VictoriacTorres/euVNA/Tesis/Thesis.tex

\documentclass[11pt,a4paper, table, dvipsnames]{report}
\usepackage{graphicx,float}
\usepackage{wrapfig}
\floatplacement{figure}{H}
\floatplacement{table}{H}
\usepackage[hidelinks]{hyperref}
\usepackage[margin=2.5cm]{geometry}
\usepackage{fancyhdr}
\usepackage{mathtools}

%Configuración general
\pagestyle{fancy}
\fancyhf{}
\fancyfoot[R]{\thepage}
\renewcommand{\headrulewidth}{0pt}
\renewcommand{\footrulewidth}{0pt}

\fancypagestyle{plain}{
    \fancyhf{}
    \fancyfoot[R]{\thepage}
    \renewcommand{\headrulewidth}{0pt}
}

\usepackage{ragged2e}
\usepackage[T1]{fontenc}
\usepackage[utf8]{inputenc}
\usepackage{xcolor}
\usepackage{tabularx} 
\usepackage{url}
\usepackage{caption}
\usepackage{subcaption}
\usepackage{amsmath,amssymb}
\usepackage{indentfirst}
\usepackage{pdfpages}
\usepackage{amsmath}
\usepackage{comment}
\setcounter{secnumdepth}{5}
\setcounter{tocdepth}{5}

%Bibliografia
\usepackage[style=numeric, backend=biber, sorting=none]{biblatex}
\addbibresource{Bibliografia.bib}
\usepackage{hyperref}
\usepackage{xurl}   % después de hyperref
\setcounter{biburlnumpenalty}{100}
\setcounter{biburlucpenalty}{100}
\setcounter{biburllcpenalty}{100}

%Formato codigo
\usepackage{minted}
\usemintedstyle{emacs}

\numberwithin{equation}{section}
\renewcommand{\contentsname}{Índice}
% Portada
\fancypagestyle{firstpage}{
    \fancyhf{}
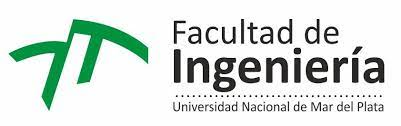
[picture p1: Tesis/Imagenes/fi.jpg]
    \lhead{}
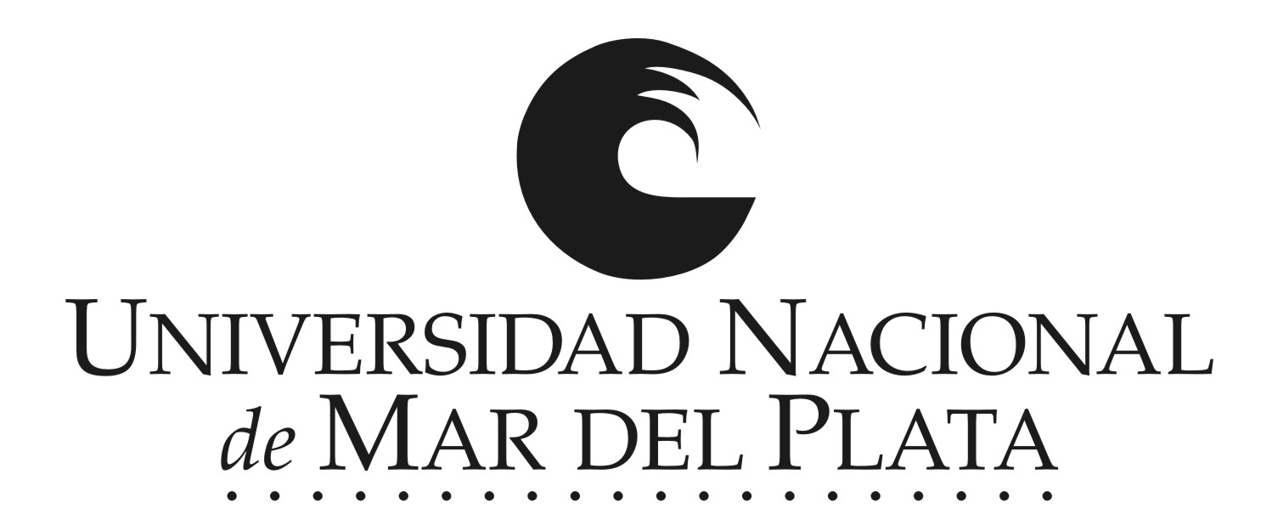
[picture p2: Tesis/Imagenes/UNMDP_BW.jpg]
    \rhead{}
    \renewcommand{\headrulewidth}{0pt}
}
\captionsetup[figure]{name={Figura}}

\newcommand{\Thesis}{Desarrollo de un Analizador Vectorial de Redes para medición no invasiva de glucemia}
\newcommand{\Degree}{Ingeniería Electrónica}
\newcommand{\Name}{Victoria Carla Torres}
\newcommand{\Department}{Departamento de Ingeniería Electrónica y Computación}
\newcommand{\Universidad}{Universidad Nacional de Mar del Plata}
\newcommand{\Place}{Facultad de Ingeniería}
\newcommand{\Fecha}{Noviembre 2026}

\begin{document}

%========= Title Page =========
\begin{titlepage}
\thispagestyle{firstpage}
\pagestyle{empty}
\vspace*{3cm}
\centering

\begin{huge}
\textsc{\Universidad}\\
\vspace{1cm}      
\text{Facultad de Ingeniería}
\end{huge}

\vspace{1cm}

\begin{LARGE}
\begin{center} \text{Trabajo final} \end{center}
\hrule
\vspace{8pt}
\textbf{\Thesis}
\end{LARGE}
\vspace{10pt}
\hrule
\vspace*{\fill}

\begin{Large}
\textbf{\Name}\\[6pt]
\text{Director: Ramiro Avalos Ribas}\\
\text{Codirector: Brian Maximiliano Gluzman}
\end{Large}
\vfill

\begin{figure}[H]
\center
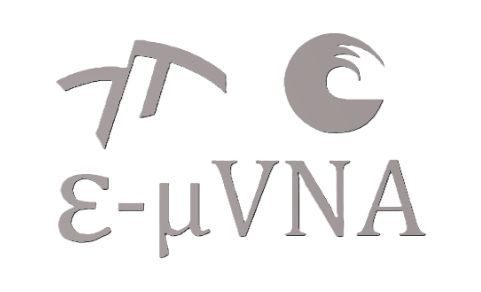
[picture p3: Tesis/Imagenes/Logo.png]

\end{figure}
\vspace{\fill}

\begin{Large}
\text{\Degree}\\
\Department\\
\Fecha\\
\end{Large}

\end{titlepage}
\pagestyle{empty}
\pagenumbering{arabic}
\pagestyle{fancy}
\renewcommand{\chaptername}{Capítulo}

%=============== Agradecimientos ===============
\addcontentsline{toc}{chapter}{Agradecimientos}
{\Huge\bfseries Agradecimientos\par}
\vspace{1.5cm}
\input{Capitulos/Agradecimientos}
\pagebreak

%======== Indice ==================
\tableofcontents
\pagebreak

%========Tabla de siglas================
\addcontentsline{toc}{chapter}{Siglas y abreviaturas}
{\Huge\bfseries Siglas y abreviaturas\par}
\vspace{1.5cm}
\begin{center}
\begin{tabularx}{\textwidth}{|X|X|}
\arrayrulecolor{Thistle}
\hline
\rowcolor{Thistle!20}
\hline 
\textbf{Nombre}  & \textbf{Descripción}  \\
\hline
VNA & Analizador Vectorial de Redes\\
\hline
UHF & Ultra High Frequency (Frecuencia Ultra Alta)\\
\hline
CGM & Continous Glucose Monitoring (Monitoreo Continuo de Glucosa) \\
\hline
CONICET & Consejo Nacional de Investigaciones Científicas y Técnicas \\
\hline
LAC & Laboratorio de Comunicaciones\\
\hline
ICYTE & Instituto de Investigaciones Científicas y Tecnológicas en Electrónica \\
\hline
UNMDP & Universidad Nacional de Mar del Plata \\
\hline
FI & Frecuencia Intermedia\\
\hline
DUT & Device Under Test (Sistema bajo prueba)\\
\hline
RF & Radiofrecuencia \\
\hline
SOL & Short, Open, Load (Corto, Abierto, Carga) \\
\hline
PCB & Printed Circuit Board (Placa de Circuito Impreso) \\
\hline
SMD & Surface-Mount Device (Dispositivo de Montaje Superficial)\\
\hline
USB & Universal Serial Bus (Bus Universal en Serie)\\
\hline
CPU & Central Processing Unit (Unidad de Procesamiento Central) \\
\hline
CLK & Clock (señal de reloj) \\
\hline
OL & Oscilador Local \\
\hline
FIR & Finite Impulse Response (Respuesta al Impulso Finita)\\
\hline
FFT & Fast Fourier Transform (Transformada Rápida de Fourier)\\
\hline
IC & Integrated Circuits (Circuitos Integrados)\\
\hline
VCO & Voltage Controlled Oscillator (Oscilador controlado por voltaje)\\
\hline
PFD & Phase Frequency Detector (Detector de fase y frecuencia) \\
\hline
SMA & SubMiniature version A\\
\hline
SPI & Serial Peripheral Interface (Interfaz Periférica en Serie)\\
\hline
CSV & Comma-Separated Values (Valores separados por coma)\\
\hline
IA & Inteligencia Artificial\\
\hline
GUI & Graphical User Interface (Interfaz Gráfica de Usuario)\\
\hline
QFN & Quad Flat No-Lead (Encapsulado plano cuádruple sin terminales) \\
\hline
ADC & Analog-to-Digital Converter (Conversor Analógico-Digital)\\
\hline

\end{tabularx}
\end{center}

%======= Resumen =======
\addcontentsline{toc}{chapter}{Resumen}
\chapter*{Resumen}

El proyecto propone el diseño, implementación, calibración y ensayo de un Analizador Vectorial de Redes (VNA) de un puerto, que opere en una banda de frecuencias UHF (Ultra High Frequency) que va desde los 1,8 hasta los 2,2 GHz, adaptado para operar en conjunto con un sensor de glucemia no invasivo.

El principio de medición se basa en la existencia de una correlación entre la concentración de glucosa en sangre y sus propiedades eléctricas (permitividad relativa y conductividad) \cite{Topsakal}, por lo que es razonable suponer que las variaciones en la composición dieléctrica de una muestra de tejido biológico pueden alterar la distribución de los campos electromagnéticos presentes en un sensor de microondas.

La implementación se realiza en una placa de circuito impreso, con circuitos integrados especializados y aplicando técnicas de reflectometría, diseño en radiofrecuencia y manejo de emisiones electromagnéticas.

Se obtienen señales analógicas en la banda de audio para su adquisición en la placa de sonido de una PC. Luego, el análisis de las señales es puramente digital. Se aplica un procesamiento basado en la Transformada Rápida de Fourier (FFT) para obtener el coeficiente de reflexión del sistema bajo prueba en función de la frecuencia.
 
\pagebreak

%=========== Introducción ===========
\chapter{Introducción}
\input{Capitulos/Introducción}
\pagebreak

%============= Marco teórico ==========
\chapter{Marco teórico}
\input{Capitulos/Marco teórico}
\pagebreak

%=============== Proyecto ===============
\chapter{Proyecto}
\input{Capitulos/Proyecto}
\pagebreak

%========= Evaluation =========
\chapter{Resultados}
\input{Capitulos/Resultados.tex}
\pagebreak

%========== Conclusiones y trabajos futuros ==========
\chapter{Conclusiones y trabajos futuros}
\input{Capitulos/Conclusiones.tex}
\pagebreak

%========== Esquemáticos y código ==========
\chapter{Esquemáticos}

\section{Esquemáticos Altium}
\label{sec:EsquematicosAltium}
A continuación se presentan los esquemáticos de los distintos bloques funcionales del sistema, exportados de Altium Designer. 

%\begin{comment}
\includepdf[
    pages=-,
    angle=90,
    fitpaper=true,
    addtotoc={
        1, subsection, 2, Generador de RF incidente (ADF4351), sch:ADFRF,
        2, subsection, 2, Generador de RF Oscilador Local (ADF4351), sch:ADFOL,
        3, subsection, 2, Mezclador, sch:mix,
        4, subsection, 2, Alimentación y CLK, sch:alimentacion,
        5, subsection, 2, Acoplador Direccional, sch:acop,
        6, subsection, 2, Amplificadores de FI, sch:amplifi,
        7, subsection, 2, Atenuadores, sch:atenuadores
    }
]{Esquematicos.pdf}
%\end{comment}
\begin{comment}
    
\section{Firmware}
\label{codigoFW}
\inputminted[breaklines, linenos]{cpp}{Codigos/barrido_serial_claude.ino}

\section{Software}
\label{SW}
\inputminted[breaklines, linenos]{python}{Codigos/VNA_calibrado.py}

\section{Interfaz de usuario}
\subsection{Core}
\label{VNA_core}
\inputminted[breaklines, linenos]{python}{Codigos/vna_core_FINAL.py}
\subsection{Graphical User Interface}
\label{VNA_gui}
\inputminted[breaklines, linenos]{python}{Codigos/vna_gui_FINAL.py}

%========== Apéndices ==========
\addcontentsline{toc}{chapter}{Apéndices}
\chapter*{Apéndices}
\setcounter{section}{0}
\renewcommand{\thesection}{\Alph{section}}

\includepdf[pages=-, scale=1, pagecommand={}, addtotoc={1, section, 1, Estudio Preliminar, apend:Estudio_Preliminar}]{Apendices/Estudio Preliminar.pdf}

\includepdf[pages=-, scale=1, pagecommand={}, addtotoc={1, section, 1, Plan de Trabajo, apend:PProy}]{Apendices/Pproy.pdf}

\includepdf[pages=-, scale=1, pagecommand={}, addtotoc={1, section, 1, Especificación de Requerimientos, apend:ER}]{Apendices/ER.pdf}

\includepdf[pages=-, scale=1, pagecommand={}, addtotoc={1, section, 1, Especificación Funcional, apend:EF}]{Apendices/EF.pdf}

\includepdf[pages=-, scale=1, pagecommand={}, addtotoc={1, section, 1, Especificación Técnica, apend:ET}]{Apendices/Especificación Técnica.pdf}

\includepdf[pages=-, scale=1, pagecommand={}, addtotoc={1, section, 1, Plan de Pruebas, apend:PP}]{Apendices/Plan de pruebas.pdf}

\end{comment}
%=========== Bibliografía ===========
\printbibliography[heading=bibintoc, title={Bibliografía}]

\end{document}
