VictoriacTorres/euVNA/Tesis/Capitulos/Marco teórico.tex

\section{Analizador Vectorial de Redes}
El Analizador Vectorial de Redes fue definido en sus inicios como un instrumento que permite medir los parámetros de redes eléctricas \cite{Tektronix}. En su esquema más básico posee una fuente de radiofrecuencias (RF), que genera una señal de estímulo para el dispositivo bajo prueba, y un banco de receptores que miden las señales que salen del DUT y las comparan con la onda incidente. Los resultados se procesan y muestran al usuario por medio de alguna interfaz.

Dependiendo de los dispositivos que se buscan caracterizar, se determina la cantidad de puertos que debe tener el VNA. Un puerto permite medir el parámetro de reflexión. Con dos puertos, se puede medir además el de transmisión. Si posee un solo canal, se puede medir la transmisión inversa y la reflexión en la salida invirtiendo físicamente el dispositivo bajo prueba. Este paso se puede evitar agregando un canal, lo que incrementa el costo del VNA.

\section{Parámetros de dispersión (S)}
Los parámetros de dispersión, también llamados S por su nombre en inglés (\textit{Scattering}) permiten caracterizar redes de dos o más puertos en función de sus ondas entrantes y salientes. Se especifican para una impedancia de referencia y a una frecuencia específica, y son útiles en altas frecuencias porque otros tipos de parámetros (como los Z o los Y) no pueden ser medidos directamente.  

 \begin{figure}[H]
    \centering
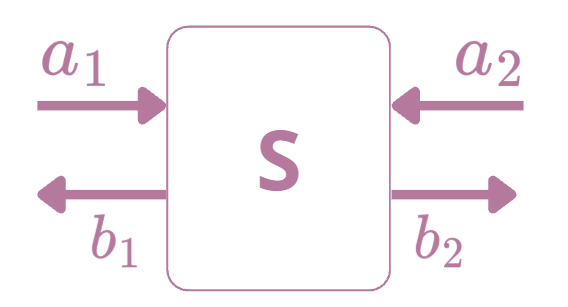
[picture p18: Tesis/Imagenes/par_S.png]
    
    \caption{Parámetros S en una red de dos puertos}
 \label{parS}
 \end{figure}

Según las ondas entrantes $a_{1}$ y $a_{2}$ y las salientes $b_{1}$ y $b_{2}$, los parámetros S se definen como:

\begin{equation}
    S_{11} = \left. \frac{b_1}{a_1} \right|_{a_2=0}; \quad
    S_{12} = \left. \frac{b_1}{a_2} \right|_{a_1=0}; \quad
    S_{21} = \left. \frac{b_2}{a_1} \right|_{a_2=0}; \quad
    S_{22} = \left. \frac{b_2}{a_2} \right|_{a_1=0}
    \label{eq:parametros_S}
\end{equation}

Para lograr que las $a$ sean iguales a 0, el puerto al que pertenecen debe estar adaptado, garantizando que no haya ninguna señal incidente. 

\subsection{Parámetro S11}
El parámetro $S_{11}$ representa la relación entre la onda reflejada y la incidente en el puerto 1, y es numéricamente igual al coeficiente de reflexión $\Gamma$. Se puede definir en función de la impedancia característica del sistema $Z_{0}$ y la impedancia de carga $Z_{L}$ (es decir, del sistema bajo prueba) como muestra la ecuación \ref{ecs11}:
\begin{equation}
    \label{ecs11}
    S_{11}(DUT) = \Gamma = \frac{Z_{L}-Z_{0}}{Z_{L}+Z_{0}}
\end{equation}

Expresado en dB, se puede escribir:

\begin{equation}
    S_{11}(DUT)[dB]= 20 . log(|\Gamma|)
\end{equation}

\subsection{Calibración S11}
\subsubsection{Errores}
\label{sec:errores}
Los errores que pueden aparecer en una medición se pueden dividir en dos grandes clases: los errores sistemáticos y los aleatorios. Los primeros se pueden corregir, mientras que los segundos se encuentran en toda medición y están fuera del control del usuario.

En el caso de dispositivos electrónicos algunos errores sistemáticos son los producidos por variaciones en la potencia de salida de los generadores, pérdidas de inserción en materiales conductores y conectores, desfasajes ocasionados por diferencias en longitudes eléctricas o retardos en los circuitos integrados, reflexiones generadas por desadaptación de impedancias y deriva térmica. Algunos errores aleatorios pueden ser ruido térmico, de cuantización e interferencia electromagnética.

La calibración en un VNA permite corregir los errores sistemáticos, excluyendo: comportamientos alineales; repetibilidad en conectores; errores en las cargas de calibración; y deriva térmica. Este último se puede corregir solo si la calibración se realiza inmediatamente antes de la medición.

\subsubsection{Método SOL}
En VNAs de un puerto se pueden simplificar los errores a un modelo de tres términos que describen la directividad, adaptación del puerto y errores de seguimiento (variaciones de amplitud y fase en función de la frecuencia)\cite{Rytting}. Usando tres cargas distintas de valores conocidos, se puede formar un sistema de tres ecuaciones con tres incógnitas y resolver para obtener los términos del error:

\begin{subequations}\label{eq:sistema_calibracion}
\begin{align}
    e_{00} + \Gamma_1 \Gamma_{\text{M}1} e_{11} - \Gamma_1 \Delta_e &= \Gamma_{\text{M}1} \label{eq:calib1} \\
    e_{00} + \Gamma_2 \Gamma_{\text{M}2} e_{11} - \Gamma_2 \Delta_e &= \Gamma_{\text{M}2} \label{eq:calib2} \\
    e_{00} + \Gamma_3 \Gamma_{\text{M}3} e_{11} - \Gamma_3 \Delta_e &= \Gamma_{\text{M}3} \label{eq:calib3}
\end{align}
\end{subequations}

Donde $\Gamma_{\text{M}}$ es el parámetro de reflexión medido para cada carga, $e_{00}$ es la directividad, $e_{11}$ la adaptación del puerto, $e_{10}e_{01}$ el error de seguimiento (\textit{tracking}) y $\Delta_e=e_{00}e_{11}-(e_{10}e_{01})$. Los términos del error se pueden observar en la figura \ref{errorescalibracion}.

Si las cargas independientes son un circuito abierto, cortocircuito y carga de 50$\Omega$ entonces el método de calibración se denomina SOL (Short, Open, Load) y las ecuaciones \ref{eq:sistema_calibracion} se simplifican a las \ref{eq:sistema_SOL}. 

 \begin{figure}[H]
    \centering
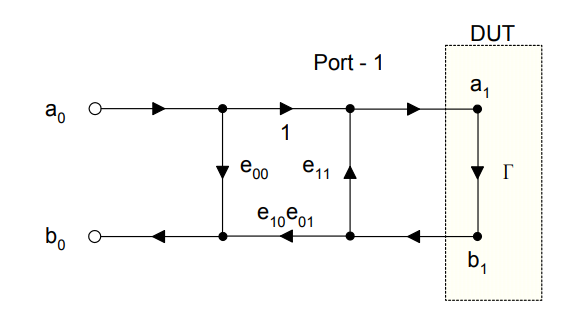
[picture p19: Tesis/Imagenes/errorescalibracion.png]
    
    \caption{Términos de error para un VNA de un puerto}
    \label{errorescalibracion}
 \end{figure}

\begin{subequations}\label{eq:sistema_SOL}
\begin{align}
    e_{00} - \Gamma_{\text{MS}} e_{11} + \Delta_e &= \Gamma_{\text{MS}} \label{eq:sol_s} \\
    e_{00} + \Gamma_{\text{MO}} e_{11} - \Delta_e &= \Gamma_{\text{MO}} \label{eq:sol_o} \\
    e_{00} &= \Gamma_{\text{ML}} \label{eq:sol_l}
\end{align}
\end{subequations}

Luego el $\Gamma$ real se calcula como:

\begin{equation}
    \Gamma= \frac{\Gamma_{M}-e_{00}}{\Gamma_{M}e_{11}-\Delta_{e}} \label{eq:correcciongamma}
\end{equation}

\section{Acoplador Direccional}
En la mayoría de diseños en electrónica, el acoplamiento electromagnético entre líneas de transmisión se considera indeseable porque interfiere con la señal que se busca transmitir. Una excepción es el caso de acopladores, donde el acoplamiento es un parámetro de diseño que permite medir la señal de una línea con un alto aislamiento, es decir, sin interrumpir su paso. Además se pueden diseñar un par de líneas acopladas que verifiquen que en uno de sus puertos la señal incidente se anula, generando un punto que permite medir la onda reflejada. 

Las principales propiedades que caracterizan un acoplador son la directividad, el aislamiento, el acoplamiento y la pérdida de inserción \cite{acopladores_minicircuits}. La directividad mide la capacidad de separar las ondas que se propagan en distintas direcciones. El aislamiento, la potencia que llega al puerto desacoplado. El acoplamiento indica la proporción de potencia que se entrega al puerto acoplado. La pérdida de inserción muestra cuánta potencia (que se debería transmitir) se pierde por ser entregada a los puertos acoplados y aislados, y las pérdidas en los materiales (dieléctrico y resistividad de las pistas). 

Un acoplador ideal es un dispositivo pasivo, que posee directividad y aislamiento infinitos. 

Existen acopladores direccionales como el HP 778d \cite{keysight_778d} que posee una directividad mayor a 36dB y pérdidas por inserción menores a 0,6dB, pero tiene un ancho de banda que permite hacer mediciones entre 100 MHz y 2 GHz, y sus dimensiones físicas y peso hacen que su utilidad se limite a mediciones en laboratorio. Para soluciones integradas hay alternativas comerciales como el ZABDC20-322 de Minicircuits \cite{minicircuits_zabdc20} pero su costo hace que el diseño no sea escalable. 

\subsection{Puente resistivo}
Una solución compacta, económica y con un ancho de banda teórico infinito es el puente resistivo tipo Wheatstone. Como se puede observar en la figura \ref{fig:puente_wheatstone} es una red simple de comparación de impedancias, formada por cuatro resistencias sobre las cuales se inyecta una señal de referencia en la parte superior. Una de las resistencias es variable (Zx), mientras que el resto son iguales entre sí. Se utiliza un voltímetro para medir la diferencia de potencial entre las ramas. Si la resistencia variable es de 50$\Omega$, el puente queda balanceado y el voltímetro indica un cero. Si es menor a 50$\Omega$, la rama izquierda presenta un voltaje menor a la derecha, mientras que para valores mayores ocurre lo opuesto.
La tensión en el nodo de referencia $v_A$ en función de la tensión incidente $v_{inc}$ resulta:
\begin{equation} 
    v_{A} = v_{inc} \cdot \frac{Z_{0}}{Z_{0} + Z_{0}} = \frac{v_{inc}}{2}
\end{equation}
Mientras que la tensión en el nodo de medición $V_B$ es: \begin{equation} 
    v_B = v_{inc} \cdot \frac{Z_{x}}{Z_{0} + Z_{x}} 
\end{equation}

Por lo tanto, la señal desbalanceada o tensión diferencial reflejada $v_{diff}(t)$ entre ambos nodos se define como: 
\begin{subequations} 
    \begin{align}
        v_{diff}(t) = v_{B}(t) - v_{A}(t) \\
        v_{diff}(t) = v_{inc}(t) \left[ \frac{Z_{x}}{Z_{0} + Z_{x}} - \frac{1}{2} \right] 
    \end{align} 
\end{subequations} 

Reescribiendo la resta interna con común denominador $\frac{Z_{x}}{Z_{x} + Z_{0}} - \frac{1}{2} = \frac{1}{2}\left[\frac{Z_{x} - Z_{0}}{Z_{x} + Z_{0}}\right]$ entonces: 
\begin{equation}
    v_{diff}(t) =
    \frac{v_{inc}(t)}{2} \cdot
    \underbrace{
        \left[\frac{Z_x-Z_0}{Z_x+Z_0}\right]
    }_{\mathclap{\text{Coeficiente de reflexión }(\Gamma)}}
    = \frac{v_{inc}(t)}{2}\cdot\Gamma
\end{equation}

Si la señal incidente es sinusoidal es posible además caracterizar cargas reactivas midiendo el desfasaje de la señal Zx respecto de la incidente. Este es el principio que permite al puente comportarse como un acoplador direccional: la diferencia de potencial entre las ramas es función de la onda reflejada equivalente.  

\begin{figure}
    \centering
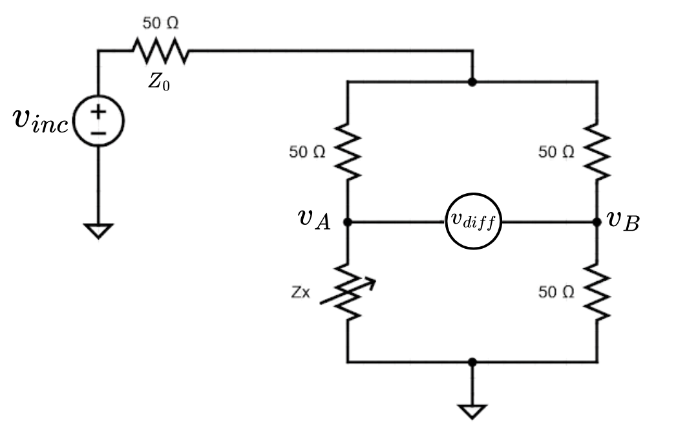
[picture p20: Tesis/Imagenes/puente_wheatstone.png]
    
    \caption{Esquema básico de un puente de Wheatstone}
    \label{fig:puente_wheatstone}
\end{figure}

Para una aplicación de reflectometría, la magnitud de la impedancia de entrada al DUT haría las veces del Zx a caracterizar en este esquema simplificado. Esto, además de la capacidad de lograr directividad y ancho de banda elevados, lo vuelve una alternativa muy conveniente a la hora de implementar un VNA que funcione con buena sensibilidad en un rango amplio de frecuencias.

\section{Buenas prácticas de diseño en RF}
Al momento de rutear un PCB (\textit{Printed Circuit Board} - Placa de Circuito Impreso) se deben tener en consideración algunas buenas prácticas que ayudan a mantener la integridad de las señales, la impedancia de las líneas y evitar la interferencia electromagnética, sobre todo cuando se trabaja en RF. 

Se debe garantizar que las pistas cumplan con la impedancia requerida de 50$\Omega$. Esto implica calcular el ancho de la línea usando las ecuaciones de diseño según el tipo de línea y las características de los materiales a utilizar (generalmente brindadas por el fabricante de PCB). Se pueden encontrar calculadoras online o integradas en los software de diseño con este fin. Se deben evitar ángulos rectos, que causan discontinuidades y aumentan la capacitancia parásita. 

El plano de masa que se encuentra debajo de las pistas de RF debe ser continuo, para que la corriente de retorno pueda seguir el camino de menor inductancia. Por esta razón no se recomienda rutear en el plano inferior al de las rutas de RF, pero si se necesita hacerlo no se deben atravesar las regiones donde en la capa superior haya trazos de RF.

Se deben usar las técnicas \textit{vía stitching} y \textit{vía shielding}. La segunda se usa para reducir la interferencia electromagnética y el crosstalk \cite{altium_via_stitching}, mientras que la primera "ata" los planos de masa de distintas capas, ayudando a mantener baja impedancia y caminos de retorno cortos. Además evita resonancias dentro de la placa.

Los capacitores de desacople se deben ubicar lo más cerca posible de los integrados, de forma de poder suministrar rápidamente los picos de corriente que demandan los integrados que la fuente de alimentación no puede entregar \cite{altium_caps_desacople}. También deben utilizarse cuando se suministra alimentación a un trazo a través de vías.

Los trazos deben ser lo más cortos posible, para minimizar la atenuación de las señales y reflexiones indeseadas.

\section{Heterodinación de señales}
Las señales que se intentan medir en un VNA son de naturaleza analógica, por lo que para realizar el cálculo del parámetro de reflexión o S11 primero se debe poder medir su amplitud y fase. Existen integrados que pueden obtener la magnitud de una onda de RF como el HMC601 \cite{AnalogDevices_HMC601} pero se pierde información de la fase. Por eso se busca una forma de bajar la frecuencia de la señal para poder adquirirla de forma digital.

Un esquema heterodino se basa en la combinación de una señal de RF de interés con otra señal generada localmente por un oscilador local (OL o LO por sus siglas en inglés) desplazada en frecuencia un valor constante, llamado frecuencia intermedia (FI). 

Cuando se multiplican idealmente en el dominio del tiempo dos señales sinusoidales $v_{RF}(t)= A_{RF}\cos(2\pi f_{RF}t)$ y $v_{OL}(t)= A_{LO}\cos(2\pi(f_{RF}+f_{IF})t)$ (suponiendo que tienen la misma fase inicial), a la salida existen componentes espectrales en la suma y diferencia de las frecuencias originales:

\begin{subequations}
\begin{align}
v_{mix}(t) &= k \cdot v_{RF}(t) \cdot v_{LO}(t) \\
v_{mix}(t) &= k A_{RF} A_{LO}\cos(2\pi f_{RF}t)\cos(2\pi (f_{RF}+f_{IF})t) \\
\end{align}
\end{subequations}

Reescribiendo con la identidad trigonométrica $\cos(\alpha)\cos(\beta) = \frac{1}{2}\left[\cos(\alpha-\beta)+\cos(\alpha+\beta)\right]$ entonces:
\begin{subequations}
\begin{align}
v_{mix}(t) &= \frac{k A_{RF} A_{LO}}{2}\left[\underbrace{\cos\left(
2\pi f_{FI}t\right)}_{\text{Componente Resta (FI)}}
\right.\left.+\underbrace{ \cos\left(2\pi(2 f_{RF}+f_{FI})t\right)
}_{\text{Componente Suma (Alta Frecuencia)}} \right]
\end{align}
\end{subequations}

Mediante un filtrado se puede aislar la componente diferencia, logrando así trasladar la información de la señal de RF hacia la FI:

\begin{equation}
v_{\text{IF}}(t) = \frac{k A_{\text{RF}}A_{LO}}{2} \cos\left(2\pi f_{\text{IF}} t\right)
\end{equation}

Utilizando un mezclador doble se pueden heterodinar dos señales con un solo oscilador local, como muestra la figura \ref{fig:mixer} . De esta forma obtienen las señales incidente y reflejada, conservando su amplitud y fase, en una frecuencia de audio que facilite su adquisición y procesamiento.

\begin{figure}
    \centering
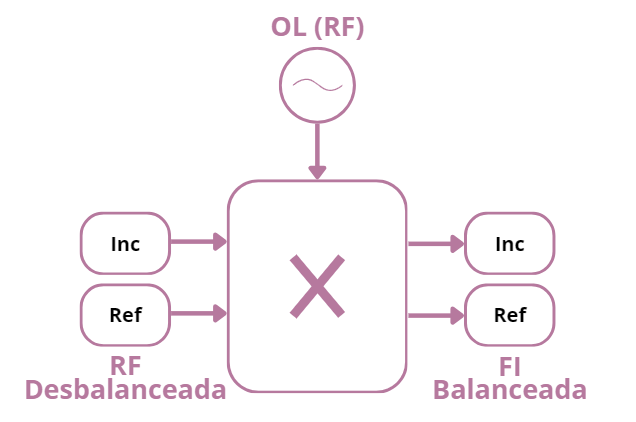
[picture p21: Tesis/Imagenes/mixer.png]
    
    \caption{Heterodinación de señales}
    \label{fig:mixer}
\end{figure}

\section{Procesamiento digital de señales}

Para poder aplicar un procesamiento digital cualquier señal analógica continua en el tiempo debe ser muestreada, es decir convertirla en una secuencia de números de precisión finita. El proceso implica una pérdida de información de los intervalos intermedios, pero según el teorema de Nyquist-Shannon una señal de banda limitada puede reconstruirse inequívocamente a partir de sus muestras si la frecuencia de muestreo $f_s$ cumple la condición $f_s \ge 2 f_{\max}$, donde $f_{\max}$ representa la componente frecuencial de mayor valor de la señal \cite{TDSmanolakis}.

Una vez que la señal está digitalizada, para poder extraer su amplitud y fase, sabiendo que se encuentra a una frecuencia de valor FI, se debe aplicar un filtrado digital y realizar la Transformada Rápida de Fourier (FFT - \textit{Fast Fourier Transform})

\subsection{Filtros digitales}
El objetivo principal de la etapa de filtrado es aislar la señal de FI eliminando el ruido de banda ancha, las interferencias de baja frecuencia y armónicos de orden superior. 

La señal muestreada $x[n]$ pasa por un filtro pasabanda digital caracterizado por una respuesta al impulso $h[n]$. La operación se define mediante la convolución discreta, donde la salida es $y[n]$:
\begin{equation}
    y[n] = x[n] * h[n] = \sum_{k=0}^{M} h[k] \, x[n-k]
\end{equation}
donde $M$ representa el orden del filtro. Los coeficientes $h[k]$ se diseñan para configurar una banda de paso en torno a la frecuencia de FI.

Los filtros digitales se pueden clasificar en dos grandes familias según la naturaleza de su respuesta al impulso: filtros de respuesta finita (\textit{Finite Impulse Response}, FIR) y filtros de respuesta infinita (\textit{Infinite Impulse Response}, IIR).

Un filtro IIR se caracteriza por una respuesta al impulso de duración infinita, que se logra mediante una estructura recursiva con realimentación de las salidas anteriores. Su ecuación en diferencias se expresa en función de los coeficientes $a_k$ y $b_k$ como:
\begin{equation}
    y[n] = \sum_{k=0}^{M} b_k \, x[n-k] + \sum_{k=1}^{N} a_k \, y[n-k]
\end{equation}

La presencia de los coeficientes $a_k$, que ponderan las muestras pasadas de la propia salida, introduce polos en el plano z fuera del origen. Si bien permiten lograr bandas de transición abruptas con órdenes bajos, presentan dos desventajas fundamentales: no garantizan fase lineal en toda la banda de paso y pueden ser inestables si sus polos migran fuera del círculo unitario debido a cuantización de precisión finita.

Por otro lado, un filtro FIR presenta una respuesta al impulso de duración finita $N_{\text{taps}}$ (comúnmente denominada número de coeficientes o \textit{taps}), siendo $h[n] = 0$ para $n < 0$ y $n \ge N_{\text{taps}}$. Su ecuación en diferencias es puramente no recursiva:
\begin{equation}
    y[n] = \sum_{k=0}^{M} b_k \, x[n-k] = \sum_{k=0}^{N_{\text{taps}}-1} h[k] \, x[n-k]
\end{equation}
donde $M = N_{\text{taps}} - 1$ representa el orden del filtro. Su transferencia $H(z)$ es causal, estable y realizable. Todos sus polos se ubican de manera trivial en el origen ($z = 0$), lo que garantiza estabilidad incondicional.

Si la secuencia de coeficientes $h[n]$ cumple la condición de simetría par alrededor de su centro ($h[n] = h[N_{\text{taps}}-1-n]$), la respuesta en frecuencia presenta la forma:
\begin{equation}
    H(e^{j\omega}) = |H(e^{j\omega})| \, e^{-j \omega \tau_g}
\end{equation}
donde el retardo de grupo $\tau_g$ es estrictamente constante para todas las frecuencias:
\begin{equation}
    \tau_g = \frac{N_{\text{taps}} - 1}{2} \quad \text{[muestras]}
\end{equation}
Un retardo de grupo constante asegura que el filtro no introduce distorsión de fase no lineal, preservando la diferencia de fase relativa entre el canal de referencia ($V_{\text{ref}}$) y el de medición ($V_{\text{med}}$).

\subsubsection{Diseño de filtros FIR mediante el método del enventanado}

La forma más simple de diseño de filtros FIR es el llamado método del enventanado (\textit{window design method}) \cite{TDSoppenheim}. Este método consiste en truncar y desplazar la respuesta al impulso ideal de duración infinita, $h_d[n]$ (correspondiente a un filtro pasabanda ideal centrado en $f_{\text{FI}}$), multiplicándola punto a punto por una función ventana finita $w[n]$ de longitud $N_{\text{taps}}$:
\begin{equation}
    h[n] = h_d[n] \cdot w[n], \quad 0 \le n \le N_{\text{taps}}-1
\end{equation}

Una de las posibles ventanas a utilizar es la Hamming, definida  como:
\begin{equation}
    w[n] = 0{,}54 - 0{,}46 \cos\left( \frac{2\pi n}{N_{\text{taps}} - 1} \right), \quad 0 \le n \le N_{\text{taps}}-1
\end{equation}

La multiplicación en el dominio del tiempo equivale a la convolución periódica de la respuesta en frecuencia ideal con el espectro de la ventana, $W(e^{j\omega})$. La ventana de Hamming tiene como características principales:
\begin{itemize}
    \item Atenuación en banda de rechazo: Proporciona un nivel de lóbulo secundario pico de aproximadamente $-41\text{ dB}$ y una atenuación mínima en la banda de rechazo de $-53\text{ dB}$.
    \item Suavizado del fenómeno de Gibbs: Elimina las oscilaciones de sobrepico en los bordes de la banda de paso típicas del truncamiento rectangular estricto, a cambio de un lóbulo central más ancho.
\end{itemize}

\subsection{Transformada Rápida de Fourier}
Para determinar la amplitud y fase de las señales de FI, las secuencias filtradas en el dominio del tiempo se transforman al dominio de la frecuencia mediante la Transformada Discreta de Fourier (DFT), calculada a través del algoritmo de la Transformada Rápida de Fourier (FFT). Para una secuencia de $N$ muestras con salida $X[k]$, la expresión de análisis viene dada por \cite{TDSmanolakis}:
\begin{equation}
    X[k] = \sum_{n=0}^{N-1} x[n] \, w[n] \, e^{-j \frac{2\pi}{N} k n}, \quad k = 0, 1, \dots, N-1
\end{equation}
donde $w[n]$ representa la función de la ventana aplicada a la secuencia temporal.

Dado que la captura se realiza sobre una ventana de observación finita, si la duración del intervalo de adquisición no contiene un número entero exacto de ciclos de la señal, se produce el fenómeno de fuga espectral (\textit{spectral leakage}). Este fenómeno dispersa la energía de la frecuencia fundamental hacia los bins frecuenciales adyacentes, degradando la precisión en la estimación de amplitud y fase. Para mitigar este efecto, se aplica una función de enventanado $w[n]$. La ventana \textit{Flattop} se caracteriza por presentar un lóbulo principal ancho y plano; esta propiedad minimiza el error de estimación de amplitud, mejorando la exactitud en la medición de niveles de tensión.
