VictoriacTorres/euVNA/Tesis/Capitulos/Proyecto.tex

\section{Descripción general del producto}

Como describe la sección 2 de la Especificación de Requerimientos (\cite{ER}) el sistema debe generar un barrido de frecuencias en el rango de 1,8 a 2,2 GHz. La señal se debe inyectar en el DUT y se debe medir la onda reflejada. Ambas ondas (incidente y reflejada) deben bajarse a una frecuencia intermedia para luego adquirirlas y digitalizarlas con el fin de realizar el procesamiento correspondiente. Un diagrama en bloques detallado del sistema se puede observar en la figura \ref{fig:diagbloques}. Los datos a asumir, requerimientos y pautas de diseño se pueden encontrar en la Especificación de Requerimientos (\cite{ET}). 

\begin{figure}
    \centering
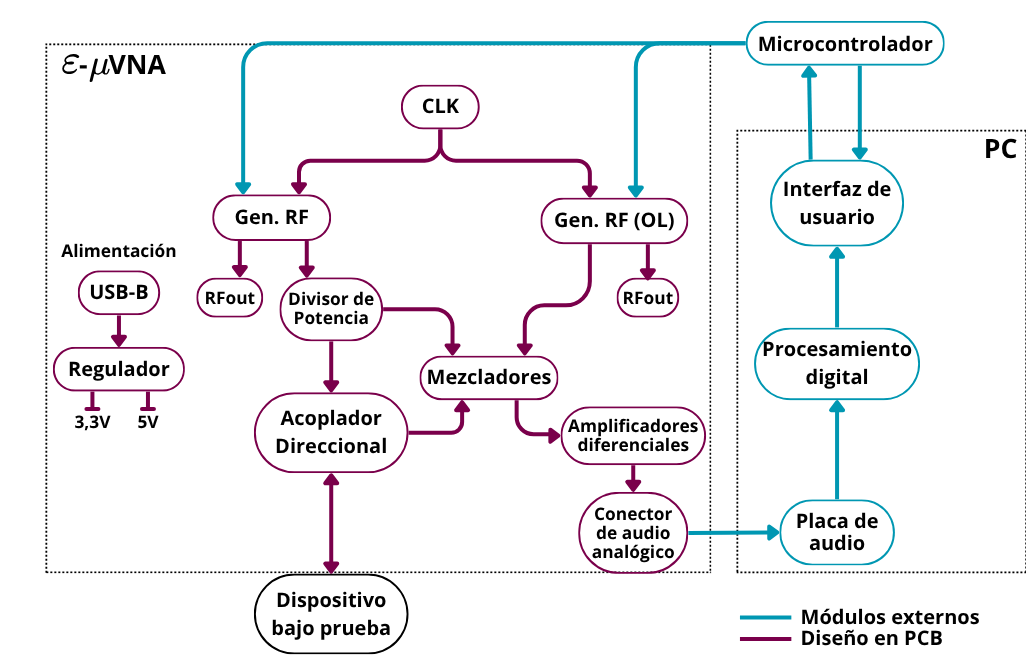
[picture p22: Tesis/Imagenes/diagbloques.png]
    
    \caption{Diagrama en bloques del sistema}
    \label{fig:diagbloques}
\end{figure}

A continuación, se detalla la solución del hardware, software, firmware e interfaz de usuario. Todos los códigos utilizados se encuentran disponibles en el
repositorio público de GitHub \cite{codigosTesis}.

\section{Hardware}
El hardware se diseñó en su totalidad en el software Altium Designer, con una licencia estudiantil gracias al programa Altium Student Lab \cite{altium_designer}. Se creó una librería con los esquemáticos, footprints y modelos 3D de los componentes a utilizar. Se dividió el proyecto en esquemáticos que representan los distintos bloques funcionales, que se pueden observar en el capítulo ``Esquemáticos'' (\ref{sec:EsquematicosAltium}). Se puede encontrar una descripción general de cada bloque en la Especificación Técnica (\cite{ET}).

\subsection{Generadores de RF}
Como explica la sección 2.1.2 de la Especificación Técnica (\cite{ET}) los generadores de RF se sintetizan con los circuitos integrados (IC - \textit{Integrated Circuits}) ADF4351. Este es un sintetizador de banda ancha con VCO integrado, con frecuencia de salida configurable de 40 a 4400 MHz y potencia de salida máxima de 5dBm \cite{datasheet_ADF4351}. El hardware posee dos; uno incide directamente en el acoplador direccional, desviando una parte de su potencia hacia el mezclador para medir la señal incidente. El esquemático de su implementación se puede ver en \ref{sch:ADFRF}. El otro se utiliza como oscilador local para el esquema heterodino (esquemático en \ref{sch:ADFOL}). Es relevante mencionar que las salidas de RF no es una sinusoidal pura perfecta, sino que incluye componentes armónicos generados por el VCO y la etapa de salida. La hoja de datos aclara que el segundo armónico se encuentra entre -19 y -20 dBc por debajo de la potencia de la fundamental, mientras que el tercer armónico se encuentra entre -10 dBc y -13 dBc por debajo. 

El diagrama en bloques del chip se puede observar en la figura \ref{fig:diagADF}:

\begin{figure}
    \centering
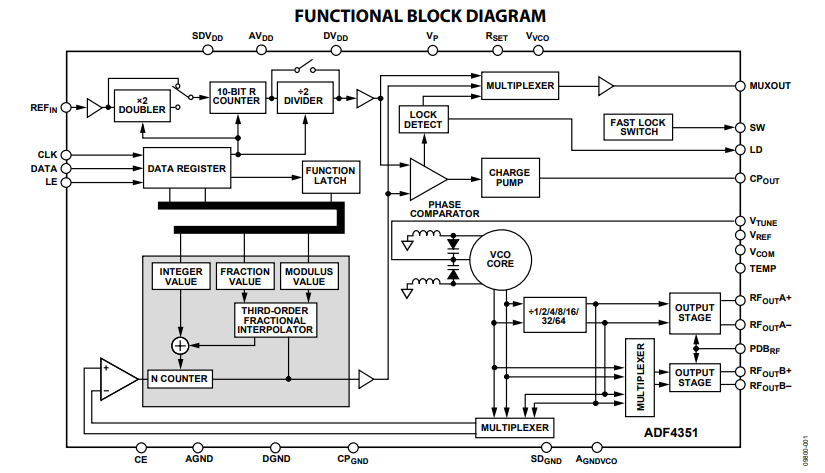
[picture p23: Tesis/Imagenes/diagADF.png]
    
    \caption{Diagrama en bloques del integrado ADF4351}
    \label{fig:diagADF}
\end{figure}

Algunas consideraciones que se tuvieron en cuenta al momento de diseñar y rutear fueron:

\begin{itemize}
    \item Tensión de alimentación (Vcc) de 3,3 V, ya que soporta de 3 a 3,6 V. Esta tensión debe ir a pines que se encuentran distribuidos en todos los lados del integrado, por lo que al estar ingresando con señales de RF se debe tener especial cuidado en el ruteo para mantener la integridad de las señales.
    \item El pad central expuesto del IC debe ser soldado a un pad GND (tierra) de al menos su mismo tamaño por razones térmicas, por indicación del datasheet \cite{datasheet_ADF4351}. Además, se sugiere colocar vías para mejorar el comportamiento térmico.
    \item La salida de RF es de colector abierto, por lo que para funcionar necesita una etapa de pull-up: la forma más sencilla (y de banda ancha) de hacerlo es con una resistencia de 50 $\Omega$ a $V_{VCO}$. De esta forma la salida del circuito es una potencia que equivale al valor registrado en el registro 4 (R4) (ver sección firmware \ref{sec:Firmware}). Por la misma razón, por usarse en modo desbalanceado, la salida de la rama que se deja sin usar debe terminarse en una resistencia de 50 $\Omega$. En este caso, se coloca una línea de transmisión hacia un conector SMA para mediciones auxiliares que en caso de no utilizarse, debe adaptarse. Se incluyó en el diseño un pad opcional para soldar una resistencia de 50 $\Omega$ una vez que no se necesiten los conectores.
    \item Es importante que la señal  $V_{TUNE}$, una continua que es la entrada de control del VCO, esté libre de ruido, ya que determina la frecuencia de salida y es vital para el correcto enganche.
    \item La hoja de datos recomienda poner capacitores de desacople lo más cerca posible de los pines $V_{P}$, $AV_{DD}$, $V_{VCO}$, $TEMP$, $V_{COM}$, $V_{REF}$, $DV_{DD}$, y $SDV_{DD}$.
    \item Los pines que se utilizan para programar el integrado son una entrada de alta impedancia CMOS, con un límite máximo de 3,6 V. Para protegerlas por incompatibilidad de niveles lógicos, se utilizan atenuadores en cada una de las entradas (CLK, CE, LE, DATA) (\ref{sch:atenuadores}).
    \item Se coloca un LED en la salida de detección de enganche, para visualizar rápidamente si el integrado está enganchado.  
\end{itemize}

\subsubsection{Filtro externo de lazo de control}
El filtro de lazo se diseña en la aplicación del fabricante, Analog Devices, ADISIMPLL 5.9 \cite{software_ADIsimPLL}. Se busca que cumpla con un margen de fase mínimo de 45° para preservar la estabilidad del sistema, y que el ancho de banda sea lo mayor posible para disminuir el tiempo de enganche, a costa de un incremento en el ruido que ingresa al lazo que proviene de la referencia, del detector de fase y la bomba de carga.

El esquema final se puede observar en el entorno del software en la figura \ref{fig:esqadisim}.
\begin{figure}
    \centering
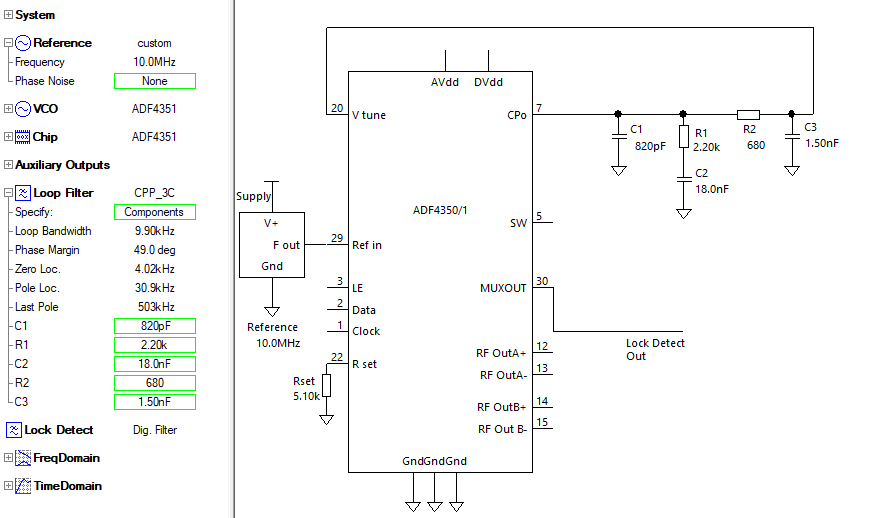
[picture p24: Tesis/Imagenes/adisim1.png]
    
    \caption{Diseño del filtro de lazo externo}
    \label{fig:esqadisim}
\end{figure}

La respuesta en frecuencia del sistema ADF4351 +  filtro diseñado, simulada para 2 GHz, se muestra en la figura \ref{fig:bodesadisim} 
\begin{figure}
    \centering
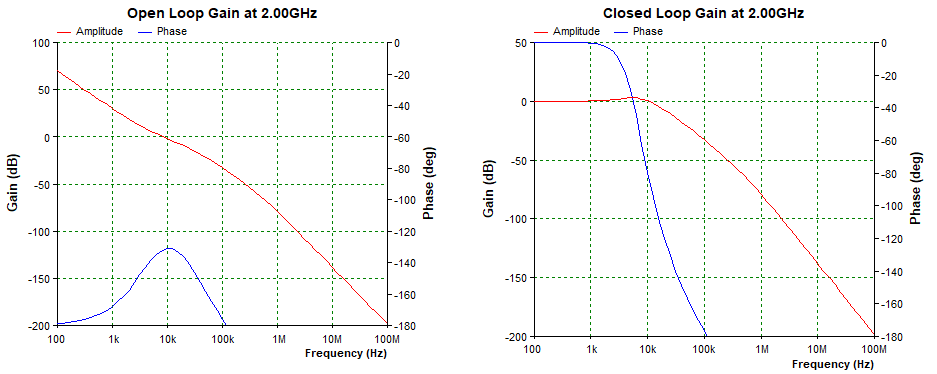
[picture p25: Tesis/Imagenes/adisimbodes.png]
    
    \caption{Respuesta en frecuencia de los generadores}
    \label{fig:bodesadisim}
\end{figure}

\subsection{Oscilador}
La referencia para los generadores de RF se compone de un oscilador a cristal ECS-2200BX-100 \cite{ecs2200x_datasheet} que proporciona una salida cuadrada y un buffer con salida open drain 74LVC2G07W6-7 \cite{datasheet_74lvc2g07}. Este permite no solo aumentar el fan-out (dividiendo la señal en dos caminos sin degradarla) sino realizar un reacondicionamiento. De esta manera se reduce el crosstalk (aislando las entradas de los generadores entre sí) y el ringing (oscilaciones de reflexión), garantizando flancos más limpios y rápidos. Se colocan dos resistencias de 47 $\Omega$ para absorber las ondas reflejadas que existan en la línea debido a que la entrada de referencia de los ADF es de alta impedancia y limitar la corriente de conmutación (ayudando a reducir el ruido de alta frecuencia). El esquemático se encuentra en la sección \ref{sch:alimentacion}.

\subsection{Mezclador}
 
El multiplicador se implementa con un IC ADL5802, un mezclador activo de alta linealidad, de dos canales, doble balanceado, con buffers de OL integrados para proveer conversión de frecuencia con alto rango dinámico. Su esquemático se puede observar en la sección \ref{sch:mix}.

Su función principal es realizar la heterodinación de las señales de radiofrecuencia. Se aplica la señal proveniente del DUT a la entrada de RF, y la del ADF4351 que actúa de OL a la entrada correspondiente. 

El integrado se alimenta con una tensión continua de 5 V. Sus salidas en FI son de colector abierto con una impedancia diferencial de 200 $\Omega$, por lo que se colocan resistencias de pull-up de 50 $\Omega$ conectadas a la línea de 5 V para su correcta polarización. 

Las salidas diferenciales del integrado permiten obtener las componentes correspondientes a las señales incidente y reflejada, identificadas como $IF\_INC+$, $IF\_INC-$, $IF\_MED+$ e $IF\_MED-$ en el esquemático \ref{sch:mix}. A la salida de cada canal se integran filtros pasabajo RC, calculados para atenuar la componente suma de alta frecuencia ($2f_{\text{RF}} + f_{\text{FI}}$) y dejar pasar únicamente las señales diferenciales de baja frecuencia correspondientes a la FI. Estas señales se destinan a las etapas posteriores de adquisición y procesamiento.

Se disponen capacitores de desacople en la alimentación y un divisor resistivo en la entrada VSET, que es el control de polarización para alto IP3 (lo que mejora la linealidad de entrada). Se aplica entre 4 y 5 V para mejorar la performance de IP3, y entre 2 y 3 V para mejorar la figura de ruido. Actualmente el valor está seteado en aproximadamente 4,1V. 

\subsection{Acoplador direccional}
Basado en el puente de Wheatstone explicado en el marco teórico, permite dirigir la señal generada hacia el sensor, mientras que una parte de la señal reflejada por la carga se obtiene mediante el puerto acoplado. De esta manera, es posible acceder a ambas señales sin necesidad de interrumpir directamente el camino principal de transmisión.

El puente diseñado, como se muestra en el esquemático (\ref{sch:acop}), agrega dos transformadores de RF TC1-1-13M+ \cite{datasheet_tc1_1_13m} en cascada, que permiten medir la señal reflejada de manera desbalanceada y filtrar el ruido de modo común que provocaría usar solo uno. Las resistencias de 68 $\Omega$ logran que la impedancia vista desde el puerto de salida (J1) sea 50 $\Omega$.

En la figura \ref{fig:esqacopdir} se presentan las curvas de respuesta en frecuencia simuladas para los cuatro parámetros característicos de un acoplador direccional, en el rango de 0,1 a 3 GHz. Como se puede observar, el acoplamiento tiene una respuesta plana en toda la banda, esperable para un puente resistivo, manteniéndose constante alrededor de los 15 dB. La pérdida de inserción tiene valores razonables teniendo en cuenta que las resistencias disipan potencia, oscilando cerca de los 10,5 dB. El aislamiento tiene su máximo nivel de atenuación en la banda de interés (entre 1,8 y 2,2 GHz) pero mantiene un buen nivel en toda la banda, por encima de los 48 dB. La directividad tiene la misma forma, con un pico elevado de 37,3 dB en torno a 1,9 GHz pero manteniéndose sobre los 36,5 dB para las frecuencias de interés. Esto garantiza una muy buena separación entre las ondas incidente y reflejada, reduciendo errores sistemáticos. Es importante aclarar que las simulaciones se realizaron en el software uSimmics v 5.9 \cite{usimmics} y las resistencias utilizadas para simular fueron ideales, por lo que se espera un rendimiento un poco menor en la implementación real, sobre todo por la tolerancia de las resistencias a altas frecuencias. Los transformadores de RF se caracterizaron con datos de sus parámetros S brindados por el fabricante. 

\begin{figure}
    \centering
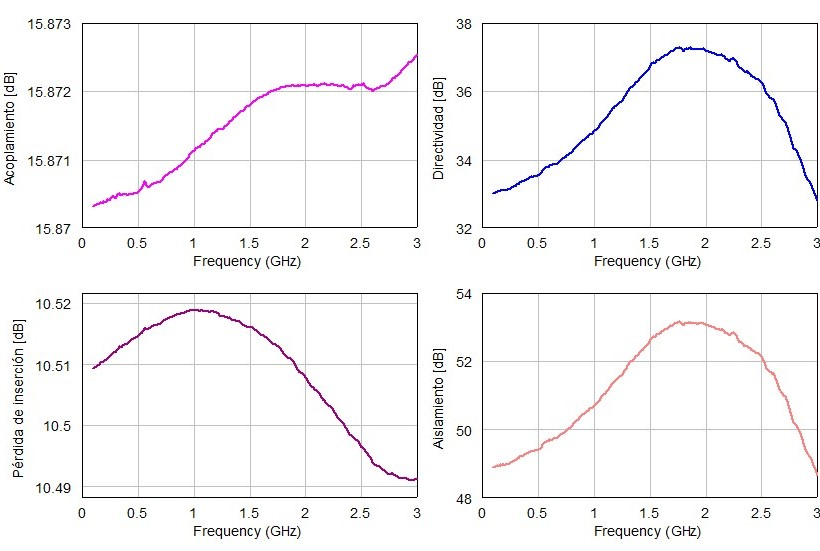
[picture p26: Tesis/Imagenes/param_acop_dir.jpeg]
    
    \caption{Parámetros simulados del puente resistivo}
    \label{fig:esqacopdir}
\end{figure}

\subsection{Amplificadores diferenciales}
Al tener salidas diferenciales y de muy poca amplitud, se debe agregar una etapa de acondicionamiento que permita obtener una señal desbalanceada y apta para ser procesada por la placa de sonido de la PC. Esta etapa utiliza amplificadores operacionales MCP6023 de Microchip Technology \cite{mcp602x_datasheet} de alimentación simple (rail-to-rail). Se configuran como restadores, permitiendo referir las señales a masa y proveer la ganancia necesaria para trabajar dentro del rango dinámico de la placa de sonido. Su esquemático se puede observar en \ref{sch:amplifi}. Aunque allí se usa una ganancia unitaria, en el ensamblado se midió la salida del mezclador y se calculó una ganancia de 8,33 veces para la señal incidente y 55,55 veces para la señal reflejada. De esta forma se aprovecha mejor el rango dinámico de la entrada de la placa de sonido, cuya entrada satura alrededor de 2 Vpp según mediciones realizadas en el laboratorio. Las resistencias utilizadas fueron de 180 $\Omega$ para R53 y R55, y 1200 $\Omega$ para R46 y R48. 

Se agregaron capacitores de bloqueo de continua, y una tensión de referencia de $V_{CC} / 2 $ obtenida mediante un divisor resistivo. De este modo, la señal alterna excursiona alrededor de ese punto de operación y puede ser amplificada sin recortes, sin necesidad de una fuente negativa.

\subsection{Alimentación y conectores}
Para alimentar la placa se dispone de una selección (a través de un jumper) de pines para utilizar una fuente de laboratorio o un USB-B para conectarlo a alguna salida de PC o cargador de 5 V. Se agrega un regulador de tensión UA78M33CDCYR \cite{datasheet_ua78m} de Texas Instruments que provee los 3,3 V necesarios para alimentar a los generadores de RF y oscilador.

Los conectores que posee son del tipo SMA para mediciones de RF, conexión con el DUT y entrada de referencia auxiliar; conector de audio analógico para llevar las señales a la placa de sonido de la PC por medio de la entrada line-in, y tiras de pines que por medio de cables puente se conectan con el Arduino para escribir los registros de los generadores de RF. Además se ubican pares de pines para medir la detección de enganche en cada ADF4351.

\subsection{Microcontrolador}
Como se explica en la sección 2.3 de la Especificación Técnica (\cite{ET}), el microcontrolador se implementa utilizando una placa Arduino Uno que se conecta por medio de cables puente con los pines de control de los ADF4351: CLK, CE, LE y DATA. Actúa como un esclavo de ejecución que recibe las órdenes de barrido desde la PC a través de una interfaz serie. Opera a una velocidad de 115200 baudios.

\subsection{Implementación en PCB}
En principio se planteó un modelo de 2 capas, que se puede observar en las figuras \ref{fig:euvnav1}.

Tiene un espesor total de 0,9 mm, con FR4 como dieléctrico de 0,73 mm de espesor y un tamaño de 10 x 9,5 cm\textsuperscript{2}. Sin embargo, el ruteo del pin $V_{TUNE}$ de los ADF4351 y la alimentación en la parte central de la placa, donde había un sector rodeado de pistas de RF, imponía el uso de varios puentes. Se implementaron con postes y cables puente, pero no es la manera óptima porque son sensibles a interferencias. Por este motivo, se decidió hacer un modelo de 4 capas, que permitiera tener un plano de masa continuo bajo las pistas de RF y poder rutear usando la capa inferior, además de tener una tercera capa para el manejo de la alimentación. A este modelo se lo llamó $\epsilon-\mu VNA \text{ v2}$, tiene un tamaño de 8,7 x 7,8 cm\textsuperscript{2} y se lo puede observar en la figura \ref{fig:euvnav2}. Incorpora además algunas modificaciones en cuanto al ruteo de pines y posición de los transformadores de RF, debido a que no coinciden los pines descriptos en la hoja de datos con el integrado real. 

\begin{figure}[H]
    \centering
    % Primera imagen (Página 1) ocupando el 48% del ancho del texto
    \begin{subfigure}[b]{0.48\textwidth}
        \centering
        
        \caption{Frente}
        \label{fig:euvnav1frente}
    \end{subfigure}
    \hfill % Esto agrega un espacio en blanco flexible entre las dos imágenes
    % Segunda imagen (Página 2) ocupando el otro 48%
    \begin{subfigure}[b]{0.48\textwidth}
        \centering
        
        \caption{Dorso}
        \label{fig:euvnav1dorso}
    \end{subfigure}
    
    \caption{$\epsilon-\mu VNA$ versión 1}
    \label{fig:euvnav1}
\end{figure}

\begin{figure}[htbp]
    \centering
    % Primera imagen (Página 1) ocupando el 48% del ancho del texto
    \begin{subfigure}[b]{0.48\textwidth}
        \centering
        
        \caption{Frente}
        \label{fig:euvnav2frente}
    \end{subfigure}
    \hfill % Esto agrega un espacio en blanco flexible entre las dos imágenes
    % Segunda imagen (Página 2) ocupando el otro 48%
    \begin{subfigure}[b]{0.48\textwidth}
        \centering
        
        \caption{Dorso}
        \label{fig:euvnav2dorso}
    \end{subfigure}
    
    \caption{$\epsilon-\mu VNA$ versión 2}
    \label{fig:euvnav2}
\end{figure}

Se pueden observar ambos modelos en 3D en la figura \ref{fig:euvna3d}. La versión 2 logró una placa más compacta, con capas adicionales que facilitan el ruteo, reducen las interferencias y mantienen la integridad de las señales, a cambio de una fabricación más compleja y por lo tanto más costosa, que reduce la cantidad de posibles proveedores porque deben ser especializados.

\begin{figure}[H]
    \centering
    % Primera imagen (Página 1) ocupando el 48% del ancho del texto
    \begin{subfigure}[b]{0.4\textwidth}
        \centering
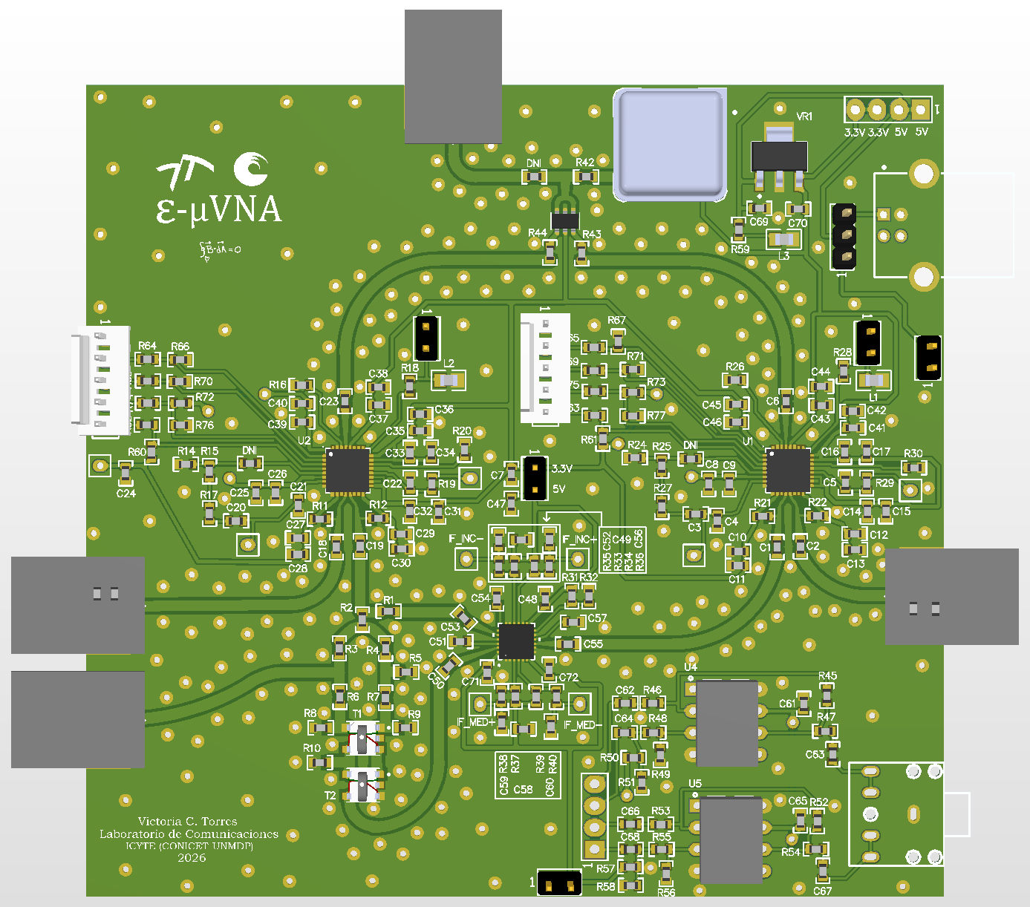
[picture p27: Tesis/Imagenes/euVNA v1 3d.png]
        
        \caption{Versión 1}
        \label{fig:euvnav13d}
    \end{subfigure}
    \hfill % Esto agrega un espacio en blanco flexible entre las dos imágenes
    % Segunda imagen (Página 2) ocupando el otro 48%
    \begin{subfigure}[b]{0.4\textwidth}
        \centering
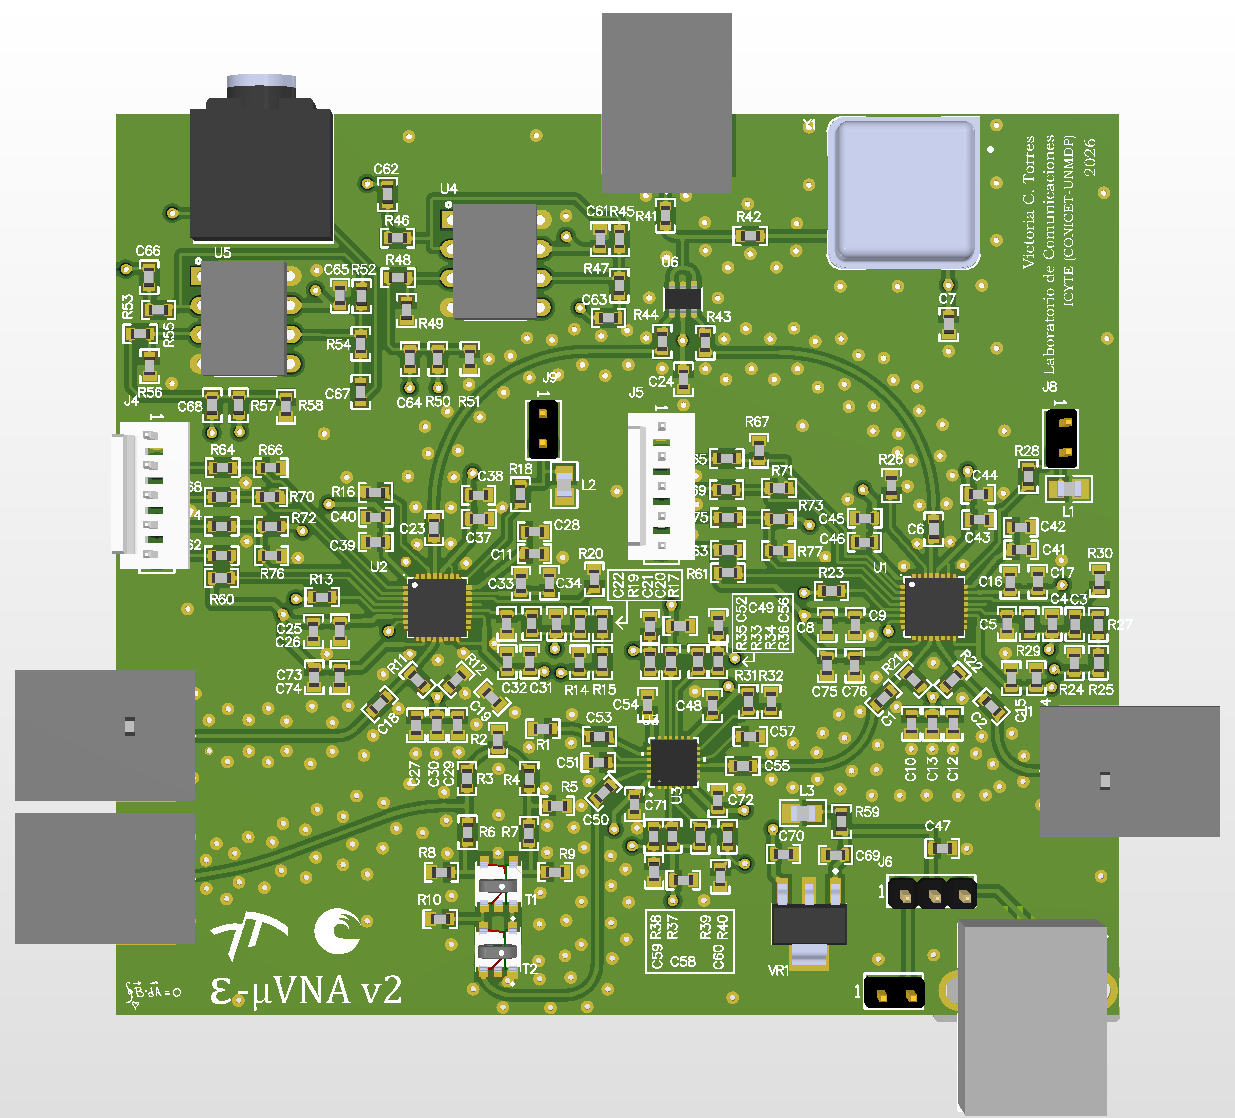
[picture p28: Tesis/Imagenes/euVNA3 3d.png]
        
        \caption{Versión 2}
        \label{fig:euvnav23d}
    \end{subfigure}
    
    \caption{$\epsilon-\mu VNA$ modelos 3D}
    \label{fig:euvna3d}
\end{figure}

\section{Firmware}
\label{sec:Firmware}
\begin{wrapfigure}[23]{R}{0.55\textwidth}
  \vspace{-2\baselineskip}
  \centering
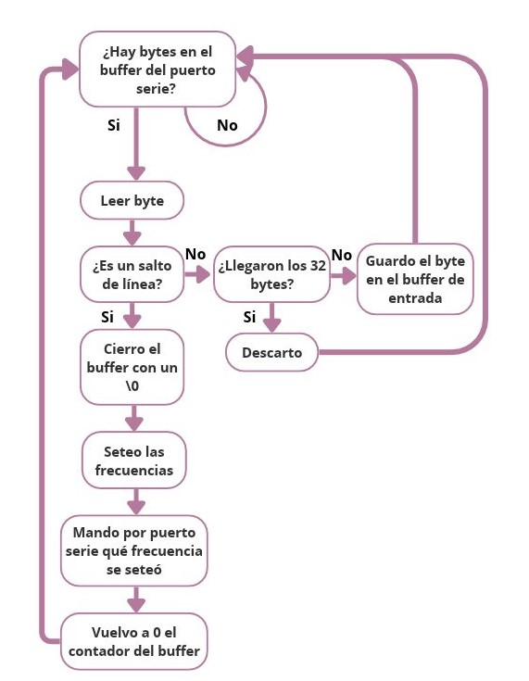
[picture p29: Tesis/Imagenes/diagflujoFW.jpg]
  
  \caption{Diagrama de flujo general del firmware.}
  \label{fig:diagflujoFW}
\end{wrapfigure}
El firmware se programó en lenguaje C++ en el entorno Arduino IDE. Está desarrollado para un microcontrolador Arduino UNO y se encarga del control, configuración dinámica y sincronización de los sintetizadores ADF4351. Un diagrama de flujo se puede ver en la figura \ref{fig:diagflujoFW}.

 Al ser inicializado en la función de arranque (\textit{setup}), configura los pines de control, inicializa el bus SPI y transmite la cadena ``Listo'' para confirmar que el sistema está disponible.

Al recibir una frecuencia $f$, el algoritmo configura el primer sintetizador (ADF1) exactamente en $f$ (canal de RF) y el segundo sintetizador (ADF2) en $f + 10\text{ kHz}$ (canal LO), introduciendo de forma automática el desplazamiento constante para la FI. Al finalizar la reconfiguración de ambos integrados, responde a la PC con la cadena ``OK''.

\subsection{Cálculo de registros}
Para cada valor de frecuencia solicitado, la función ``calcularRegistros'' determina matemáticamente el contenido de los 6 registros de 32 bits (R0 a R5) de cada chip ADF4351 según las especificaciones del fabricante:

\begin{itemize}
    \item Divisor de Salida de RF (RF Divider): Selecciona el divisor adecuado (1, 2, 4, 8 o 16) según el rango de frecuencia de trabajo (desde menos de 275 MHz hasta más de 2200 MHz) para garantizar que el VCO interno funcione en su rango de 2,2 GHz a 4,4 GHz.
    \item Frecuencia del Detector de Fase ($f_{\text{PFD}}$): A partir del oscilador de referencia externo de 10 MHz, aplica la división previa por 2 (REF\_DIV2 = true) y el contador R (R\_COUNTER = 10), fijando una frecuencia de comparación en el PFD de 500 kHz ($f_{\text{PFD}} = 0,5\text{ MHz}$).
    \item Síntesis N-Fraccionaria: Divide la frecuencia del VCO por $f_{\text{PFD}}$ para calcular la parte entera (INT) y la parte fraccionaria (FRAC) considerando un módulo fijo MOD = 1000.
    \item Configuración de Registros Internos:
    \begin{itemize}
        \item R0: Almacena los bits correspondientes a `INT` y `FRAC`.
        \item R1: Configura el \textit{prescaler} en 8/9 y fija el módulo (`MOD`) y la fase (`PHASE`).
        \item R2: Establece la polaridad positiva del detector de fase, habilita los divisores de referencia y fija la corriente de la bomba de carga (\textit{charge pump}) en 5.00 mA.
        \item R3: Habilita el modo de enganche rápido (\textit{fast lock}).
        \item R4: Selecciona el divisor de RF, habilita la salida principal, fija el reloj de selección de banda (\textit{Band Select Divider}) y configura la potencia de salida en +5 dBm.
        \item R5: Selecciona la operación del pin de enganche (\textit{Lock Detect}). El resto de los bits son un registro de control fijado según recomendación de la hoja de datos.
    \end{itemize}
\end{itemize}

\subsection{Transmisión SPI y secuencia de sincronización}
El envío de los registros hacia los integrados se realiza mediante el bus SPI de hardware y líneas de control independientes. Utiliza pines dedicados para la habilitación Latch Enable (LE) y Chip Enable (CE). Cada registro se envía dividiendo los 32 bits en 4 bytes (MSB primero) sobre la interfaz SPI, generando un pulso positivo de 2 microsegundos en la línea `LE` para almacenar los datos en el integrado. Los registros se escriben en orden inverso, desde R5 hasta R0, debido a que la transferencia del registro R0 actúa como el disparador (\textit{trigger}) que actualiza efectivamente la frecuencia del VCO. 

Para mejorar la coherencia y estabilidad de fase en el canal del Oscilador Local (ADF2), se aplica un procedimiento en dos etapas: se escriben primero los registros R5 a R1, se genera un retardo intencional de 10 milisegundos para permitir la estabilización parcial del lazo, y finalmente se escribe el registro R0 para cerrar la sintonía.

\section{Software}

Como se explica en la sección 4 de la Especificación Técnica \cite{ET} el software se programa en lenguaje Python en el entorno Visual Studio Code. Un diagrama de bloques general se puede ver en la figura \ref{fig:diagflujoSW}. Las funciones principales que cumple son:

\begin{itemize}
    \item Gestionar el barrido en frecuencia;
    \item Controlar la adquisición de audio;
    \item Ejecutar el procesamiento digital de señales en tiempo real;
    \item Implementar el modelo de calibración SOL de un puerto para obtener el coeficiente de reflexión ($\Gamma$) del DUT;
    \item Mostrar resultados.
\end{itemize}

Las configuraciones iniciales son: Puerto COM, baudrate, frecuencias de inicio, fin y paso, offset (es decir, frecuencia de audio a utilizar), frecuencia de muestreo para la adquisición, duración de la captura y su descarte inicial debido al transitorio, los nombres de los archivos de salida, la frecuencia central del filtro FIR (que debe coincidir con la frecuencia de audio), su ancho de banda, numtaps y ventana a utilizar.

La función principal (\textit{main}) genera el vector de frecuencias a partir de las frecuencias de inicio, fin y paso. Luego diseña el filtro pasabanda. Revisa el directorio en búsqueda de un archivo de calibración cuyo nombre (predefinido con las configuraciones de frecuencia) coincida con las ingresadas por el usuario. En caso afirmativo, pregunta si se desea utilizar o se prefiere realizar una nueva calibración. Dependiendo de la respuesta del usuario por terminal, entra al bucle de calibración o carga los parámetros desde el archivo. Procede a realizar la conexión con el microcontrolador. Si se debe calibrar, realiza tres barridos para obtener los valores de $\Gamma_{MED}$ y completar la matriz de calibración. En estos barridos el usuario debe ir cambiando la carga de prueba en el orden que va indicando el programa: cortocircuito, circuito abierto y carga de 50 $\Omega$. Una vez que se hacen los barridos calcula los errores y se guardan en el archivo CSV (archivo de texto plano donde los valores están separados por comas). Realiza el barrido del DUT y cierra el puerto serie. Aplica la corrección, calcula la fase en grados y el módulo en dB y se guardan en vectores separados. Crea un archivo CSV con estos datos y muestra los resultados en gráficos de módulo y fase en función de la frecuencia. 

\subsection{Flujo de barrido}

La función ``barrido'' se encarga de enviar los datos de la frecuencia a generar, recibir la señal analógica y guardar los resultados en un vector. Su diagrama de flujo se puede ver en la figura \ref{fig:diagflujobarrido}.

Los parámetros que recibe son: el objeto de conexión serial con el microcontrolador (que da acceso al buffer de transmisión y recepción); el vector de frecuencias a medir, los coeficientes del filtro FIR, un nombre para la medición (para identificar si es un barrido de calibración o de medición), y los errores de calibración si fuese necesario. Devuelve un vector de S11 complejos (formato binario).

Consiste en un bucle \textit{for} que recorre el vector de frecuencias, seteando cada una en el microcontrolador con la función ``write'' de la librería ``serial'' para luego leer su respuesta con ``readline''. Si esta comienza en ``error'' aborta el barrido. De otra forma, captura el audio usando la librería ``sounddevice''. Para eso calcula el número de muestras a adquirir como la multiplicación de la frecuencia de muestreo y la duración de la captura. Graba los dos canales, de tipo ``float64'' con la función ``rec''. Descarta la primera parte de la grabación para evitar incluir en el cálculo los transitorios, y guarda dos vectores: ``canal\_ref'' y ``canal\_med''. Por último, mide S11 y la frecuencia en la que se encontró el batido. Para ir mostrando los valores calibrados por terminal a medida que se hace el barrido, realiza la calibración por cada punto, calcula el S11 en módulo y fase y las imprime. 

\subsection{Estimación del S11}
\label{sec:estS11}

La función que realiza el cálculo del S11 tiene como parámetros de entrada los vectores de muestras, la frecuencia de muestreo y los coeficientes del filtro. Un diagrama de flujo simplificado se puede observar en la figura \ref{fig:diagflujoS11}. 

Lo primero que hace es aplicar el filtro a cada canal usando la función ``lfilter'' de scipy.signal. Luego calcula la FFT con la función ``fft.fft()'' de NumPy. Utiliza una ventana que setea el usuario, que por default es la FlatTop, y que crea la función ``get\_window'' de scipy.signal.windows. Descarta la mitad negativa del espectro de frecuencias.

Luego busca el índice del bin frecuencial de mayor amplitud (en el canal de referencia) con la función ``searchsorted'' de NumPy dentro de un rango frecuencial acotado alrededor de $f_{\text{FI}}$, en la banda de paso del filtro. La ecuación \ref{eqkpico} representa la búsqueda del índice, donde $X_{\text{ref}}[k]$ es el valor complejo del espectro en el bin discreto de frecuencia $k$, y $\arg\max$ el operador ``argumento del máximo'', que devuelve la posición o índice en el cual se alcanza la amplitud máxima.  

\begin{equation}
    k_{\text{pico}} = \arg\max_{k \in \text{Banda}} \left| X_{\text{ref}}[k] \right|
    \label{eqkpico}
\end{equation}

Después crea un número infinitesimal basado en el pico del espectro para sumárselo al denominador del cálculo del S11, por si el valor de magnitud en la referencia es cero. Por último, calcula S11 como el conjugado de la división de la medición y la reflejada, usando para cada uno el bin donde se encontró el máximo de magnitud.
\begin{equation}
    S_{11,\text{raw}} = \frac{V_{\text{med}}[k_{\text{pico}}]}{V_{\text{ref}}[k_{\text{pico}}]}
\end{equation}
Este número se almacena como un tipo complex128, un tipo de dato numérico que representa números complejos de doble precisión. Este valor no calibrado sirve como la entrada directa para el posterior algoritmo de corrección de errores vectoriales mediante el modelo de tres términos (SOL).

\begin{figure}[htbp]
  \centering
  \begin{subfigure}[t]{0.35\textwidth}
    \centering
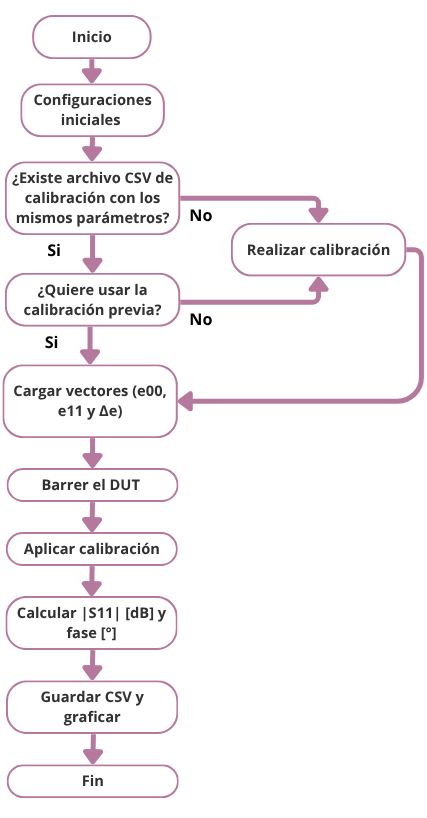
[picture p30: Tesis/Imagenes/diagflujo_SW.png]
    
    \caption{Diagrama de flujo general.}
    \label{fig:diagflujoSW}
  \end{subfigure}%
  \hfill
  \begin{subfigure}[t]{0.30\textwidth}
    \centering
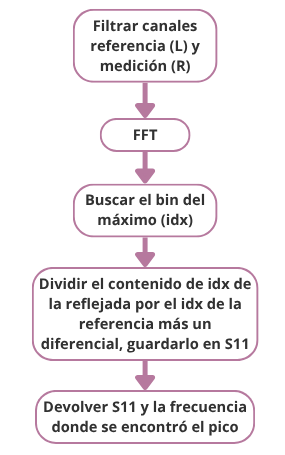
[picture p31: Tesis/Imagenes/diagflujo_SW_calculos11.png]
    
    \caption{Función que calcula $S_{11}$.}
    \label{fig:diagflujoS11}
  \end{subfigure}%
  \hfill
  \begin{subfigure}[t]{0.34\textwidth}
    \centering
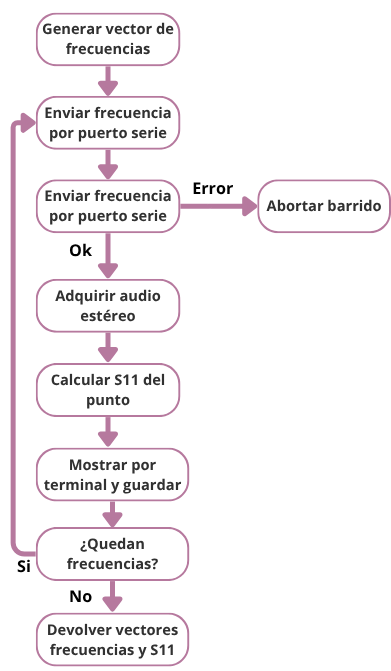
[picture p32: Tesis/Imagenes/diagflujo_SW_barrido.png]
    
    \caption{Función barrido.}
    \label{fig:diagflujobarrido}
  \end{subfigure}
  \caption{Diagramas de flujo del software.}
  \label{fig:diagflujo_software}
\end{figure}

\subsection{Calibración}
El software guía al usuario para realizar tres barridos completos utilizando las cargas del método SOL. Almacena en tres vectores (GM\_CC, GM\_CA y GM\_50) las mediciones complejas crudas del cortocircuito, circuito abierto y carga de 50 $\Omega$ respectivamente. Luego, la función ``calculo\_errores'' procesa los datos punto a punto para cada frecuencia del barrido:

\begin{itemize}
    \item Arma un sistema de ecuaciones lineales  $A \cdot x = B$ con coeficientes complejos, donde A es la matriz cuya fila 1 corresponde a short: $[1, -\text{GM\_CC}[i], 1]$; fila 2 a load: $1$;  y fila 3 a open: $[1, \text{GM\_CA}[i], -1]$. El vector B corresponde a $[\text{GM\_CC}[i], \text{GM\_50}[i], \text{GM\_CA}[i]]$.
    \item Resuelve el sistema mediante la función ``linalg.solve(A,B)'' de NumPy, que permite obtener las tres incógnitas por cada punto en frecuencia.
\end{itemize}

Los tres vectores de error se guardan en un archivo CSV, separando las partes reales e imaginarias de cada término con notación científica de 10 dígitos decimales junto con la frecuencia en MHz.

Cuando se ejecuta el barrido, el software aplica la función de corrección inversa sobre cada punto medido según la ecuación \ref{eq:correcciongamma}. Antes de hacerlo, se verifica que el denominador no sea nulo. Si la magnitud es menor a $10^{-15}$, se reemplaza por un valor insignificante ($10^{-15} + j10^{-15}$) para evitar errores de división por cero.

\section{Interfaz de usuario}
La interfaz de usuario se programó con PyQt6, mediante un prompt de la inteligencia artificial (IA) Claude, modelo Sonnet 5 Esfuerzo Medio. Se alimentó del software original, que tenía la lógica de medición funcionando, pero que corría secuencialmente y se comunicaba con el usuario a través de la consola. 

El prompt inicial consistió en pedir una recomendación de lenguaje o plataforma para hacer una interfaz de usuario sencilla pero funcional, y que no llevase mucho tiempo poner en marcha. La IA recomendó Python + PyQt6/PySide6, con matplotlib embebido para los gráficos. El motivo de esta elección fue reutilizar funciones, que permita actualizar el plot en vivo, aprovechar librerías de Python para graficar. Hizo un esqueleto de la app con ventana principal, campos de frecuencia, threading de barrido y gráficos, y se le dio el permiso. Creó dos archivos, un ``core'' que contiene la misma lógica de cálculo que el código original y un ``GUI'' (Graphical User Interface) que contiene la parte visual: ventana, botones, campos y gráficos. Este llama a las funciones implementadas en el core. Agregó la biblioteca PyQt6 para usar ventanas, botones, campos e hilos de ejecución. Creó una clase (SweepWorker(QThread)) que se encarga de correr el barrido en segundo plano y avisar a la ventana qué se midió para que actualice los gráficos y la barra de progreso sin congelarse entre cada medición. Además, generó el diagrama de flujo que se observa en la figura \ref{fig:d_flujo_interfaz}. Una imagen de la interfaz se encuentra en la figura \ref{fig:interfaz}. 

\begin{figure}
    \centering
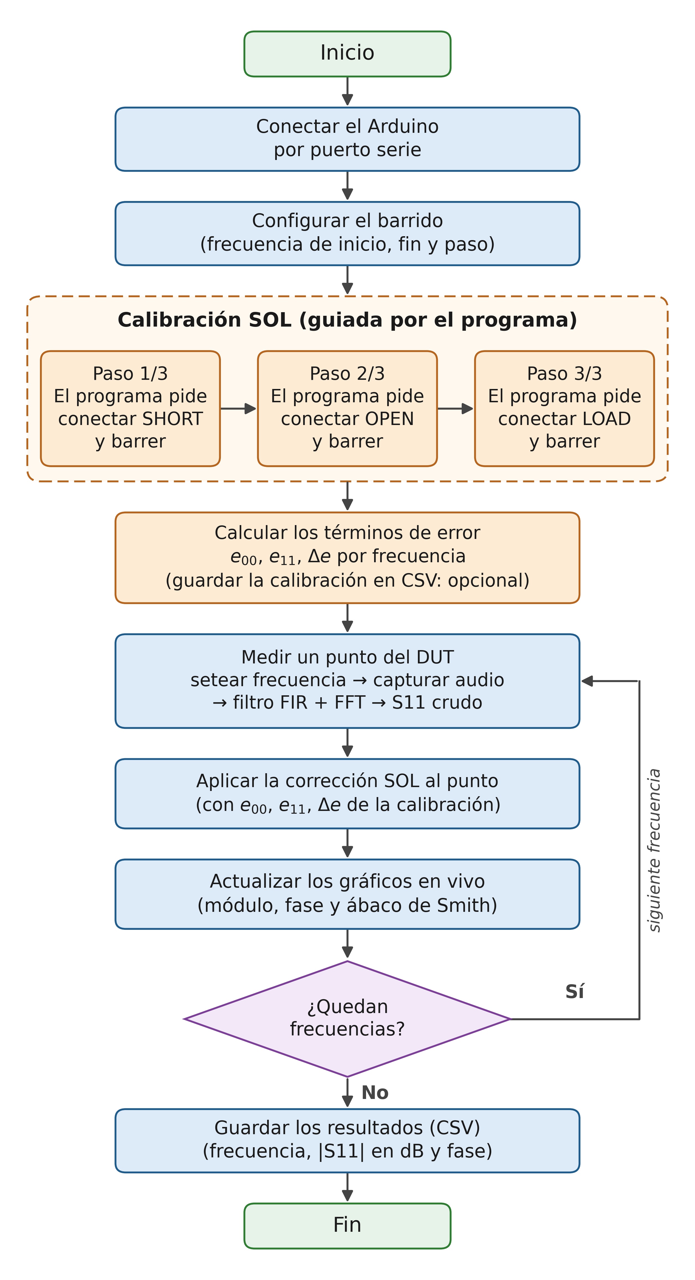
[picture p33: Tesis/Imagenes/d_flujo_interfaz.jpg]
    
    \caption{Diagrama de flujo de la interfaz de usuario}
    \label{fig:d_flujo_interfaz}
\end{figure}

\begin{figure}
    \centering
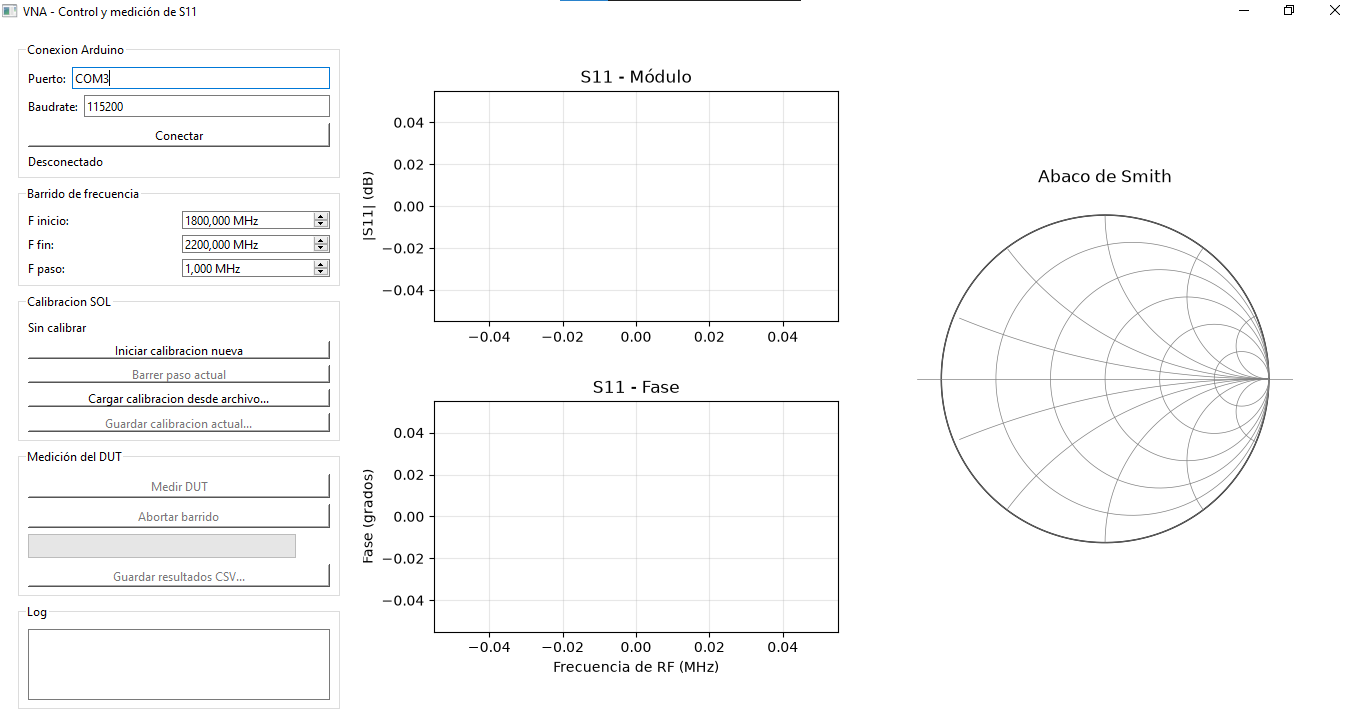
[picture p34: Tesis/Imagenes/interfaz.png]
    
    \caption{Interfaz de usuario}
    \label{fig:interfaz}
\end{figure}
