VictoriacTorres/euVNA/Tesis/Informe Final Victoria C. Torres.pdf

Universidad Nacional de Mar del Plata

# Facultad de Ingeniería

## Trabajo final

## Desarrollo de un Analizador Vectorial de Redes para medición no invasiva de glucemia

### Victoria Carla Torres


### Ingeniería Electrónica Departamento de Ingeniería Electrónica y Computación Septiembre 2026

# Agradecimientos

Con todo mi cariño, quisiera agradecer:
En primer lugar, a mi director Ramiro Avalos Ribas. Por ser mi mentor y referente, además de tutor informal y apoyo moral estos cuatro años que he tenido el placer de compartir el espacio académico. Su paciencia, consejos, calidez y forma de resolver los problemas son los valores más importantes que me llevo de la carrera.
Con mucho respeto, a mis directores de beca de investigación Alejandro José Uriz y Jorge Castiñeira Moreira. Por su constante disposición, por compartir mis alegrías y mis indignaciones, por sus palabras de apoyo y por su trabajo para darme las herramientas que facilitaron mi camino. A mi codirector Brian Maximiliano Gluzman, por compartir mi terquedad en momentos donde hubo que resolver algún problema. Por sus sugerencias certeras, por enseñarme a soldar y compartirme mates.
A Esteban Lucio González, quien me introdujo al Laboratorio y a la investigación, por confiar en mi potencial. Espero poder retribuir esa confianza dando todo de mí para ser una profesional íntegra y comprometida.
A mis compañeros del Laboratorio de Comunicaciones, que nunca escatiman en brindar su apoyo sin importar el tipo de problema con el que me acerque, académico o extraacadémico. Gracias a ellos encontré un espacio de aprendizaje y crecimiento para dar mis primeros pasos en el ámbito de la investigación, pero sobre todo, un lugar de pertenencia. Entre ellos, quiero incluir a Leonardo David Vazquez, cuyo trabajo final sentó las bases para el desarrollo de este. Su pasión fue contagiosa, y estuvo presente en este proyecto (aún estando lejos) respondiendo mis dudas, llevando seguimiento y dando aliento en todo momento.
A Gustavo Arenas, por permitirme pasar la mayor parte de mi trayectoria como estudiante siendo ayudante en la asignatura Física 2/B. La docencia es una parte muy importante de quien soy, y estoy muy agradecida de ser y haber sido parte de una de las cátedras más lindas de mi recorrido como estudiante.
A mis compañeros y docentes. Los temas pesados se hacen llevaderos cuando el ambiente de estudio es bueno. Porque tenemos la gran suerte de poder tocarles la puerta a nuestros profesores y que nos reciban para despejar cualquier duda, aunque no competa su materia.
A mis amigos, porque estoy segura de que sin ellos no es posible sobrellevar el nivel de exigencia que demanda una carrera en ingeniería. Por las largas horas de estudio, rondas de mates y truco en el comedor entre clase y clase, charlas interminables soñando con el día en que nos recibamos, validación, "amiga te juro que vos podés", apoyo en momentos de felicidad y otros de mucho estrés y dificultades, personales y académicas. Algunas de estas personas se han convertido en mi familia, y es imposible imaginar mi vida sin ellas. Me enseñaron más que cualquier libro.
A mi familia, gracias por soportar mis momentos de ansiedad y estrés, por su apoyo constante y fe ciega en mí.
Finalmente, expreso mi reconocimiento a la Universidad Nacional de Mar del Plata y en especial a la Facultad de Ingeniería. A lo largo de estos años se ha convertido en más que un espacio de formación, sino en un lugar de pertenencia del cual me enorgullezco enormemente, que me ha dado las oportunidades más lindas y enriquecedoras de mi vida. Sin instituciones públicas de calidad, muchos no podríamos hoy estudiar una carrera universitaria.

Victoria C. Torres
5/9/2026

# Índice

Agradecimientos | 1
Siglas y abreviaturas | 4
Resumen | 4
1 Introducción | 6
2 Marco teórico | 8
2.6.1.1 | Diseño de filtros FIR mediante el método del enventanado . . . . | 14
3 Proyecto | 16

4 Resultados | 29
5 Conclusiones y trabajos futuros | 42
6 Esquemáticos y código | 44
Apéndices | 84
Bibliografía | 126

# Siglas y abreviaturas

Nombre | Descripción
VNA | Analizador Vectorial de Redes
UHF | Ultra High Frequency
CGM | Continous Glucose Monitoring
CONICET | Consejo Nacional de Investigaciones Científi-cas y Técnicas
LAC | Laboratorio de Comunicaciones
ICYTE | Instituto de Investigaciones Científicas y Tec-nológicas en Electrónica
UNMDP | Universidad Nacional de Mar del Plata
FI | Frecuencia Intermedia
DUT | Device Under Test
RF | Radiofrecuencia
SOL | Short, Open, Load
PCB | Printed Circuit Board
SMD | Surface-Mount Device
USB | Universal Serial Bus
CPU | Central Processing Unit
CLK | Clock (señal de reloj)
OL | Oscilador Local
FIR | Finite Impulse Response
FFT | Fast Fourier Transform
IC | Integrated Circuits
VCO | Voltage Controlled Oscillator
PFD | Phase Frequency Detector
SMA | SubMiniature version A
SPI | Serial Peripheral Interface
CSV | Comma-Separated Values
IA | Inteligencia Artificial
GUI | Graphical User Interface
QFN | Quad Flat No-Lead
ADC | Analog-to-Digital Converter

# Resumen

El proyecto propone el diseño, implementación, calibración y ensayo de un Analizador Vectorial de Redes (VNA) de un puerto, que opere en una banda de frecuencias UHF (Ultra High Frequency) que va desde los 1,8 hasta los 2,2 GHz, adaptado para operar en conjunto con un sensor de glucemia no invasivo.
El principio de medición se basa en la existencia de una correlación entre la concentración de glucosa en sangre y sus propiedades eléctricas (permitividad relativa y conductividad) [1], por lo que es razonable suponer que las variaciones en la composición dieléctrica de una muestra de tejido biológico pueden alterar la distribución de los campos electromagnéticos presentes en un sensor de microondas.
La implementación se realiza en una placa de circuito impreso, con circuitos integrados especializados y aplicando técnicas de reflectometría, diseño en radiofrecuencia y manejo de emisiones electromagnéticas.
Se obtienen señales analógicas en la banda de audio para su adquisición en la placa de sonido de una PC. Luego, el análisis de las señales es puramente digital. Se aplica un procesamiento basado en la Transformada Rápida de Fourier (FFT) para obtener el coeficiente de reflexión del sistema bajo prueba en función de la frecuencia.

# Capítulo 1

# Introducción

### 1.1 Contexto y motivación

La diabetes es una afección crónica que se desencadena cuando el organismo pierde su capacidad de producir suficiente insulina o de utilizarla con eficacia para mantener los niveles de glucosa en la sangre dentro de los márgenes normales. La cantidad de adultos que la padecen se ha casi cuadruplicado entre 1980 y 2016, con un aumento en la prevalencia más acelerado en países de ingresos bajos y medios que en países de ingresos altos [2]. Para 2021 fue la causa directa de 1,6 millones de muertes [3]. Existen numerosos dispositivos que permiten realizar un control de la glucosa en sangre pero requieren, en general, de una punción en alguna parte del cuerpo para extraer una muestra de sangre. El mecanismo tradicional requiere depositar la muestra en una tira reactiva dentro de un medidor para obtener el valor de glucemia. Se recomienda, en promedio, que los pacientes realicen 4 mediciones al día (dependiendo de la estabilidad de los niveles o del régimen de tratamiento). Dado que la extracción suele ser dolorosa, además de que tiene un costo asociado al gasto de cada tira reactiva, la mayoría de los pacientes no logran tener un buen monitoreo de su glucemia. Por este motivo se ha incursionado en la glucometría semi-invasiva como los sistemas CGM (Continuous Glucose Monitoring) [4] que obtienen mediciones del líquido intersticial y requieren la colocación de un sensor debajo de la piel que se debe reemplazar periódicamente, por lo que siguen siendo invasivos, incómodos de usar y descartables. El estudio de propuestas para la medición no invasiva ha avanzado en los últimos años, pero aún no existe una técnica ampliamente adoptada ni dispositivos comerciales fiables. Se ha observado que existe una correlación entre la concentración de glucosa en sangre y sus propiedades eléctricas (permitividad relativa y conductividad) [1], por lo que es razonable suponer que las variaciones en la composición dieléctrica de una muestra de tejido biológico pueden alterar la distribución de los campos electromagnéticos presentes en un sensor de microondas.
Por esta razón el Laboratorio de Comunicaciones (LAC), perteneciente al Instituto de Investigaciones Científicas y Tecnológicas en Electrónica (ICYTE), que depende de la Universidad Nacional de Mar del Plata (UNMDP) y del Consejo Nacional de Investigaciones Científicas y Técnicas (CONICET) tiene una línea de investigación cuyo objetivo es diseñar e implementar un prototipo que permita realizar una medición de glucemia, basado en un VNA y un sensor de microondas.
Un Analizador Vectorial de Redes es un instrumento de medición que permite caracterizar sistemas en alta frecuencia. La forma en que lo hace es haciendo incidir una señal de microondas en los puertos del sistema, y midiendo las señales que salen del resto de los puertos.
El Laboratorio busca optimizar, compactar y mejorar el rendimiento del VNA actual, por lo que requiere el diseño y desarrollo de un VNA de un puerto que esté adaptado a un sensor de microondas que resuena alrededor de los 2 GHz.

### 1.2 Partes interesadas

El Grupo de Investigación del LAC es quien solicita el desarrollo. Por esta razón, el equipo se utilizará bajo su supervisión, y sus posibles usuarios son:

- Ingenieros, técnicos y/o radioaficionados;
- Estudiantes de ingeniería.

### 1.3 Objetivos

El objetivo principal del proyecto es el diseño, desarrollo, calibración y ensayo de un VNA de bajo costo y tamaño compacto, que opere en la banda de frecuencias de UHF que abarca desde 1,8 a 2,2 GHz, orientado a la medición no invasiva de glucemia.

Los objetivos particulares son:

- Implementar en una placa de circuito impreso el VNA;
- Generar un barrido en la banda de frecuencias de interés;
- Implementar un sistema heterodino que permita trabajar con señales de frecuencia intermedia (FI) en la banda de audio;
- Digitalizar las señales obtenidas para aplicar un tratamiento digital que permita calcular el coeficiente de reflexión del sistema bajo prueba (DUT - Device Under Test);
- Implementar una rutina de calibración para eliminar errores sistemáticos del sistema;

### 1.4 Organización del informe

El informe se organiza de la siguiente manera: en el capítulo primero se introduce el proyecto y se brinda un punteo de los objetivos más importantes. El capítulo 2 se centra en el marco teórico, donde se explican las bases para entender el funcionamiento del dispositivo. El capítulo 3 describe el proyecto con su implementación. En el capítulo 4 se muestran los resultados y mediciones. El capítulo 5 se dedica a conclusiones y trabajos futuros, y el 6 exhibe los esquemáticos y códigos utilizados. Por último se anexan los apéndices en donde se encuentran: el estudio preliminar, el plan de trabajo, las especificaciones de requerimientos, funcional y técnica y el plan de pruebas.

# Capítulo 2

# Marco teórico

### 2.1 Analizador Vectorial de Redes

El Analizador Vectorial de Redes fue definido en sus inicios como un instrumento que permite medir los parámetros de redes eléctricas [5]. En su esquema más básico posee una fuente de radiofrecuencias (RF), que genera una señal de estímulo para el dispositivo bajo prueba, y un banco de receptores que miden las señales que salen del DUT y las comparan con la onda incidente. Los resultados se procesan y muestran al usuario por medio de alguna interfaz. Dependiendo de los dispositivos que se buscan caracterizar, se determina la cantidad de puertos que debe tener el VNA. Un puerto permite medir el parámetro de reflexión. Con dos puertos, se puede medir además el de transmisión. Si posee un solo canal, se puede medir la transmisión inversa y la reflexión en la salida invirtiendo físicamente el dispositivo bajo prueba. Este paso se puede evitar agregando un canal, lo que incrementa el costo del VNA.

### 2.2 Parámetros de dispersión (S)

Los parámetros de dispersión, también llamados S por su nombre en inglés (Scattering) permiten caracterizar redes de dos o más puertos en función de sus ondas entrantes y salientes. Se especifican para una impedancia de referencia y a una frecuencia específica, y son útiles en altas frecuencias porque otros tipos de parámetros (como los Z o los Y) no pueden ser medidos directamente.


Figura 2.1: Parámetros S en una red de dos puertos

Según las ondas incidentes a1 y a2 y las reflejadas b1 y b2, los parámetros S se definen como:

S11 =

b1
a1

⃓
⃓
⃓
a2=0

; S12 =

b1
a2

⃓
⃓
⃓
a1=0

; S21 =

b2
a1

⃓
⃓
⃓
a2=0

; S22 =

b2
a2

⃓
⃓
⃓
a1=0

Para lograr que las a sean iguales a 0, el puerto al que pertenecen debe estar adaptado, garantizando que no haya ninguna señal incidente.

### 2.2.1 Parámetro S11

El parámetro S11 se conoce como el coeficiente de reflexión. Se puede definir en función de las ondas incidente y reflejada, o en función de la impedancia característica del sistema Z0 y la impedancia de carga (es decir, del sistema bajo prueba):

S11(DUT) = Γ = ZL − Z0
ZL + Z0

(2.2.1)

Expresado en dB, se expresa:

S11(DUT)[dB] = 20.log(|Γ|) | (2.2.2)

### 2.2.2 Calibración S11

### 2.2.2.1 Errores

Los errores que pueden aparecer en una medición se pueden dividir en dos grandes clases: los errores sistemáticos y los aleatorios. Los primeros se pueden corregir, mientras que los segundos se encuentran en toda medición y están fuera del control del usuario.
En el caso de dispositivos electrónicos algunos errores sistemáticos son los producidos por variaciones en la potencia de salida de los generadores, pérdidas de inserción en materiales conductores y conectores, desfasajes ocasionados por diferencias en longitudes eléctricas o retardos en los circuitos integrados, reflexiones generadas por desadaptación de impedancias y deriva térmica. Algunos errores aleatorios pueden ser ruido térmico, de cuantización e interferencia electromagnética.
La calibración en un VNA permite corregir los errores sistemáticos, excluyendo: comportamientos alineales; repetibilidad en conectores; errores en las cargas de calibración; y deriva térmica. Este último se puede corregir solo si la calibración se realiza inmediatamente antes de la medición.

### 2.2.2.2 Método SOL

En VNAs de un puerto se pueden simplificar los errores a un modelo de tres términos que describen la directividad, adaptación del puerto y errores de seguimiento (variaciones de amplitud y fase en función de la frecuencia)[6]. Usando tres cargas distintas de valores conocidos, se puede formar un sistema de tres ecuaciones con tres incógnitas y resolver para obtener los términos del error:

e00 + Γ1ΓM1e11 − Γ1∆e = ΓM1 | (2.2.3a)
e00 + Γ2ΓM2e11 − Γ2∆e = ΓM2 | (2.2.3b)
e00 + Γ3ΓM3e11 − Γ3∆e = ΓM3 | (2.2.3c)

Donde ΓM es el parámetro de reflexión medido para cada carga, e00 es la directividad, e11 la adaptación del puerto, e10e01 el error de seguimiento (tracking) y ∆e = e00e11 − (e10e01). Los términos del error se pueden observar en la figura 2.2.


Figura 2.2: Términos de error para un VNA de un puerto

Si las cargas independientes son un circuito abierto, cortocircuito y carga de 50Ω entonces el método de calibración se denomina SOL (Short, Open, Load) y las ecuaciones (2.2.3) se simplifican a:

e00 − ΓMSe11 + ∆e = ΓMS | (2.2.4a)
e00 + ΓMOe11 − ∆e = ΓMO | (2.2.4b)
e00 = ΓML | (2.2.4c)

Luego el Γ real se calcula como:

Γ = ΓM − e00 ΓMe11 − ∆e | (2.2.5)

### 2.3 Acoplador Direccional

En la mayoría de diseños en electrónica, el acoplamiento electromagnético entre líneas de transmisión se considera indeseable porque interfiere con la señal que se busca transmitir. Una excepción es el caso de acopladores, donde el acoplamiento es un parámetro de diseño que permite medir la señal de una línea con un alto aislamiento, es decir, sin interrumpir su paso. Además se pueden diseñar un par de líneas acopladas que verifiquen que en uno de sus puertos la señal incidente se anula, generando un punto que permite medir la onda reflejada.
Las principales propiedades que caracterizan un acoplador son la directividad, el aislamiento, el acoplamiento y la pérdida de inserción [7]. La directividad mide la capacidad de separar las ondas que se propagan en distintas direcciones. El aislamiento, la potencia que llega al puerto desacoplado. El acoplamiento indica la proporción de potencia que se entrega al puerto acoplado. La pérdida de inserción muestra cuánta potencia (que se debería transmitir) se pierde por ser entregada a los puertos acoplados y aislados, y las pérdidas en los materiales (dieléctrico y resistividad de las pistas).
Un acoplador ideal es un dispositivo pasivo, que posee directividad y aislamiento infinitos. Existen acopladores direccionales como el HP 778d [8] que posee una directividad mayor a 36dB y pérdidas por inserción menores a 0,6dB, pero tiene un ancho de banda que permite hacer mediciones entre 100 MHz y 2 GHz, y sus dimensiones físicas y peso hacen que su utilidad se limite a mediciones en laboratorio. Para soluciones integradas hay alternativas comerciales como el ZABDC20-322 de Minicircuits [9] pero su costo hace que el diseño no sea escalable.

### 2.3.1 Puente resistivo

Una solución compacta, económica y con un ancho de banda teórico infinito es el puente resistivo tipo Wheatstone. Como se puede observar en la figura 2.3 es una red simple de comparación de impedancias, formada por cuatro resistencias sobre las cuales se inyecta una señal de referencia en la parte superior. Una de las resistencias es variable (Zx), mientras que el resto son iguales entre sí. Se utiliza un voltímetro para medir la diferencia de potencial entre las ramas. Si la resistencia variable es de 50Ω, el puente queda balanceado y el voltímetro indica un cero. Si es menor a 50Ω, la rama izquierda presenta un voltaje menor a la derecha, mientras que para valores mayores ocurre lo opuesto. La tensión en el nodo de referencia VA resulta:

VA = Vinc ·

Z0
Z0 + Z0

=

Vinc
2

(2.3.1)

Mientras que la tensión en el nodo de medición VB es:

VB = Vinc ·

Zx
Z0 + Zx

(2.3.2)

Por lo tanto, la señal desbalanceada o tensión diferencial reflejada vdif f (t) entre ambos nodos se define como:

vdif f (t) = vB(t) − vA(t)vdif f (t) = vinc(t)

[︃
Zx
Z0 + Zx

−

1
2

]︃
(2.3.3a)

Reescribiendo la resta interna con común denominador Zx
Zx+Z0

−

1
2 =

1/2[︂
Zx−Z0
Zx+Z0

]︂
entonces:

vdif f (t) = vinc(t)
2

[︃
Zx − Z0
Zx + Z0

]︃

⏞ | ⏟⏟ | ⏞
Coeficiente de reflexión (Γ)

=

vinc(t)
2
- Γ | (2.3.4)

Si la señal incidente es sinusoidal es posible además caracterizar cargas reactivas midiendo el desfasaje de la señal Zx respecto de la incidente. Este es el principio que permite al puente comportarse como un acoplador direccional: la diferencia de potencial entre las ramas es función de la onda reflejada equivalente.

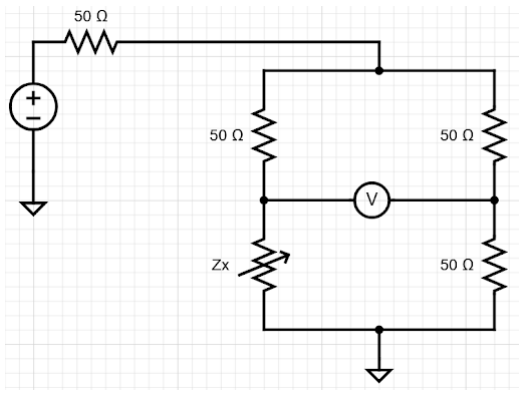
[picture p87: figure]

Figura 2.3: Esquema básico de un puente de Wheatstone

Para una aplicación de reflectometría, la magnitud de la impedancia de entrada al DUT haría las veces del Zx a caracterizar en este esquema simplificado. Esto, además de la capacidad de lograr directividad y ancho de banda elevados, lo vuelve una alternativa muy conveniente a la hora de implementar un VNA que funcione con buena sensibilidad en un rango amplio de frecuencias.

### 2.4 Buenas prácticas de diseño en RF

Al momento de rutear un PCB (Printed Circuit Board - Placa de Circuito Impreso) se deben tener en consideración algunas buenas prácticas que ayudan a mantener la integridad de las señales, la impedancia de las líneas y evitar la interferencia electromagnética, sobre todo cuando se trabaja en RF.
Se debe garantizar que las pistas cumplan con la impedancia requerida de 50Ω. Esto implica calcular el ancho de la línea usando las ecuaciones de diseño según el tipo de línea y las características de los materiales a utilizar (generalmente brindadas por el fabricante de PCB). Se pueden encontrar calculadoras online o integradas en los software de diseño con este fin. Se deben evitar ángulos rectos, que causan discontinuidades y aumentan la capacitancia parásita. El plano de masa que se encuentra debajo de las pistas de RF debe ser continuo, para que la corriente de retorno pueda seguir el camino de menor inductancia. Por esta razón no se recomienda rutear en el plano inferior al de las rutas de RF, pero si se necesita hacerlo no se deben atravesar las regiones donde en la capa superior haya trazos de RF.
Se deben usar las técnicas vía stitching y vía shielding. La segunda se usa para reducir la interferencia electromagnética y el crosstalk [10], mientras que la primera "ata" los planos de masa de distintas capas, ayudando a mantener baja impedancia y caminos de retorno cortos. Además evita resonancias dentro de la placa.
Los capacitores de desacople se deben ubicar lo más cerca posible de los integrados, de forma de poder suministrar rápidamente los picos de corriente que demandan los integrados que la fuente de alimentación no puede entregar [11]. También deben utilizarse cuando se suministra alimentación a un trazo a través de vías.
Los trazos deben ser lo más cortos posible, para minimizar la atenuación de las señales y reflexiones indeseadas.

### 2.5 Heterodinación de señales

Las señales que se intentan medir en un VNA son de naturaleza analógica, por lo que para realizar el cálculo del parámetro de reflexión o S11 primero se debe poder medir su amplitud y fase. Existen integrados que pueden obtener la magnitud de una onda de RF como el HMC601
[12] pero se pierde información de la fase. Por eso se busca una forma de bajar la frecuencia de la señal para poder adquirirla de forma digital.
Un esquema heterodino se basa en la combinación de una señal de RF de interés con otra señal generada localmente por un oscilador local (OL o LO por sus siglas en inglés) desplazada en frecuencia un valor constante, llamado frecuencia intermedia (FI).
Cuando se multiplican idealmente en el dominio del tiempo dos señales sinusoidales vRF (t) = ARF cos(2πfRF t) y vOL(t) = ALO cos(2π(fRF + fIF )t) (suponiendo que tienen la misma fase inicial), a la salida existen componentes espectrales en la suma y diferencia de las frecuencias originales:
vmix(t) = k · vRF (t) · vLO(t) | (2.5.1a)
vmix(t) = kARF ALO cos(2πfRF t) cos(2π(fRF + fIF )t) | (2.5.1b)
| (2.5.1c)

Reescribiendo con la identidad trigonométrica cos(α) cos(β) = 1
2

[cos(α − β) + cos(α + β)]
entonces:

vmix(t) = kARF ALO
2

⎡

⎢

⎣ cos (2πfF I t)
⏞ | ⏟⏟ | ⏞
Componente Resta (FI)
+ | cos (2π(2fRF + fF I )t)
⏞ | ⏟⏟ | ⏞
Componente Suma (Alta Frecuencia)

⎤

⎥

⎦ | (2.5.2a)

Mediante un filtrado se puede aislar la componente diferencia, logrando así trasladar la información de la señal de RF hacia la FI:

vIF(t) = kARFALO
2
cos (2πfIFt) | (2.5.3)

Utilizando un mezclador doble se pueden heterodinar dos señales con un solo oscilador local, como muestra la figura 2.4 . De esta forma obtienen las señales incidente y reflejada, conservando su amplitud y fase, en una frecuencia de audio que facilite su adquisición y procesamiento.


Figura 2.4: Heterodinación de señales

### 2.6 Procesamiento digital de señales

Para poder aplicar un procesamiento digital cualquier señal analógica continua en el tiempo debe ser muestreada, es decir convertirla en una secuencia de números de precisión finita. El proceso implica una pérdida de información de los intervalos intermedios, pero según el teorema de Nyquist-Shannon una señal de banda limitada puede reconstruirse inequívocamente a partir de sus muestras si la frecuencia de muestreo fs cumple la condición fs ≥ 2fmax, donde fmax representa la componente frecuencial de mayor valor de la señal [13].
Una vez que la señal está digitalizada, para poder extraer su amplitud y fase, sabiendo que se encuentra a una frecuencia de valor FI, se debe aplicar un filtrado digital y realizar la Transformada Rápida de Fourier (FFT - Fast Fourier Transform)

### 2.6.1 Filtros digitales

El objetivo principal de la etapa de filtrado es aislar la señal de FI eliminando el ruido de banda ancha, las interferencias de baja frecuencia y armónicos de orden superior.
La señal muestreada x[n] pasa por un filtro pasabanda digital caracterizado por una respuesta al impulso h[n]. La operación se define mediante la convolución discreta:

y[n] = x[n] ∗ h[n] = ∑︂

M

k=0

h[k] x[n − k] | (2.6.1)

donde M representa el orden del filtro. Los coeficientes h[k] se diseñan para configurar una banda de paso en torno a la frecuencia de FI.
Los filtros digitales se pueden clasificar en dos grandes familias según la naturaleza de su respuesta al impulso: filtros de respuesta finita (Finite Impulse Response, FIR) y filtros de respuesta infinita (Infinite Impulse Response, IIR).

Un filtro IIR se caracteriza por una respuesta al impulso de duración infinita, que se logra mediante una estructura recursiva con realimentación de las salidas anteriores. Su ecuación en diferencias se expresa como:

y[n] = ∑︂

M

k=0

bk x[n − k] +∑︂

N

k=1

ak y[n − k] | (2.6.2)

La presencia de los coeficientes ak introduce polos en el plano z fuera del origen. Si bien permiten lograr bandas de transición abruptas con órdenes bajos, presentan dos desventajas fundamentales: no garantizan fase lineal en toda la banda de paso y pueden ser inestables si sus polos migran fuera del círculo unitario debido a cuantización de precisión finita.
Por otro lado, un filtro FIR presenta una respuesta al impulso de duración finita Ntaps (comúnmente denominada número de coeficientes o taps), siendo h[n] = 0 para n < 0 y n ≥ Ntaps. Su ecuación en diferencias es puramente no recursiva:

y[n] = ∑︂

M

k=0

bk x[n − k] =

Ntaps

∑︂⁻¹

k=0

h[k] x[n − k] | (2.6.3)

donde M = Ntaps − 1 representa el orden del filtro. Su transferencia H(z) es causal, estable y realizable. Todos sus polos se ubican de manera trivial en el origen (z = 0), lo que garantiza estabilidad incondicional.
Si la secuencia de coeficientes h[n] cumple la condición de simetría par alrededor de su centro (h[n] = h[Ntaps − 1 − n]), la respuesta en frecuencia presenta la forma:

H(e

jω) = |H(e

jω)| e

−jωτg
(2.6.4)

donde el retardo de grupo τg es estrictamente constante para todas las frecuencias:

τg =

Ntaps − 1
2
[muestras] | (2.6.5)

Un retardo de grupo constante asegura que el filtro no introduce distorsión de fase no lineal, preservando la diferencia de fase relativa entre el canal de referencia (Vref) y el de medición

(Vmed).

### 2.6.1.1 Diseño de filtros FIR mediante el método del enventanado

La forma más simple de diseño de filtros FIR es el llamado método del enventanado (window design method) [14]. Este método consiste en truncar y desplazar la respuesta al impulso ideal de duración infinita, hd[n] (correspondiente a un filtro pasabanda ideal centrado en fFI), multiplicándola punto a punto por una función ventana finita w[n] de longitud Ntaps:

h[n] = hd[n] · w[n], | 0 ≤ n ≤ Ntaps − 1 | (2.6.6)

Una de las posibles ventanas a utilizar es la Hamming, definida como:

w[n] = 0,54 − 0,46 cos (︃
2πn

Ntaps − 1

)︃
, | 0 ≤ n ≤ Ntaps − 1 | (2.6.7)

La multiplicación en el dominio del tiempo equivale a la convolución periódica de la respuesta en frecuencia ideal con el espectro de la ventana, W(e

jω). La ventana de Hamming tiene como características principales:

- Atenuación en banda de rechazo: Proporciona un nivel de lóbulo secundario pico de aproximadamente −41 dB y una atenuación mínima en la banda de rechazo de −53 dB.
- Suavizado del fenómeno de Gibbs: Elimina las oscilaciones de sobrepico en los bordes de la banda de paso típicas del truncamiento rectangular estricto, a cambio de un lóbulo central más ancho.

### 2.6.2 Transformada Rápida de Fourier

Para determinar la amplitud y fase de las señales de FI, las secuencias filtradas en el dominio del tiempo se transforman al dominio de la frecuencia mediante la Transformada Discreta de Fourier (DFT), calculada a través del algoritmo de la Transformada Rápida de Fourier (FFT). Para una secuencia de N muestras, la expresión de análisis viene dada por [13]:

X[k] =

N

∑︂⁻¹

n=0

x[n] w[n] e

−j

2π
N
kn, | k = 0, 1, . . . , N − 1 | (2.6.8)

donde w[n] representa la función de la ventana aplicada a la secuencia temporal.
Dado que la captura se realiza sobre una ventana de observación finita, si la duración del intervalo de adquisición no contiene un número entero exacto de ciclos de la señal, se produce el fenómeno de fuga espectral (spectral leakage). Este fenómeno dispersa la energía de la frecuencia fundamental hacia los bins frecuenciales adyacentes, degradando la precisión en la estimación de amplitud y fase. Para mitigar este efecto, se aplica una función de enventanado w[n]. La ventana Flattop se caracteriza por presentar un lóbulo principal ancho y plano; esta propiedad minimiza el error de estimación de amplitud, mejorando la exactitud en la medición de niveles de tensión.

# Capítulo 3

# Proyecto

### 3.1 Descripción general del producto

Como describe la sección 2 de la Especificación de Requerimientos (C) el sistema debe generar un barrido de frecuencias en el rango de 1,8 a 2,2 GHz. La señal se debe inyectar en el DUT y se debe medir la onda reflejada. Ambas ondas (incidente y reflejada) deben bajarse a una frecuencia intermedia para luego adquirirlas y digitalizarlas con el fin de realizar el procesamiento correspondiente. Un diagrama en bloques detallado del sistema se puede observar en la figura 3.1. Los datos a asumir, requerimientos y pautas de diseño se pueden encontrar en la Especificación de Requerimientos (C).


Figura 3.1: Diagrama en bloques del sistema

A continuación, se detalla la solución del hardware, software, firmware e interfaz de usuario.

### 3.2 Hardware

El hardware se diseñó en su totalidad en el software Altium Designer, con una licencia estudiantil gracias al programa Altium Student Lab [15]. Se creó una librería con los esquemáticos, footprints y modelos 3D de los componentes a utilizar. Se dividió el proyecto en esquemáticos que representan los distintos bloques funcionales, que se pueden observar en el capítulo “Esquemáticos y códigos” (6.1). Se puede encontrar una descripción general de cada bloque en la Especificación Técnica (E).

### 3.2.1 Generadores de RF

Como explica la sección 2.1.2 de la Especificación Técnica (E) los generadores de RF se sintetizan con los circuitos integrados (IC - Integrated Circuits) ADF4351. Este es un sintetizador de banda ancha con VCO integrado, con frecuencia de salida configurable de 40 a 4400 MHz y potencia de salida máxima de 5dBm [16]. El hardware posee dos; uno incide directamente en el acoplador direccional, desviando una parte de su potencia hacia el mezclador para medir la señal incidente. El esquemático de su implementación se puede ver en 6.1.1. El otro se utiliza como oscilador local para el esquema heterodino (esquemático en 6.1.2). Es relevante mencionar que las salidas de RF no es una sinusoidal pura perfecta, sino que incluye componentes armónicos generados por el VCO y la etapa de salida. La hoja de datos aclara que el segundo armónico se encuentra entre -19 y -20 dBc por debajo de la potencia de la fundamental, mientras que el tercer armónico se encuentra entre -10 dBc y -13 dBc por debajo.
El diagrama en bloques del chip se puede observar en la figura 3.2:


Figura 3.2: Diagrama en bloques del integrado ADF4351

Algunas consideraciones que se tuvieron en cuenta al momento de diseñar y rutear fueron:

- Tensión de alimentación (Vcc) de 3,3 V, ya que soporta de 3 a 3,6 V. Esta tensión debe ir a pines que se encuentran distribuidos en todos los lados del integrado, por lo que al estar ingresando con señales de RF se debe tener especial cuidado en el ruteo para mantener la integridad de las señales.
- El pad central expuesto del IC debe ser soldado a un pad GND (tierra) de al menos su mismo tamaño por razones térmicas, por indicación del datasheet [16]. Además, se sugiere colocar vías para mejorar el comportamiento térmico.

- La salida de RF es de colector abierto, por lo que para funcionar necesita una etapa de pull-up: la forma más sencilla (y de banda ancha) de hacerlo es con una resistencia de 50 Ω a VV CO. De esta forma la salida del circuito es una potencia que equivale al valor registrado en el registro 4 (R4) (ver sección firmware 3.3). Por la misma razón, por usarse en modo desbalanceado, la salida de la rama que se deja sin usar debe terminarse en una resistencia de 50 Ω. En este caso, se coloca una línea de transmisión hacia un conector SMA para mediciones auxiliares que en caso de no utilizarse, debe adaptarse. Se incluyó en el diseño un pad opcional para soldar una resistencia de 50 Ω una vez que no se necesiten los conectores.
- Es importante que la señal VT UNE, una continua que es la entrada de control del VCO, esté libre de ruido, ya que determina la frecuencia de salida y es vital para el correcto enganche.
- La hoja de datos recomienda poner capacitores de desacople lo más cerca posible de los pines VP , AVDD, VV CO, T EMP, VCOM , VREF , DVDD, y SDVDD.
- Los pines que se utilizan para programar el integrado son una entrada de alta impedancia CMOS, con un límite máximo de 3,6 V. Para protegerlas por incompatibilidad de niveles lógicos, se utilizan atenuadores en cada una de las entradas (CLK, CE, LE, DATA) (6.1.7).
- Se coloca un LED en la salida de detección de enganche, para visualizar rápidamente si el integrado está enganchado.

### 3.2.1.1 Filtro externo de lazo de control

El filtro de lazo se diseña en la aplicación del fabricante, Analog Devices, ADISIMPLL 5.9 [17]. Se busca que cumpla con un margen de fase mínimo de 45° para preservar la estabilidad del sistema, y que el ancho de banda sea lo mayor posible para disminuir el tiempo de enganche, a costa de un incremento en el ruido que ingresa al lazo que proviene de la referencia, del detector de fase y la bomba de carga.
El esquema final se puede observar en el entorno del software en la figura 3.3.


Figura 3.3: Diseño del filtro de lazo externo

La respuesta en frecuencia del sistema ADF4351 + filtro diseñado, simulada para 2 GHz, se muestra en la figura 3.4


Figura 3.4: Respuesta en frecuencia de los generadores

### 3.2.2 Oscilador

La referencia para los generadores de RF se compone de un oscilador a cristal ECS-2200BX-100 [18] que proporciona una salida cuadrada y un buffer con salida open drain 74LVC2G07W6-7 [19]. Este permite no solo aumentar el fan-out (dividiendo la señal en dos caminos sin degradarla) sino realizar un reacondicionamiento. De esta manera se reduce el crosstalk (aislando las entradas de los generadores entre sí) y el ringing (oscilaciones de reflexión), garantizando flancos más limpios y rápidos. Se colocan dos resistencias de 47 Ω para absorber las ondas reflejadas que existan en la línea debido a que la entrada de referencia de los ADF es de alta impedancia y limitar la corriente de conmutación (ayudando a reducir el ruido de alta frecuencia). El esquemático se encuentra en la sección 6.1.4.

### 3.2.3 Mezclador

El multiplicador se implementa con un IC ADL5802, un mezclador activo de alta linealidad, de dos canales, doble balanceado, con buffers de OL integrados para proveer conversión de frecuencia con alto rango dinámico. Su esquemático se puede observar en la sección 6.1.3.
Su función principal es realizar la heterodinación de las señales de radiofrecuencia. Se aplica la señal proveniente del DUT a la entrada de RF, y la del ADF4351 que actúa de OL a la entrada correspondiente.
El integrado se alimenta con una tensión continua de 5 V. Sus salidas en FI son de colector abierto con una impedancia diferencial de 200 Ω, por lo que se colocan resistencias de pull-up de 50 Ω conectadas a la línea de 5 V para su correcta polarización.
Las salidas diferenciales del integrado permiten obtener las componentes correspondientes a las señales incidente y reflejada, identificadas como IF_INC+, IF_INC−, IF_MED+ e IF_MED− en el esquemático 6.1.3. A la salida de cada canal se integran filtros pasabajo RC, calculados para atenuar la componente suma de alta frecuencia (2fRF + fFI) y dejar pasar únicamente las señales diferenciales de baja frecuencia correspondientes a la FI. Estas señales se destinan a las etapas posteriores de adquisición y procesamiento.
Se disponen capacitores de desacople en la alimentación y un divisor resistivo en la entrada VSET, que es el control de polarización para alto IP3 (lo que mejora la linealidad de entrada). Se aplica entre 4 y 5 V para mejorar la performance de IP3, y entre 2 y 3 V para mejorar la figura de ruido. Actualmente el valor está seteado en aproximadamente 4,1V.

### 3.2.4 Acoplador direccional

Basado en el puente de Wheatstone explicado en el marco teórico, permite dirigir la señal generada hacia el sensor, mientras que una parte de la señal reflejada por la carga se obtiene mediante el puerto acoplado. De esta manera, es posible acceder a ambas señales sin necesidad de interrumpir directamente el camino principal de transmisión.
El puente diseñado, como se muestra en el esquemático (6.1.5), agrega dos transformadores de RF TC1-1-13M+ [20] en cascada, que permiten medir la señal reflejada de manera desbalanceada y filtrar el ruido de modo común que provocaría usar solo uno. Las resistencias de 68 Ω logran que la impedancia vista desde el puerto de salida (J1) sea 50 Ω.
En la figura 3.5 se presentan las curvas de respuesta en frecuencia simuladas para los cuatro parámetros característicos de un acoplador direccional, en el rango de 0,1 a 3 GHz. Como se puede observar, el acoplamiento tiene una respuesta plana en toda la banda, esperable para un puente resistivo, manteniéndose constante alrededor de los 15 dB. La pérdida de inserción tiene valores razonables teniendo en cuenta que las resistencias disipan potencia, oscilando cerca de los 10,5 dB. El aislamiento tiene su máximo nivel de atenuación en la banda de interés (entre 1,8 y 2,2 GHz) pero mantiene un buen nivel en toda la banda, por encima de los 48 dB. La directividad tiene la misma forma, con un pico elevado de 37,3 dB en torno a 1,9 GHz pero manteniéndose sobre los 36,5 dB para las frecuencias de interés. Esto garantiza una muy buena separación entre las ondas incidente y reflejada, reduciendo errores sistemáticos. Es importante aclarar que las simulaciones se realizaron en el software uSimmics v 5.9 [21] y las resistencias utilizadas para simular fueron ideales, por lo que se espera un rendimiento un poco menor en la implementación real, sobre todo por la tolerancia de las resistencias a altas frecuencias. Los transformadores de RF se caracterizaron con datos de sus parámetros S brindados por el fabricante.


Figura 3.5: Parámetros simulados del puente resistivo

### 3.2.5 Amplificadores diferenciales

Al tener salidas diferenciales y de muy poca amplitud, se debe agregar una etapa de acondicionamiento que permita obtener una señal desbalanceada y apta para ser procesada por la placa de sonido de la PC. Esta etapa utiliza amplificadores operacionales MCP6023 de Microchip Technology [22] de alimentación simple (rail-to-rail). Se configuran como restadores, permitiendo referir las señales a masa y proveer la ganancia necesaria para trabajar dentro del rango dinámico de la placa de sonido. Su esquemático se puede observar en 6.1.6. Aunque allí se usa una ganancia unitaria, en el ensamblado se midió la salida del mezclador y se calculó una ganancia de 8,33 veces para la señal incidente y 55,55 veces para la señal reflejada. De esta forma se aprovecha mejor el rango dinámico de la entrada de la placa de sonido, cuya entrada satura alrededor de 2 Vpp según mediciones realizadas en el laboratorio. Las resistencias utilizadas fueron de 180 Ω para R53 y R55, y 1200 Ω para R46 y R48.
Se agregaron capacitores de bloqueo de continua, y una tensión de referencia de VCC/2 obtenida mediante un divisor resistivo. De este modo, la señal alterna excursiona alrededor de ese punto de operación y puede ser amplificada sin recortes, sin necesidad de una fuente negativa.

### 3.2.6 Alimentación y conectores

Para alimentar la placa se dispone de una selección (a través de un jumper) de pines para utilizar una fuente de laboratorio o un USB-B para conectarlo a alguna salida de PC o cargador de 5 V. Se agrega un regulador de tensión UA78M33CDCYR [23] de Texas Instruments que provee los 3,3 V necesarios para alimentar a los generadores de RF y oscilador.
Los conectores que posee son del tipo SMA para mediciones de RF, conexión con el DUT y entrada de referencia auxiliar; conector de audio analógico para llevar las señales a la placa de sonido de la PC por medio de la entrada line-in, y tiras de pines que por medio de cables puente se conectan con el Arduino para escribir los registros de los generadores de RF. Además se ubican pares de pines para medir la detección de enganche en cada ADF4351.

### 3.2.7 Microcontrolador

Como se explica en la sección 2.3 de la Especificación Técnica (E), el microcontrolador se implementa utilizando una placa Arduino Uno que se conecta por medio de cables puente con los pines de control de los ADF4351: CLK, CE, LE y DATA. Actúa como un esclavo de ejecución que recibe las órdenes de barrido desde la PC a través de una interfaz serie. Opera a una velocidad de 115200 baudios.

### 3.2.8 Implementación en PCB

En principio se planteó un modelo de 2 capas, que se puede observar en las figuras 3.6.

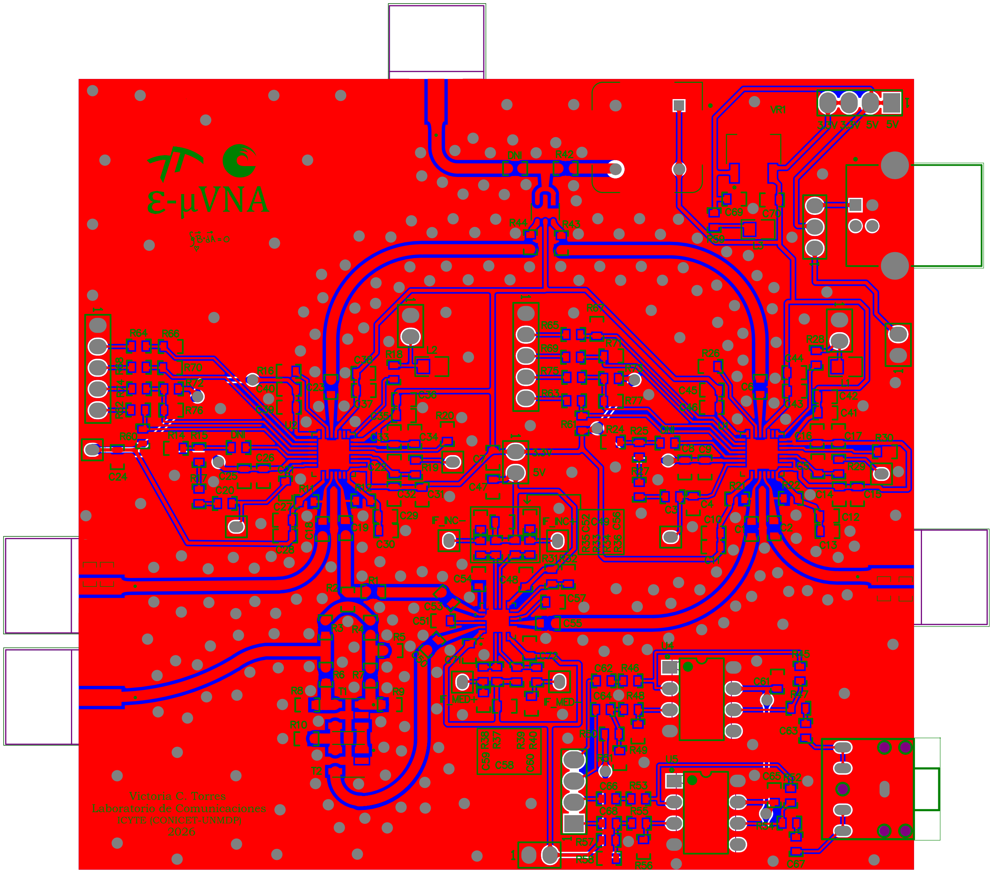
[picture p88: figure]

(a) Frente | (b) Dorso

Figura 3.6: ϵ − µV NA versión 1, frente

Tiene un espesor total de 0,9 mm, con FR4 como dieléctrico de 0,73 mm de espesor y un tamaño de 10 x 9,5 cm²
. Sin embargo, el ruteo del pin VT UNE de los ADF4351 y la alimentación en la parte central de la placa, donde había un sector rodeado de pistas de RF, imponía el uso de varios puentes. Se implementaron con postes y cables puente, pero no es la manera óptima porque son sensibles a interferencias. Por este motivo, se decidió hacer un modelo de 4 capas, que permitiera tener un plano de masa continuo bajo las pistas de RF y poder rutear usando la capa inferior, además de tener una tercera capa para el manejo de la alimentación. A este modelo se lo llamó ϵ − µV NA v2, tiene un tamaño de 8,7 x 7,8 cm² y se lo puede observar en la figura 3.7. Incorpora además algunas modificaciones en cuanto al ruteo de pines y posición de los transformadores de RF, debido a que no coinciden los pines descriptos en la hoja de datos con el integrado real.
Se pueden observar ambos modelos en 3D en la figura 3.8. La versión 2 logró una placa más compacta, con capas adicionales que facilitan el ruteo, reducen las interferencias y mantienen la integridad de las señales, a cambio de una fabricación más compleja y por lo tanto más costosa, que reduce la cantidad de posibles proveedores porque deben ser especializados.

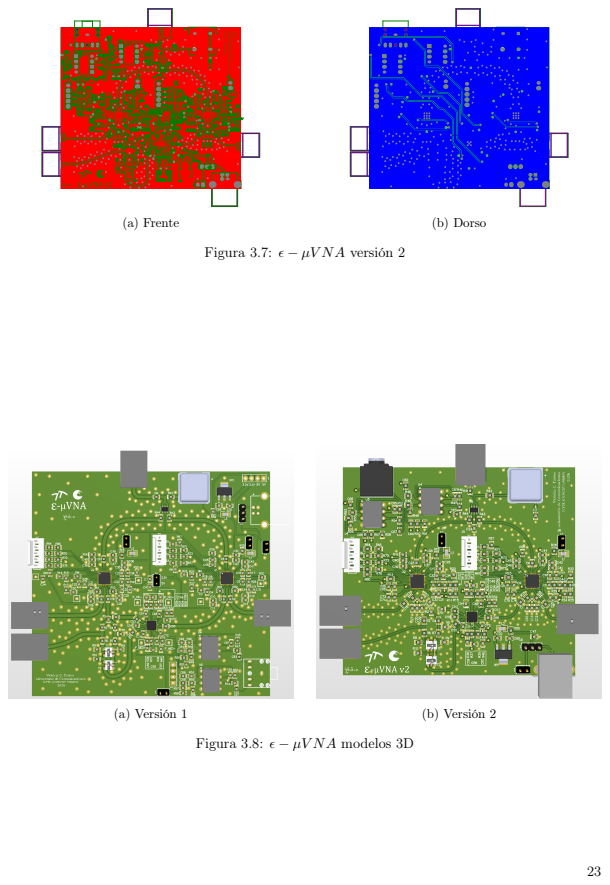
[picture p89: page 24]
(a) Frente; (b) Dorso; (a) Versión 1; (b) Versión 2

Figura 3.7: ϵ − µV NA versión 2

Figura 3.8: ϵ − µV NA modelos 3D

### 3.3 Firmware


Figura 3.9: Diagrama de flujo general del firmware.

El firmware se programó en lenguaje C++ en el entorno Arduino IDE. Se puede leer en la sección “códigos” (6.2). Está desarrollado para un microcontrolador Arduino UNO y se encarga del control, configuración dinámica y sincronización de los sintetizadores ADF4351. Un diagrama de flujo se puede ver en la figura 3.9.
Al ser inicializado en la función de arranque (setup), configura los pines de control, inicializa el bus SPI y transmite la cadena “Listo” para confir-mar que el sistema está disponible.
Al recibir una frecuencia f, el algoritmo configura el primer sintetizador (ADF1) exactamente en f (canal de RF) y el segundo sintetizador (ADF2) en f + 10 kHz (canal LO), introduciendo de forma automática el desplazamiento constante para la FI. Al finalizar la reconfiguración de ambos integrados, responde a la PC con la cadena “OK”.

### 3.3.1 Cálculo de registros

Para cada valor de frecuencia solicitado, la función “calcularRegistros” determina matemáticamente el contenido de los 6 registros de 32 bits (R0 a R5) de cada chip ADF4351 según las especificaciones del fabricante:

- Divisor de Salida de RF (RF Divider): Selecciona el divisor adecuado (1, 2, 4, 8 o 16) según el rango de frecuencia de trabajo (desde menos de 275 MHz hasta más de 2200 MHz) para garantizar que el VCO interno funcione en su rango de 2,2 GHz a 4,4 GHz.
- Frecuencia del Detector de Fase (fPFD): A partir del oscilador de referencia externo de 10 MHz, aplica la división previa por 2 (REF_DIV2 = true) y el contador R (R_COUNTER = 10), fijando una frecuencia de comparación en el PFD de 500 kHz (fPFD = 0, 5 MHz).
- Síntesis N-Fraccionaria: Divide la frecuencia del VCO por fPFD para calcular la parte entera (INT) y la parte fraccionaria (FRAC) considerando un módulo fijo MOD = 1000.
- Configuración de Registros Internos:

– R0: Almacena los bits correspondientes a ‘INT‘ y ‘FRAC‘.
– R1: Configura el prescaler en 8/9 y fija el módulo (‘MOD‘) y la fase (‘PHASE‘).

– R2: Establece la polaridad positiva del detector de fase, habilita los divisores de referencia y fija la corriente de la bomba de carga (charge pump) en 5.00 mA.

– R3: Habilita el modo de enganche rápido (fast lock).

– R4: Selecciona el divisor de RF, habilita la salida principal, fija el reloj de selección de banda (Band Select Divider ) y configura la potencia de salida en +5 dBm.

– R5: Selecciona la operación del pin de enganche (Lock Detect). El resto de los bits son un registro de control fijado según recomendación de la hoja de datos.

### 3.3.2 Transmisión SPI y secuencia de sincronización

El envío de los registros hacia los integrados se realiza mediante el bus SPI de hardware y líneas de control independientes. Utiliza pines dedicados para la habilitación Latch Enable (LE) y Chip Enable (CE). Cada registro se envía dividiendo los 32 bits en 4 bytes (MSB primero) sobre la interfaz SPI, generando un pulso positivo de 2 microsegundos en la línea ‘LE‘ para almacenar los datos en el integrado. Los registros se escriben en orden inverso, desde R5 hasta R0, debido a que la transferencia del registro R0 actúa como el disparador (trigger ) que actualiza efectivamente la frecuencia del VCO.
Para mejorar la coherencia y estabilidad de fase en el canal del Oscilador Local (ADF2), se aplica un procedimiento en dos etapas: se escriben primero los registros R5 a R1, se genera un retardo intencional de 10 milisegundos para permitir la estabilización parcial del lazo, y finalmente se escribe el registro R0 para cerrar la sintonía.

### 3.4 Software

Como se explica en la sección 4 de la Especificación Técnica E el software se programa en lenguaje Python en el entorno Visual Studio Code. El código se encuentra en la sección 6.3. Un diagrama de bloques general se puede ver en la figura 3.10. Las funciones principales que cumple son:

- Gestionar el barrido en frecuencia;
- Controlar la adquisición de audio;
- Ejecutar el procesamiento digital de señales en tiempo real;
- Implementar el modelo de calibración SOL de un puerto para obtener el coeficiente de reflexión (Γ) del DUT;
- Mostrar resultados.

Las configuraciones iniciales son: Puerto COM, baudrate, frecuencias de inicio, fin y paso, offset (es decir, frecuencia de audio a utilizar), frecuencia de muestreo para la adquisición, duración de la captura y su descarte inicial debido al transitorio, los nombres de los archivos de salida, la frecuencia central del filtro FIR (que debe coincidir con la frecuencia de audio), su ancho de banda, numtaps y ventana a utilizar.
La función principal (main) genera el vector de frecuencias a partir de las frecuencias de inicio, fin y paso. Luego diseña el filtro pasabanda. Revisa el directorio en búsqueda de un archivo de calibración cuyo nombre (predefinido con las configuraciones de frecuencia) coincida con las ingresadas por el usuario. En caso afirmativo, pregunta si se desea utilizar o se prefiere realizar una nueva calibración. Dependiendo de la respuesta del usuario por terminal, entra al bucle de calibración o carga los parámetros desde el archivo. Procede a realizar la conexión con el microcontrolador. Si se debe calibrar, realiza tres barridos para obtener los valores de ΓMED y completar la matriz de calibración. En estos barridos el usuario debe ir cambiando la carga de prueba en el orden que va indicando el programa: cortocircuito, circuito abierto y carga de 50 Ω. Una vez que se hacen los barridos calcula los errores y se guardan en el archivo CSV (archivo de texto plano donde los valores están separados por comas). Realiza el barrido del DUT y cierra el puerto serie. Aplica la corrección, calcula la fase en grados y el módulo en dB y se guardan en vectores separados. Crea un archivo CSV con estos datos y muestra los resultados en gráficos de módulo y fase en función de la frecuencia.

### 3.4.1 Flujo de barrido

La función “barrido” se encarga de enviar los datos de la frecuencia a generar, recibir la señal analógica y guardar los resultados en un vector. Su diagrama de flujo se puede ver en la figura 3.12.
Los parámetros que recibe son: el objeto de conexión serial con el microcontrolador (que da acceso al buffer de transmisión y recepción); el vector de frecuencias a medir, los coeficientes del filtro FIR, un nombre para la medición (para identificar si es un barrido de calibración o de medición), y los errores de calibración si fuese necesario. Devuelve un vector de S11 complejos (formato binario).
Consiste en un bucle for que recorre el vector de frecuencias, seteando cada una en el microcontrolador con la función “write” de la librería “serial” para luego leer su respuesta con “readline”. Si esta comienza en “error” aborta el barrido. De otra forma, captura el audio usando la librería “sounddevice”. Para eso calcula el número de muestras a adquirir como la multiplicación de la frecuencia de muestreo y la duración de la captura. Graba los dos canales, de tipo “float64” con la función “rec”. Descarta la primera parte de la grabación para evitar incluir en el cálculo los transitorios, y guarda dos vectores: “canal_ref” y “canal_med”. Por último, mide S11 y la frecuencia en la que se encontró el batido. Para ir mostrando los valores calibrados por terminal a medida que se hace el barrido, realiza la calibración por cada punto, calcula el S11 en módulo y fase y las imprime.

### 3.4.2 Estimación del S11

La función que realiza el cálculo del S11 tiene como parámetros de entrada los vectores de muestras, la frecuencia de muestreo y los coeficientes del filtro. Un diagrama de flujo simplificado se puede observar en la figura 3.11.
Lo primero que hace es aplicar el filtro a cada canal usando la función “lfilter” de scipy.signal. Luego calcula la FFT con la función “fft.fft()” de NumPy. Utiliza una ventana que setea el usuario, que por default es la FlatTop, y que crea la función “get_window” de scipy.signal.windows. Descarta la mitad negativa del espectro de frecuencias.
Luego busca el índice del bin frecuencial de mayor amplitud (en el canal de referencia) con la función “searchsorted” de NumPy dentro de un rango frecuencial acotado alrededor de fFI, en la banda de paso del filtro. La ecuación 3.4.1 representa la búsqueda del índice, donde Xref[k] es el valor complejo del espectro en el bin discreto de frecuencia k, y arg max el operador “argumento del máximo”, que devuelve la posición o índice en el cual se alcanza la amplitud máxima.

kpico = arg max
k∈Banda
|Xref[k]| | (3.4.1)

Después crea un número infinitesimal basado en el pico del espectro para sumárselo al denominador del cálculo del S11, por si el valor de magnitud en la referencia es cero. Por último, calcula S11 como el conjugado de la división de la medición y la reflejada, usando para cada uno el bin donde se encontró el máximo de magnitud.

S11,raw =

Vmed[kpico] Vref[kpico] | (3.4.2)

Este número se almacena como un tipo complex128, un tipo de dato numérico que representa números complejos de doble precisión. Este valor no calibrado sirve como la entrada directa para el posterior algoritmo de corrección de errores vectoriales mediante el modelo de tres términos (SOL).

### 3.4.3 Calibración

El software guía al usuario para realizar tres barridos completos utilizando las cargas del método SOL. Almacena en tres vectores (GM_CC, GM_CA y GM_50) las mediciones complejas

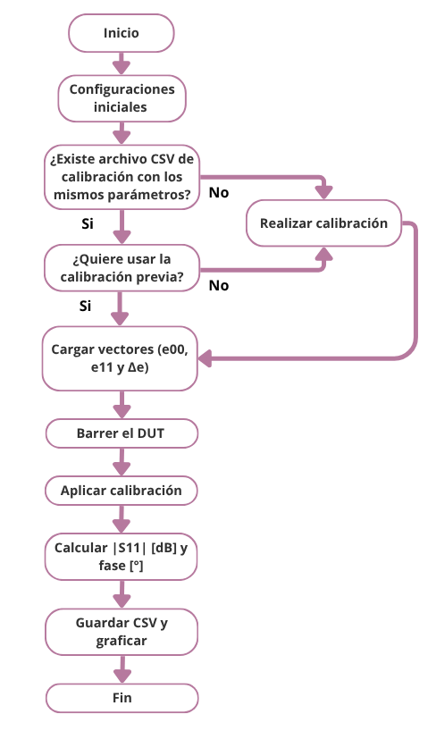
[picture p90: figure]

Figura 3.10: Diagrama de flujo general del software.

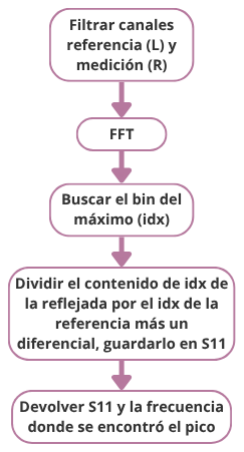
[picture p91: figure]

Figura 3.11: Diagrama de flujo de la función que calcula S11.

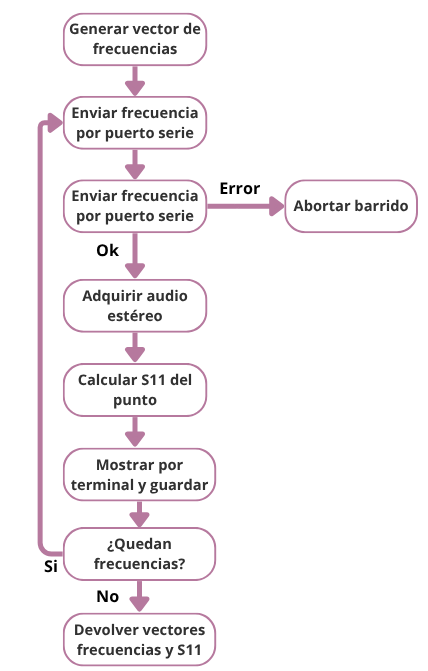
[picture p92: figure]

Figura 3.12: Diagrama de flujo de la función barrido.

crudas del cortocircuito, circuito abierto y carga de 50 Ω respectivamente. Luego, la función “calculo_errores” procesa los datos punto a punto para cada frecuencia del barrido:

- Arma un sistema de ecuaciones lineales A·x = B con coeficientes complejos, donde A es la matriz cuya fila 1 corresponde a short: [1, −GM_CC[i], 1]; fila 2 a load: 1; y fila 3 a open: [1, GM_CA[i], −1]. El vector B corresponde a [GM_CC[i], GM_50[i], GM_CA[i]].
- Resuelve el sistema mediante la función “linalg.solve(A,B)” de NumPy, que permite obtener las tres incógnitas por cada punto en frecuencia.

Los tres vectores de error se guardan en un archivo CSV, separando las partes reales e imaginarias de cada término con notación científica de 10 dígitos decimales junto con la frecuencia en MHz.
Cuando se ejecuta el barrido, el software aplica la función de corrección inversa sobre cada punto medido según la ecuación 2.2.5. Antes de hacerlo, se verifica que el denominador no sea nulo. Si la magnitud es menor a 10⁻¹⁵, se reemplaza por un valor insignificante (10⁻¹⁵ +j10⁻¹⁵) para evitar errores de división por cero.
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
