VictoriacTorres/euVNA/Tesis/Apendices/ER.pdf

## UNMDP-FI

## Carrera: Ingeniería Electrónica

## Especificación de Requerimientos

## Victoria Carla Torres

## Proyecto: Desarrollo de un Analizador Vectorial de Redes para medición no invasiva de glucemia


30/04/2026

Indice

### 1. Introducción

Este documento tiene como propósito definir y describir los requerimientos del proyecto final “Desarrollo de un Analizador Vectorial de Redes para medición no invasiva de glucemia” correspondiente a la carrera de Ingeniería Electrónica.
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
