VictoriacTorres/euVNA/Codigos/Yo/desenganches/frecs que no genera 300 a 500 200k.png

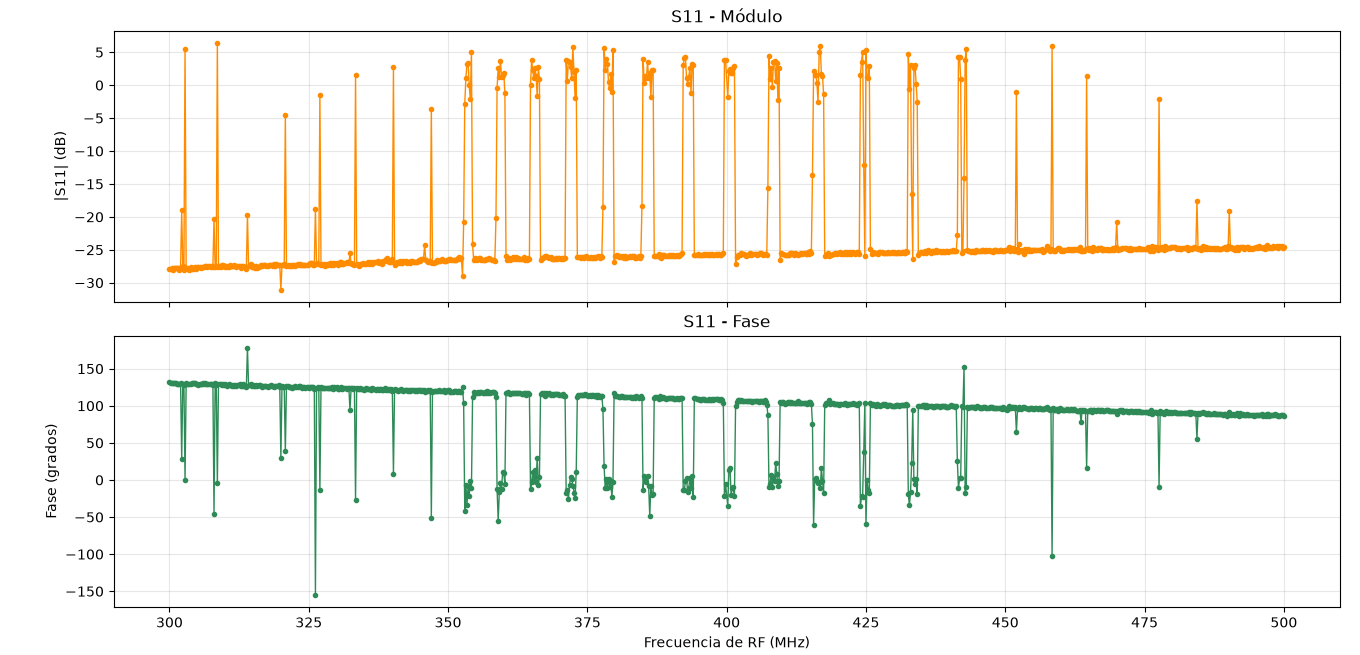
Codigos/Yo/desenganches/frecs que no genera 300 a 500 200k.png
