VictoriacTorres/euVNA/Codigos/Yo/desenganches/frecs que no genera 1400 a 1700.png

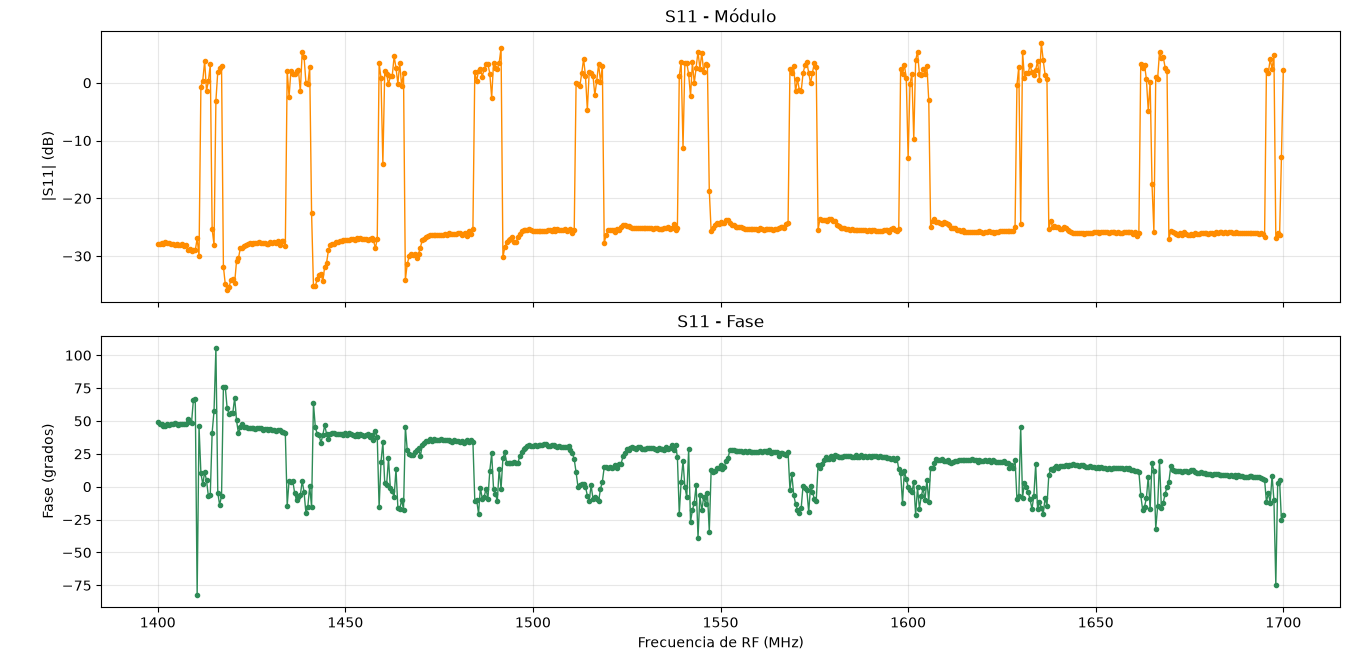
Codigos/Yo/desenganches/frecs que no genera 1400 a 1700.png
