VictoriacTorres/euVNA/Codigos/Yo/Imagenes codigos/1800a2200_abierto_10kaudio.png

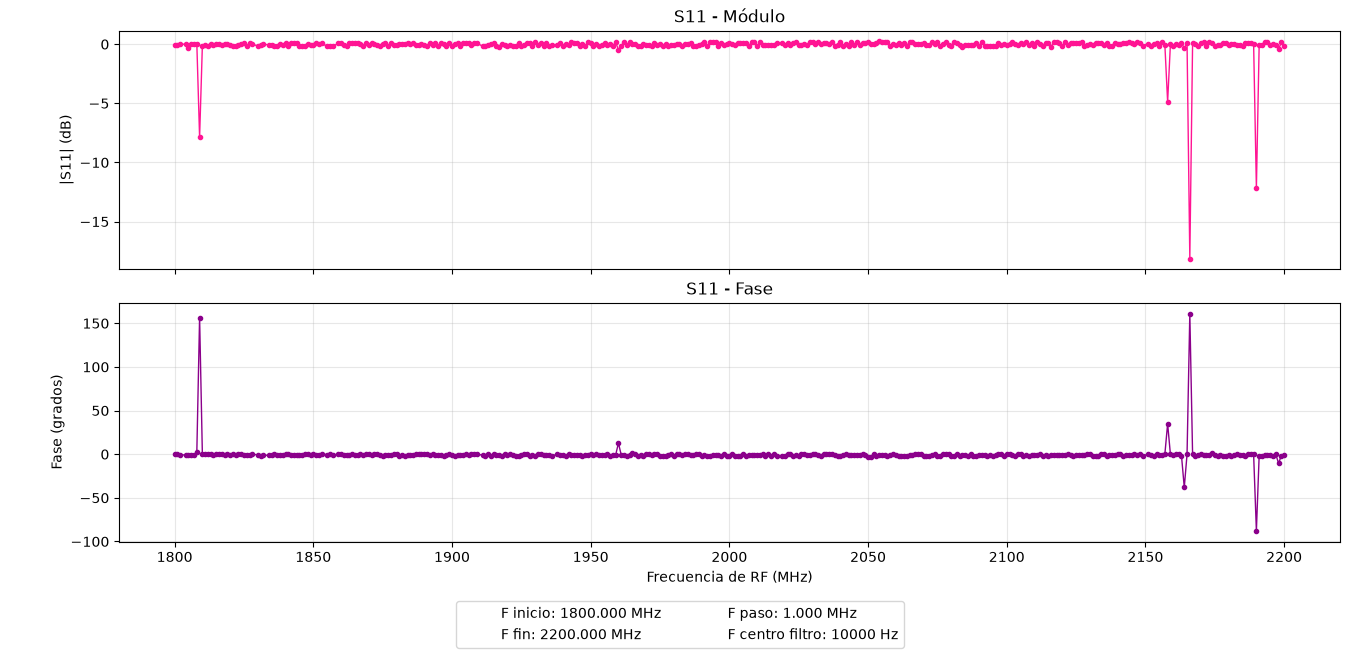
Codigos/Yo/Imagenes codigos/1800a2200_abierto_10kaudio.png
