VictoriacTorres/euVNA/Codigos/Yo/Imagenes codigos/adquis 192k derecha 44k izquierda.png

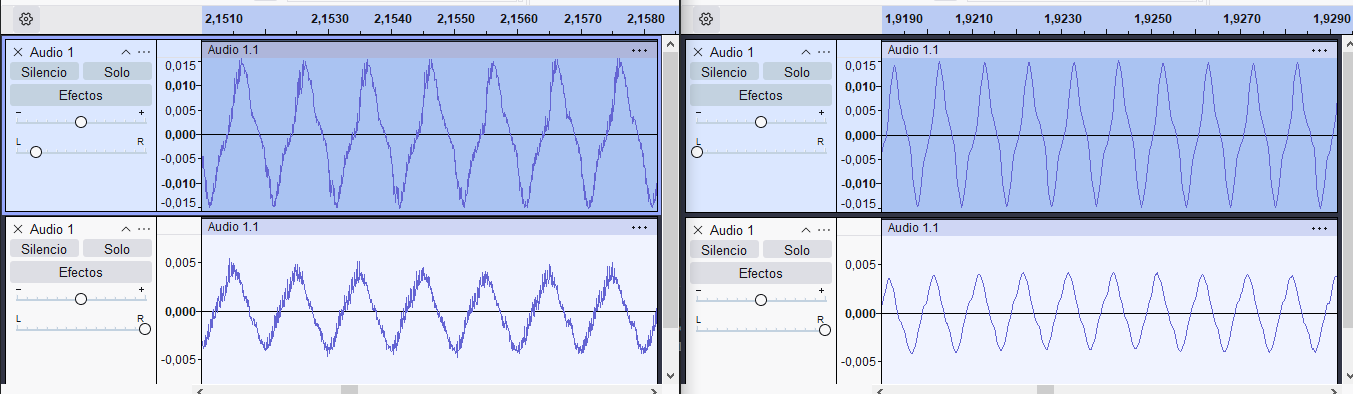
Codigos/Yo/Imagenes codigos/adquis 192k derecha 44k izquierda.png
