VictoriacTorres/euVNA/Codigos/Yo/Imagenes codigos/adquisicion 192k derecha 44k izquierda.png

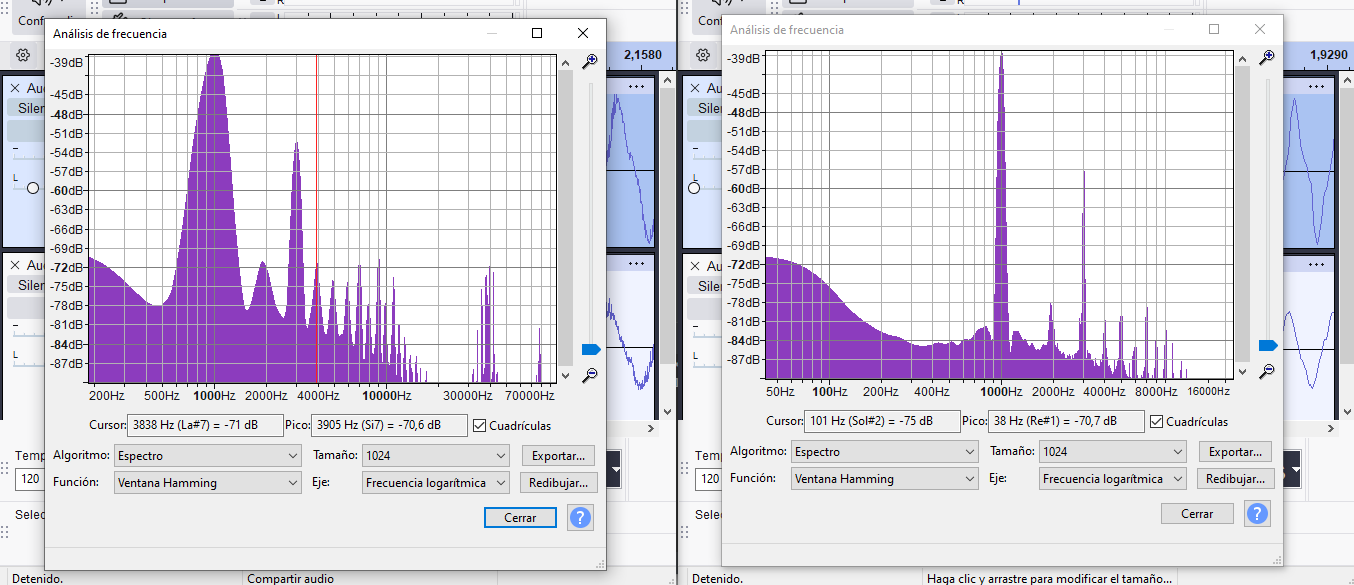
Codigos/Yo/Imagenes codigos/adquisicion 192k derecha 44k izquierda.png
