VictoriacTorres/euVNA/Codigos/Yo/Imagenes codigos/Buenas/50R_7oct.png

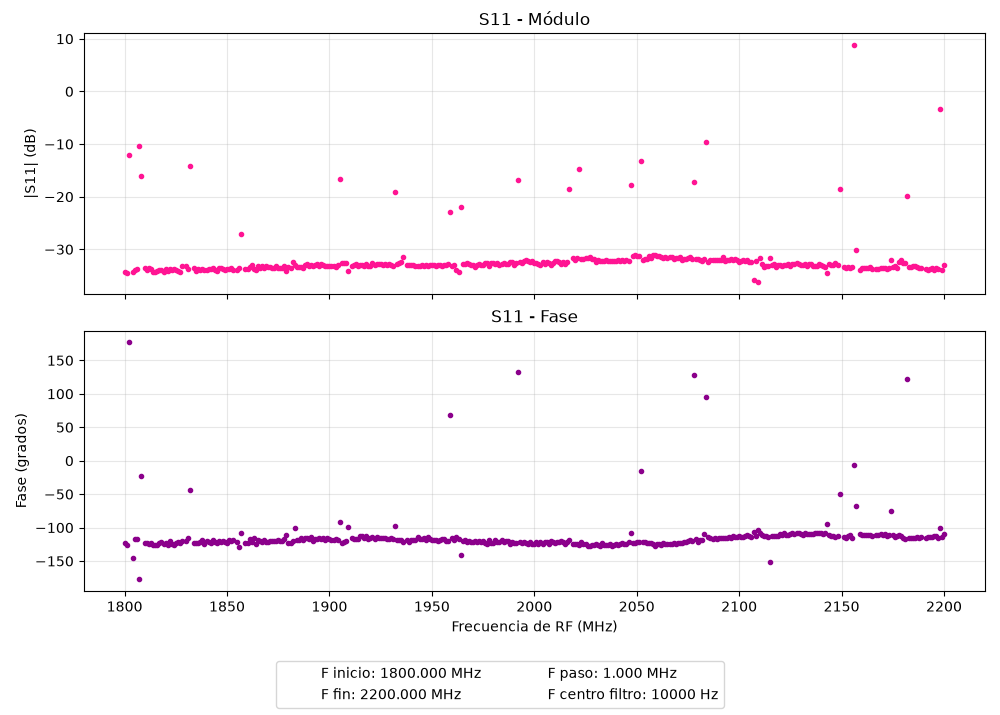
Codigos/Yo/Imagenes codigos/Buenas/50R_7oct.png
