VictoriacTorres/euVNA/Codigos/Yo/Imagenes codigos/Buenas/corto 150.png

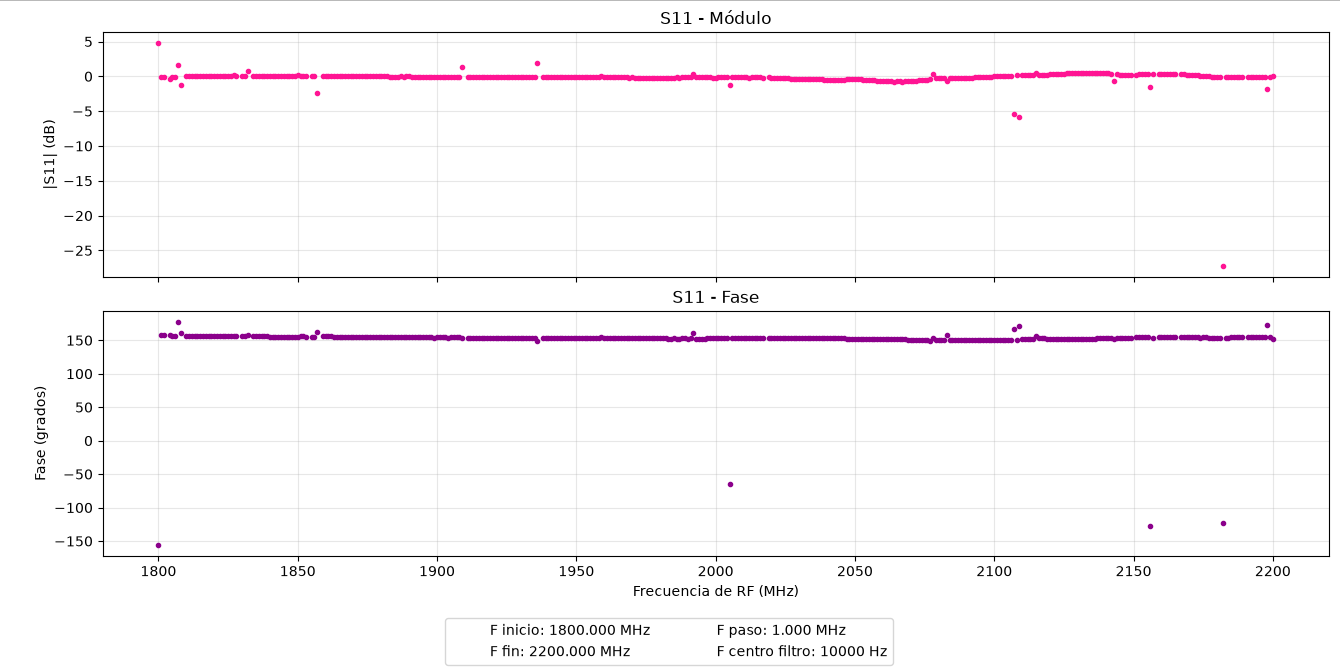
Codigos/Yo/Imagenes codigos/Buenas/corto 150.png
