VictoriacTorres/euVNA/Codigos/Yo/Imagenes codigos/cable.png

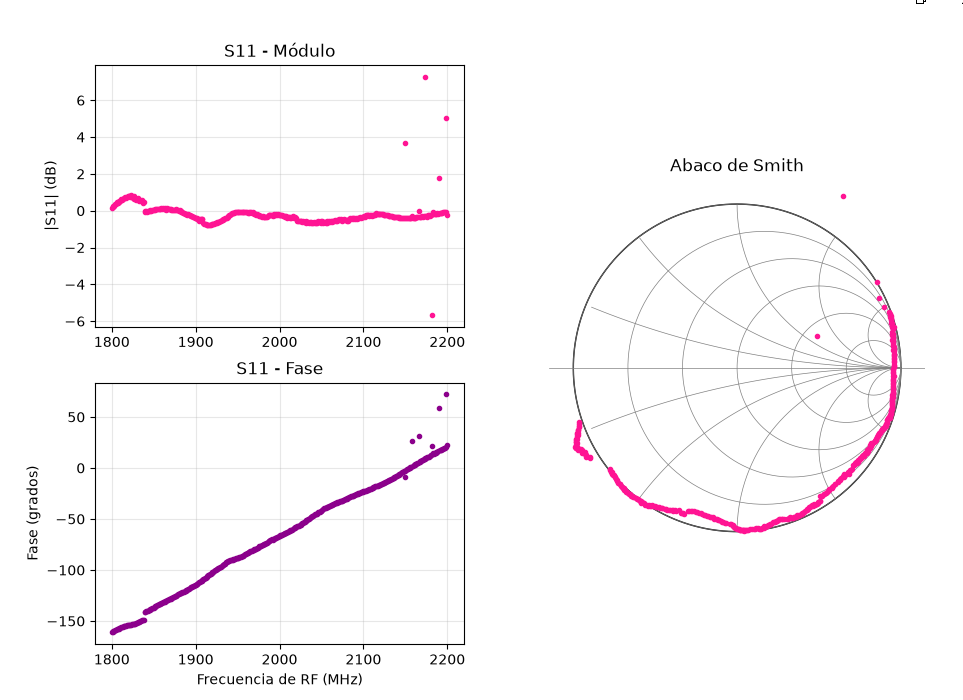
Codigos/Yo/Imagenes codigos/cable.png
