VictoriacTorres/euVNA/Codigos/Yo/Imagenes codigos/Figure_1_1M_completo_abierto.png

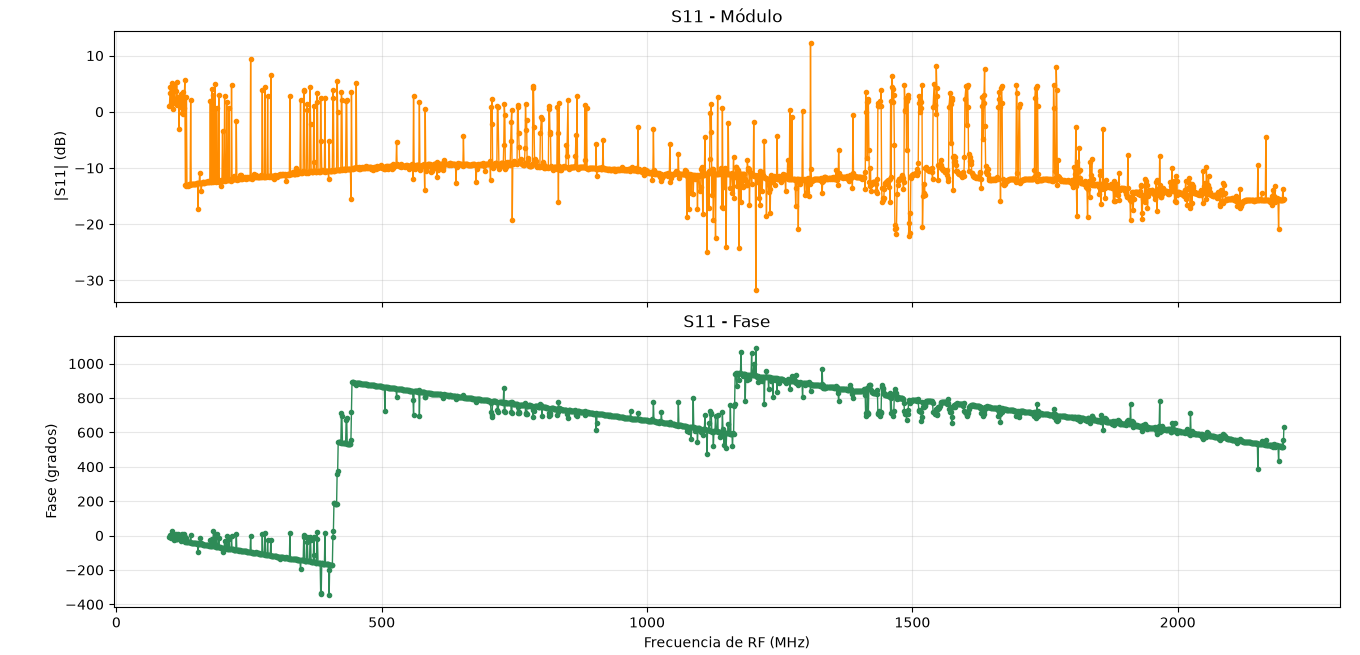
Codigos/Yo/Imagenes codigos/Figure_1_1M_completo_abierto.png
