VictoriacTorres/euVNA/Codigos/Yo/Imagenes codigos/IMAGENSENSOR.png

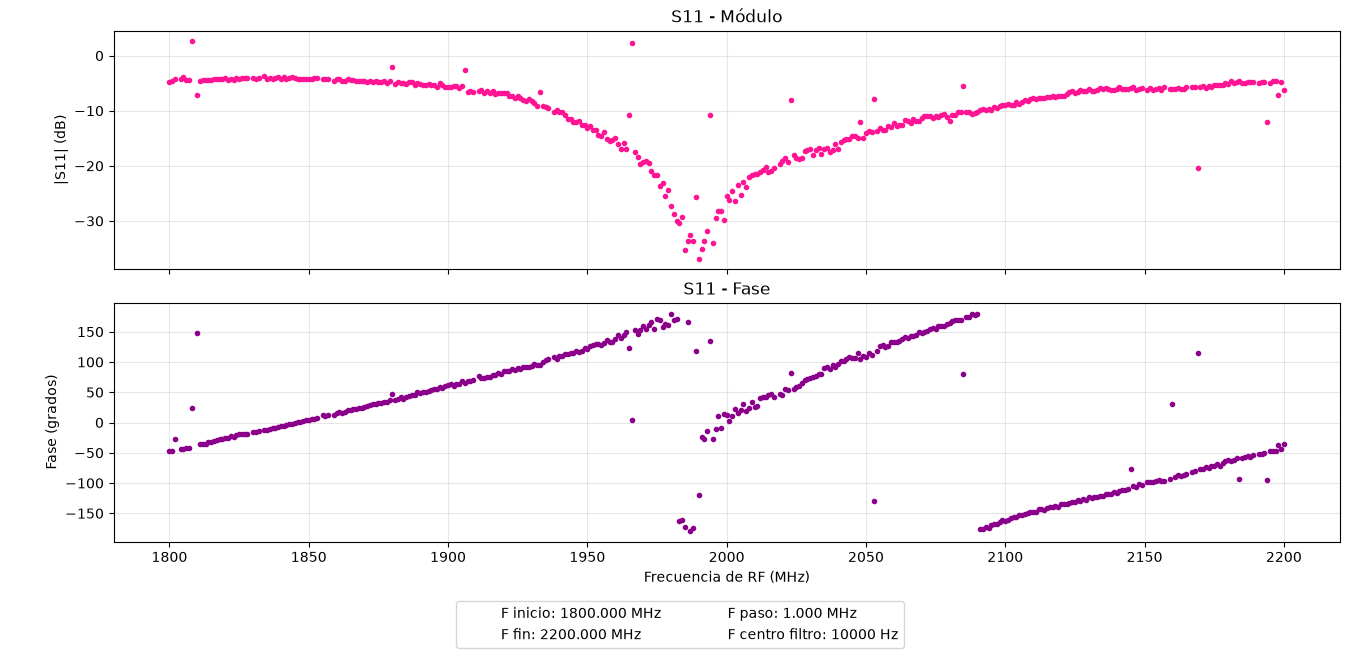
Codigos/Yo/Imagenes codigos/IMAGENSENSOR.png
