VictoriacTorres/euVNA/Codigos/Yo/Imagenes codigos/mi dedo pulgar 10 nov.png

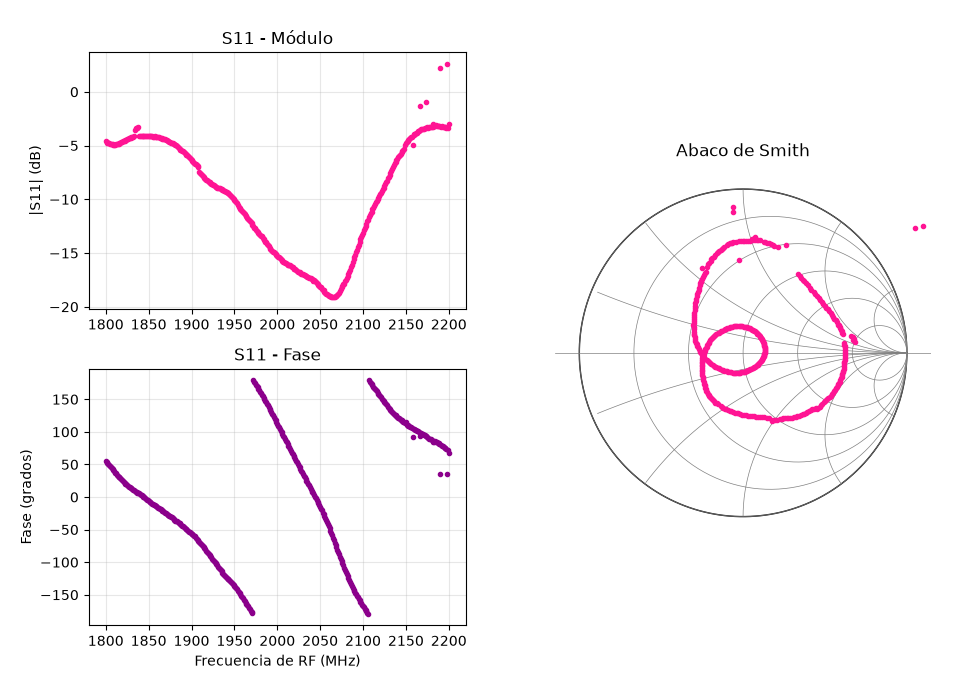
Codigos/Yo/Imagenes codigos/mi dedo pulgar 10 nov.png
