VictoriacTorres/euVNA/Codigos/Yo/Imagenes codigos/Post corte/500a3000.png

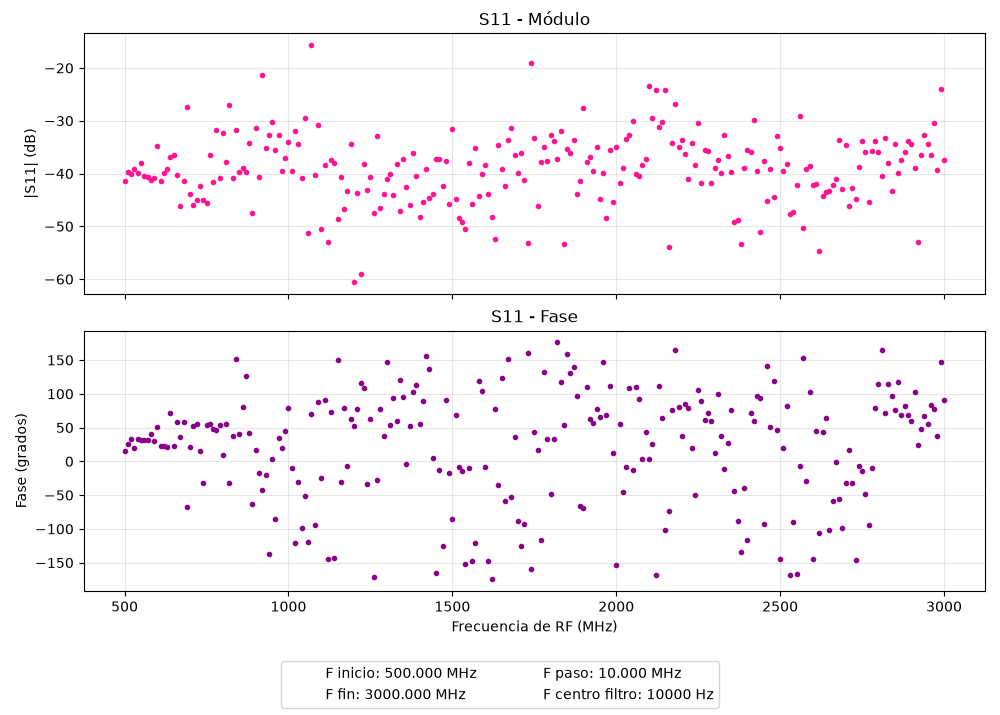
Codigos/Yo/Imagenes codigos/Post corte/500a3000.png
