VictoriacTorres/euVNA/Codigos/Yo/Imagenes codigos/r50.png

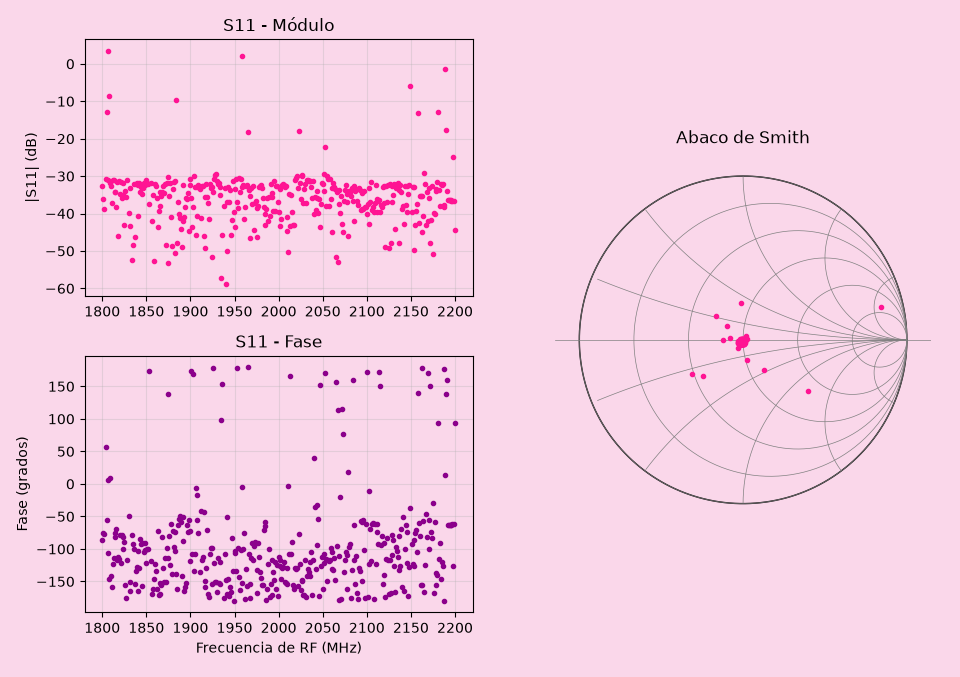
Codigos/Yo/Imagenes codigos/r50.png
