VictoriacTorres/euVNA/Codigos/Yo/Imagenes codigos/sensorvacio_5nov.png

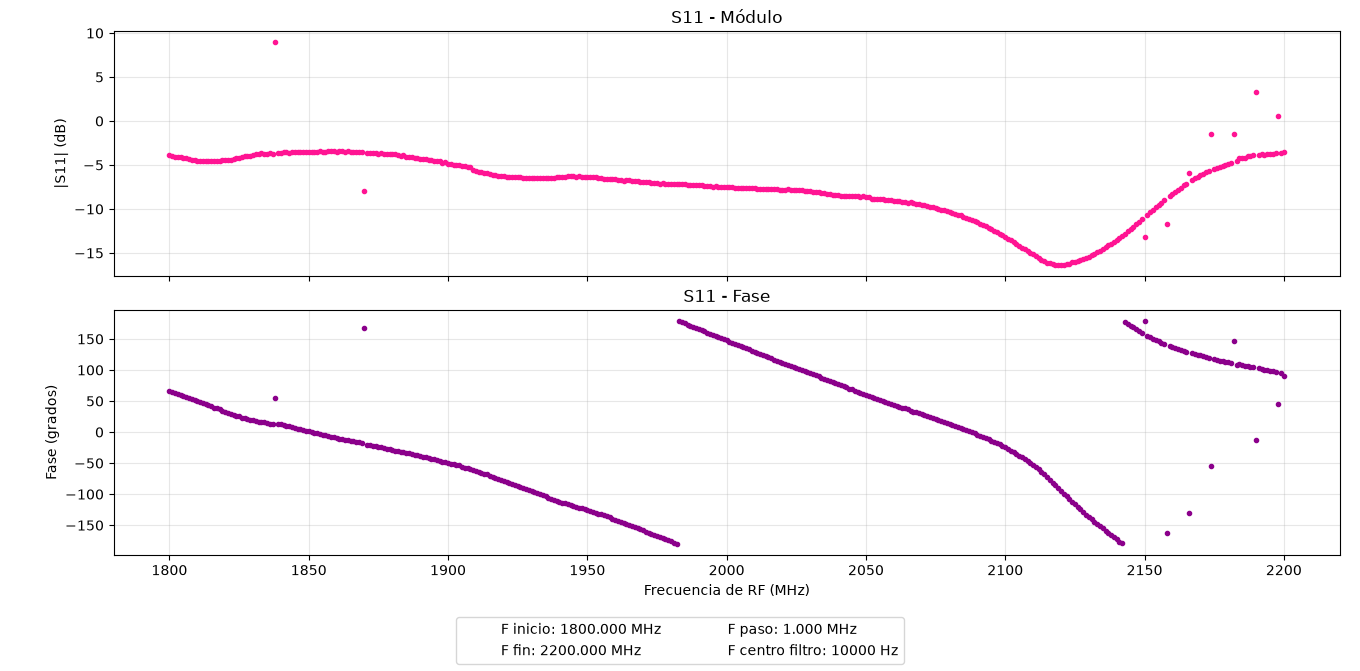
Codigos/Yo/Imagenes codigos/sensorvacio_5nov.png
