VictoriacTorres/euVNA/Codigos/Yo/Imagenes/50R_200a2200_5M.png

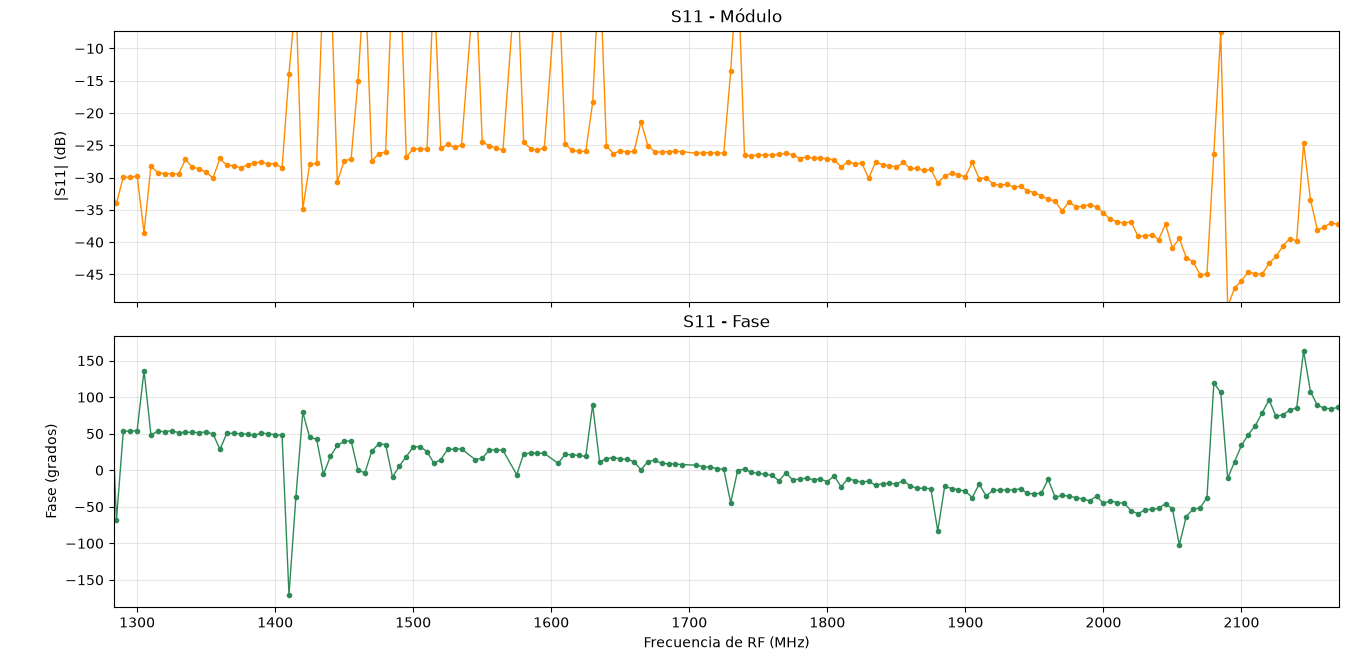
Codigos/Yo/Imagenes/50R_200a2200_5M.png
