VictoriacTorres/euVNA/Codigos/Yo/Imagenes/1800a2200_50R_10kaudio.png

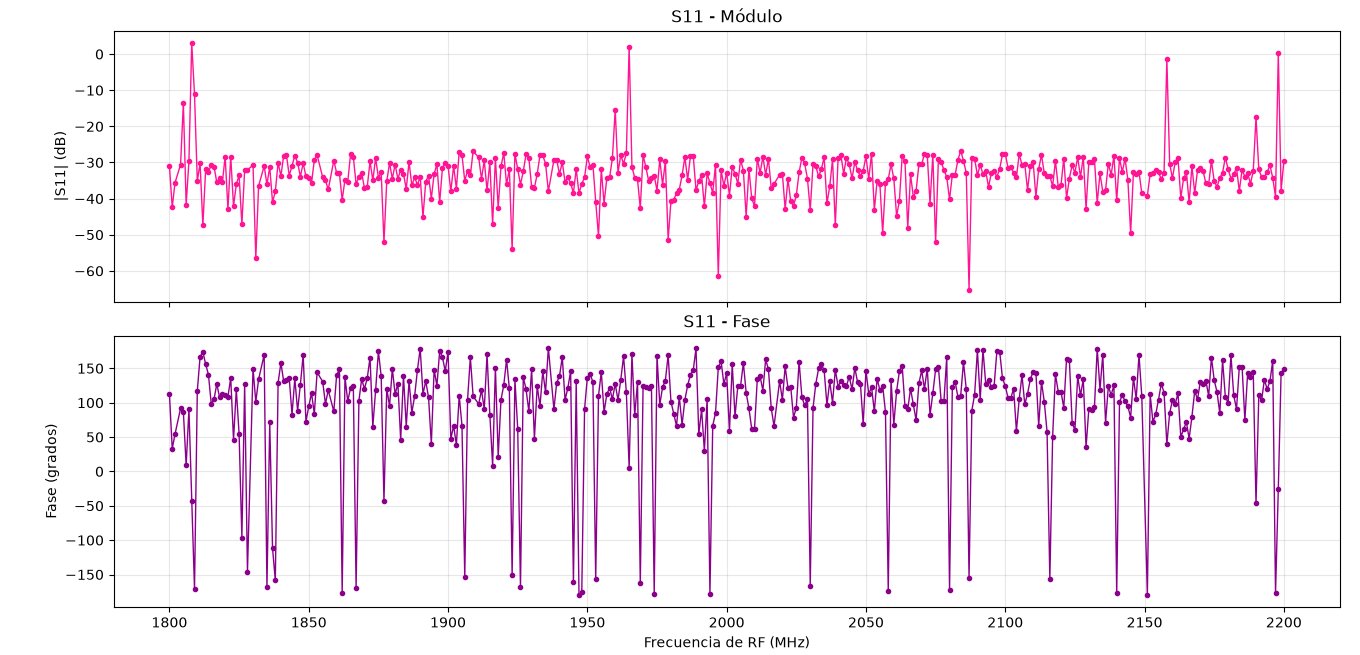
Codigos/Yo/Imagenes/1800a2200_50R_10kaudio.png
