VictoriacTorres/euVNA/Codigos/Yo/Imagenes/1800a2200_corto_10kaudio.png

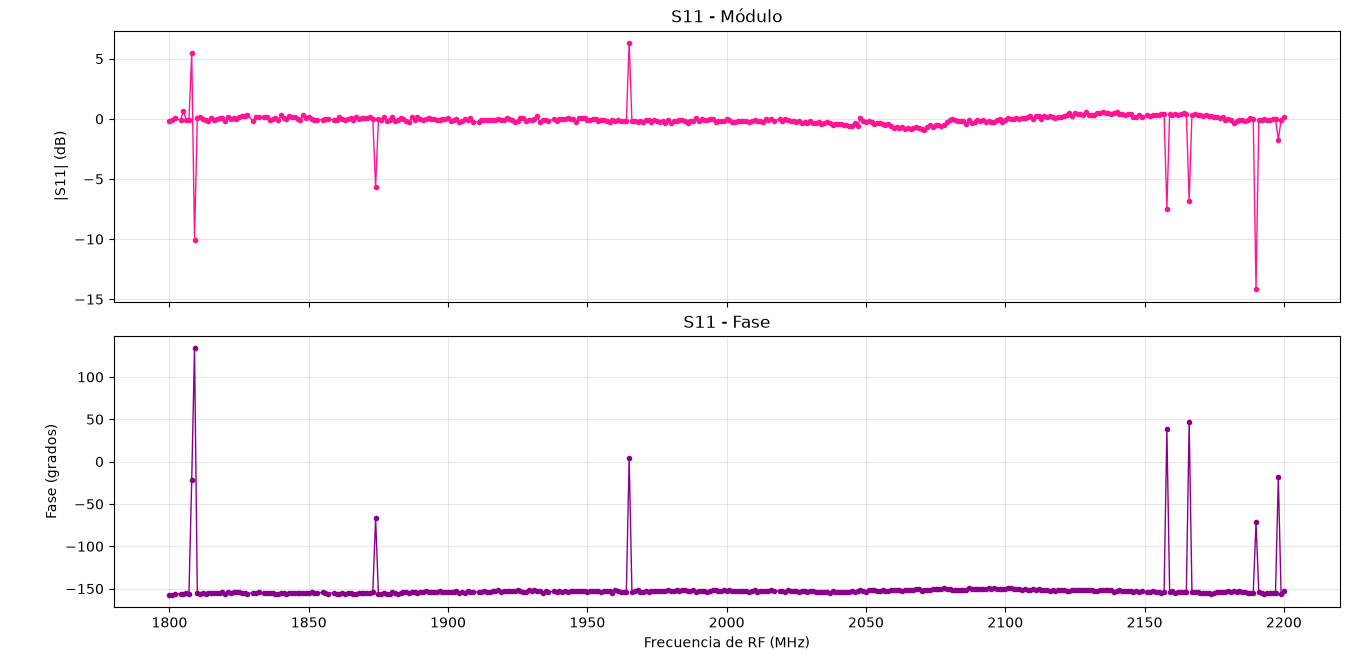
Codigos/Yo/Imagenes/1800a2200_corto_10kaudio.png
