VictoriacTorres/euVNA/Codigos/Yo/Imagenes/Buenas/50R_1000a2800_8oct.png

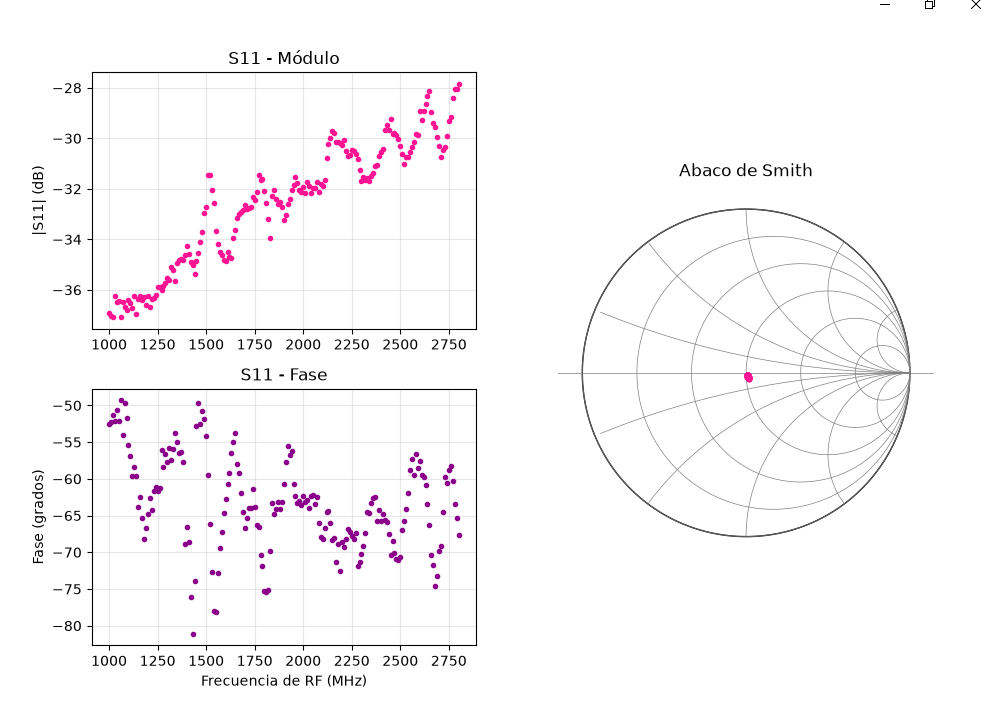
Codigos/Yo/Imagenes/Buenas/50R_1000a2800_8oct.png
