VictoriacTorres/euVNA/Codigos/Yo/Imagenes/Buenas/cableabierto_7oct.png

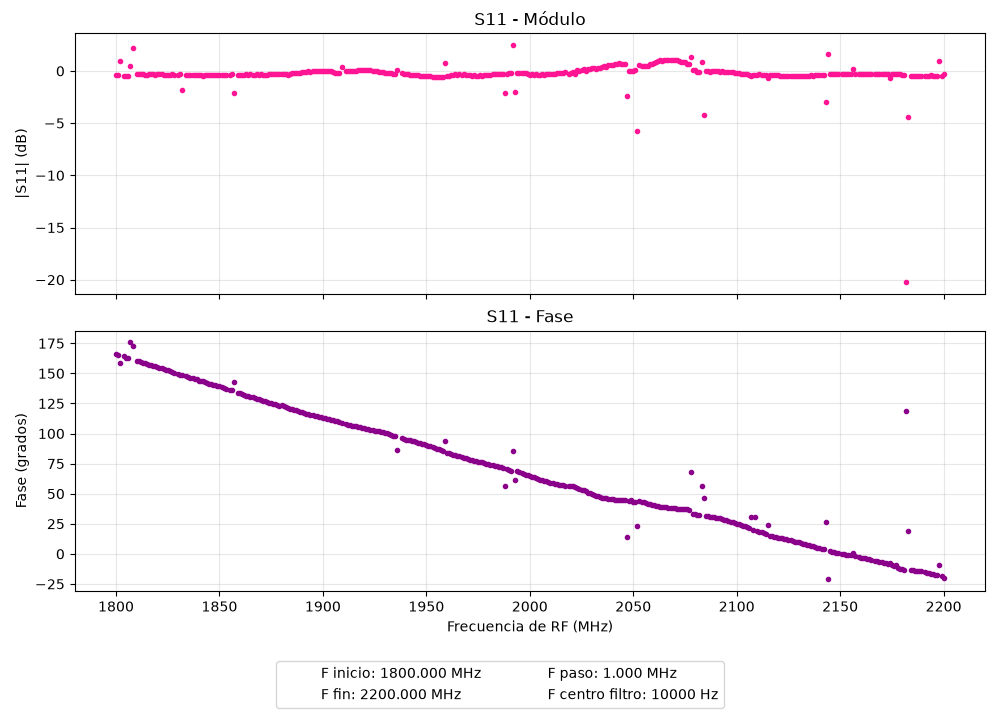
Codigos/Yo/Imagenes/Buenas/cableabierto_7oct.png
