VictoriacTorres/euVNA/Codigos/Yo/Imagenes/Buenas/carga50cal_6oct.png

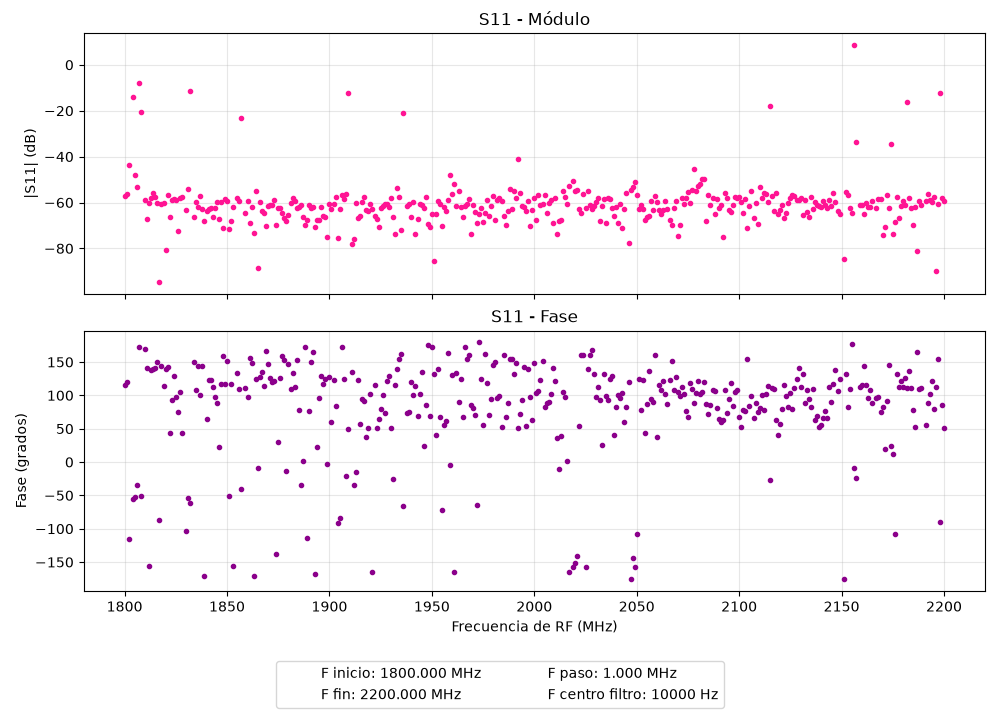
Codigos/Yo/Imagenes/Buenas/carga50cal_6oct.png
