VictoriacTorres/euVNA/Codigos/Yo/Imagenes/Buenas/carga68_7oct.png

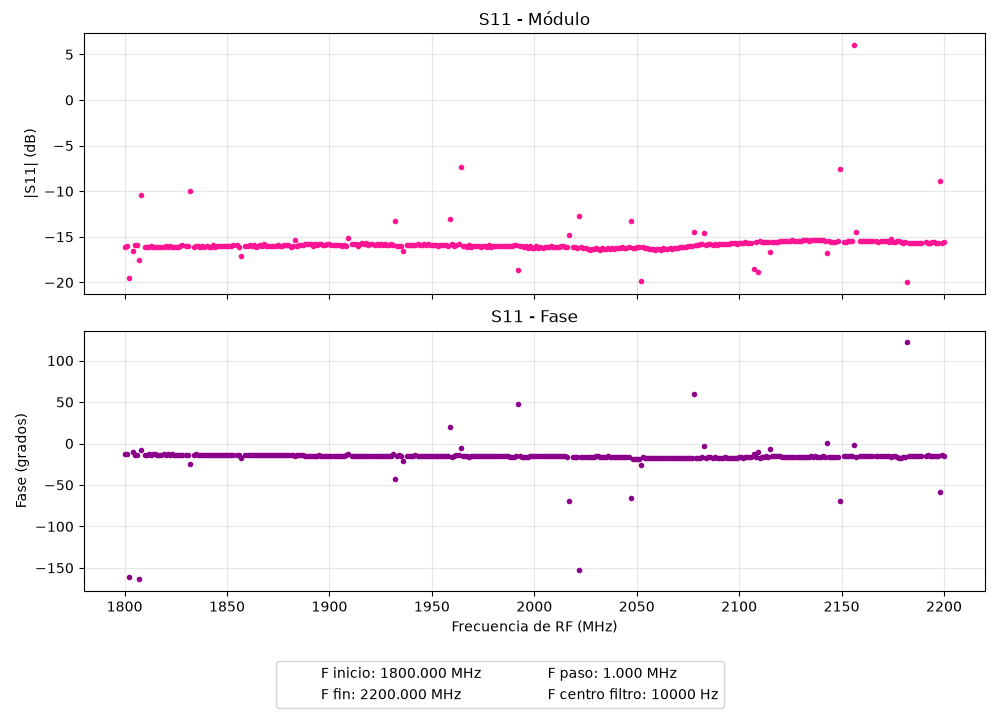
Codigos/Yo/Imagenes/Buenas/carga68_7oct.png
