VictoriacTorres/euVNA/Codigos/Yo/Imagenes/Buenas/corto150_1000a2800.png

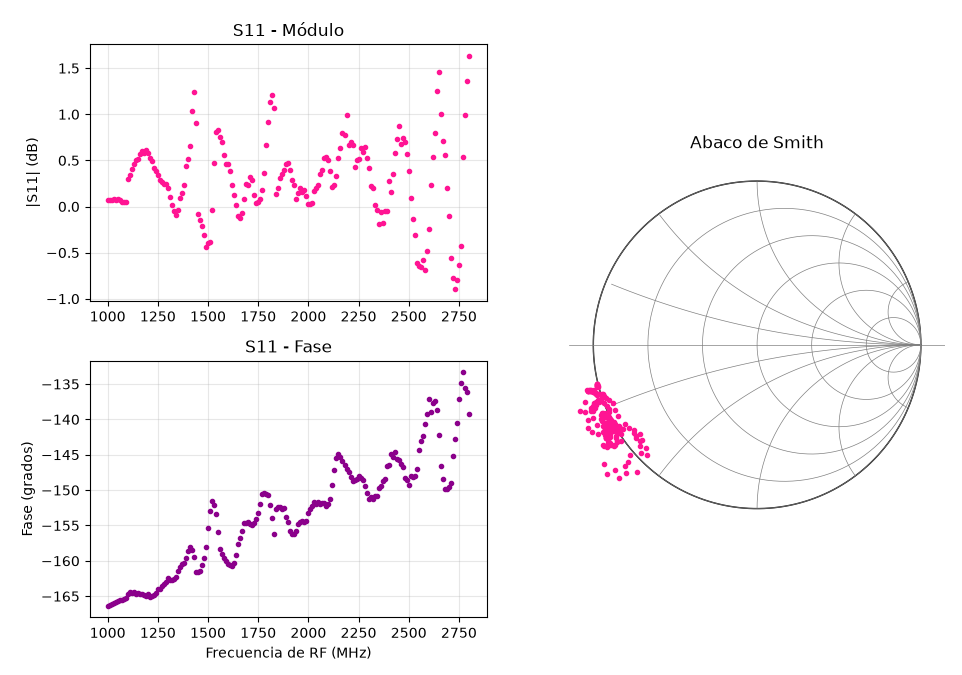
Codigos/Yo/Imagenes/Buenas/corto150_1000a2800.png
