VictoriacTorres/euVNA/Codigos/Yo/Imagenes/Figure_1_corto.png

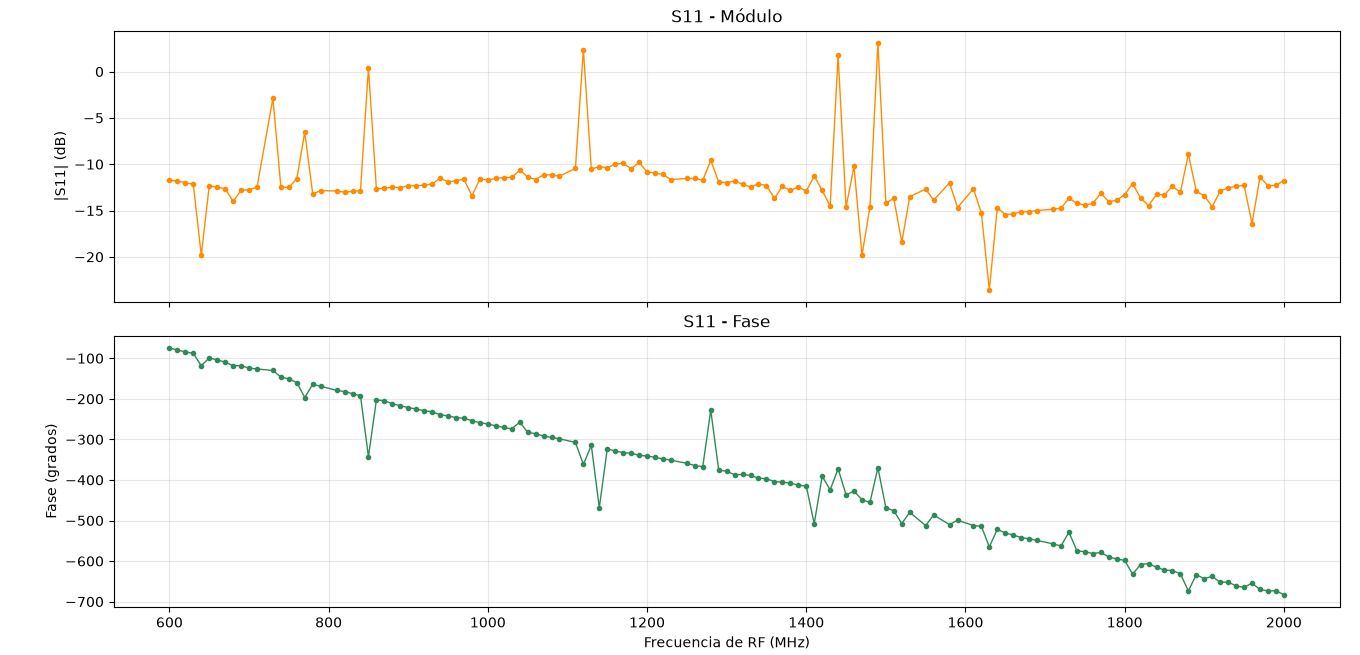
Codigos/Yo/Imagenes/Figure_1_corto.png
