VictoriacTorres/euVNA/Codigos/Yo/Imagenes/Figure_1_corto_25M.png

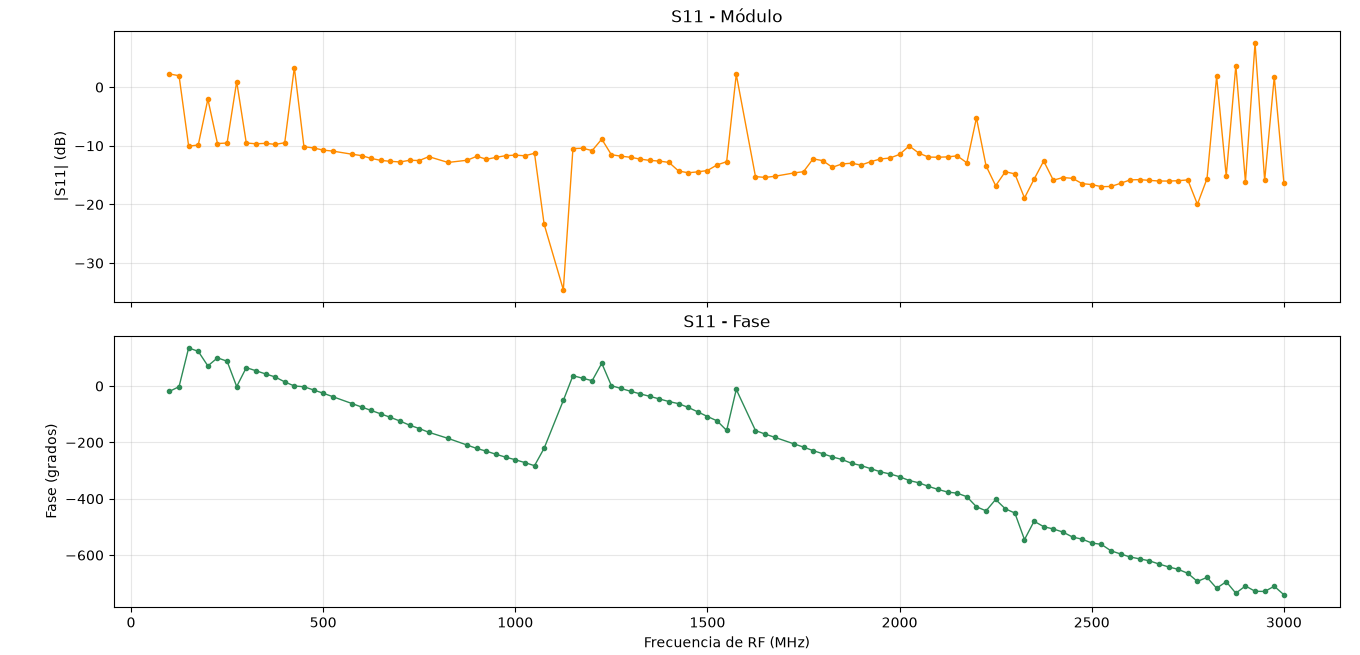
Codigos/Yo/Imagenes/Figure_1_corto_25M.png
