VictoriacTorres/euVNA/Codigos/Yo/Imagenes/IMAGEN_SENSOR_VACIO.png

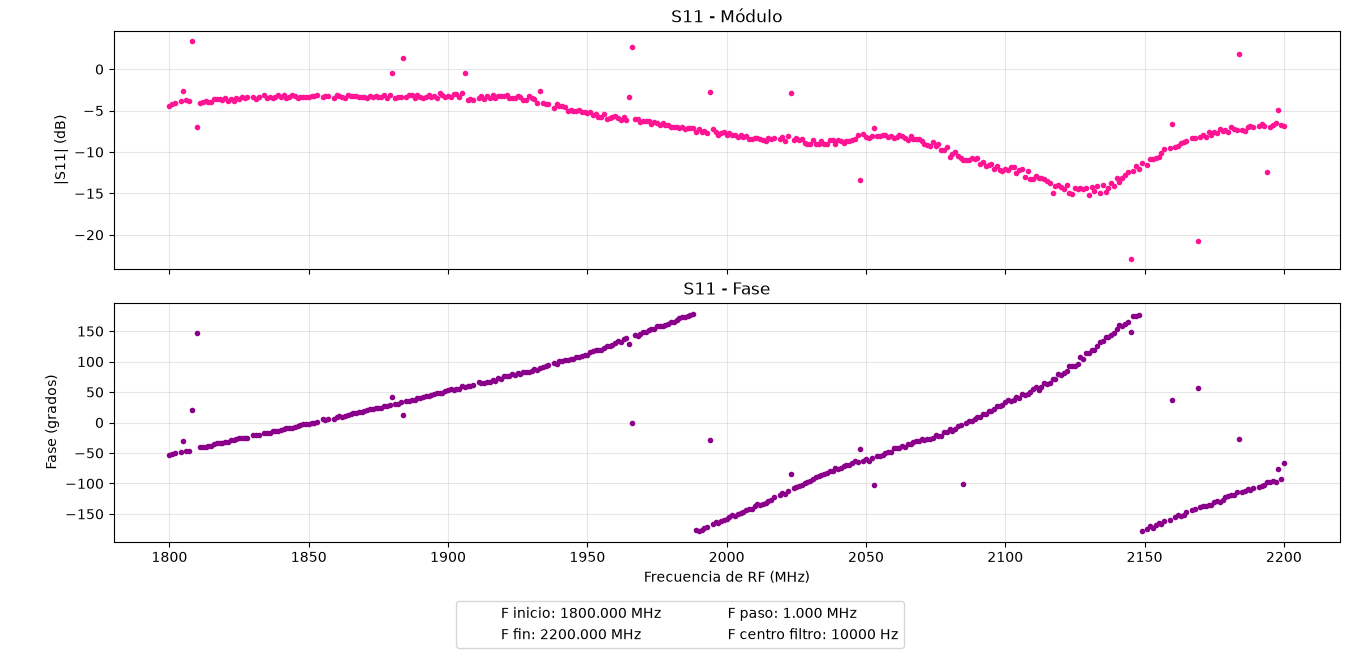
Codigos/Yo/Imagenes/IMAGEN_SENSOR_VACIO.png
