VictoriacTorres/euVNA/Codigos/Yo/Imagenes/raaaro6oct.png

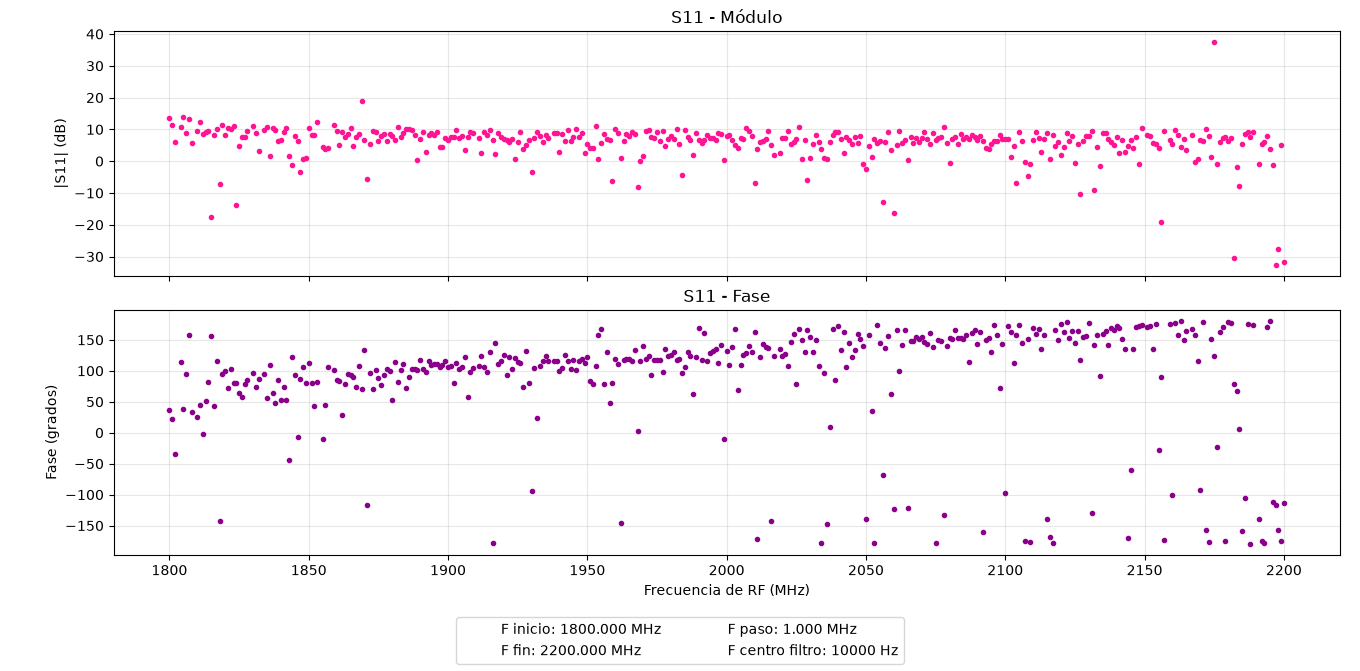
Codigos/Yo/Imagenes/raaaro6oct.png
