VictoriacTorres/euVNA/Codigos/Yo/Imagenes/s11_sincalib_sinexluidas_abierto.png

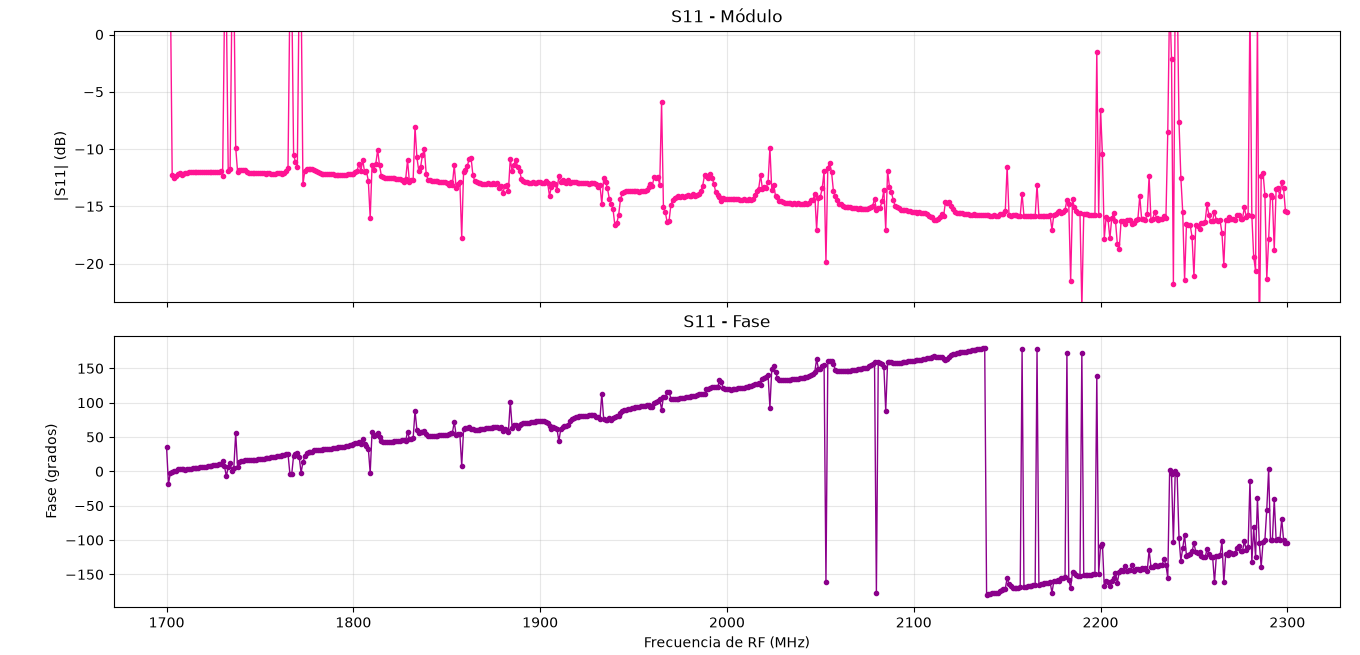
Codigos/Yo/Imagenes/s11_sincalib_sinexluidas_abierto.png
