VictoriacTorres/euVNA/Codigos/Yo/Imagenes/sensorconmidedo.png

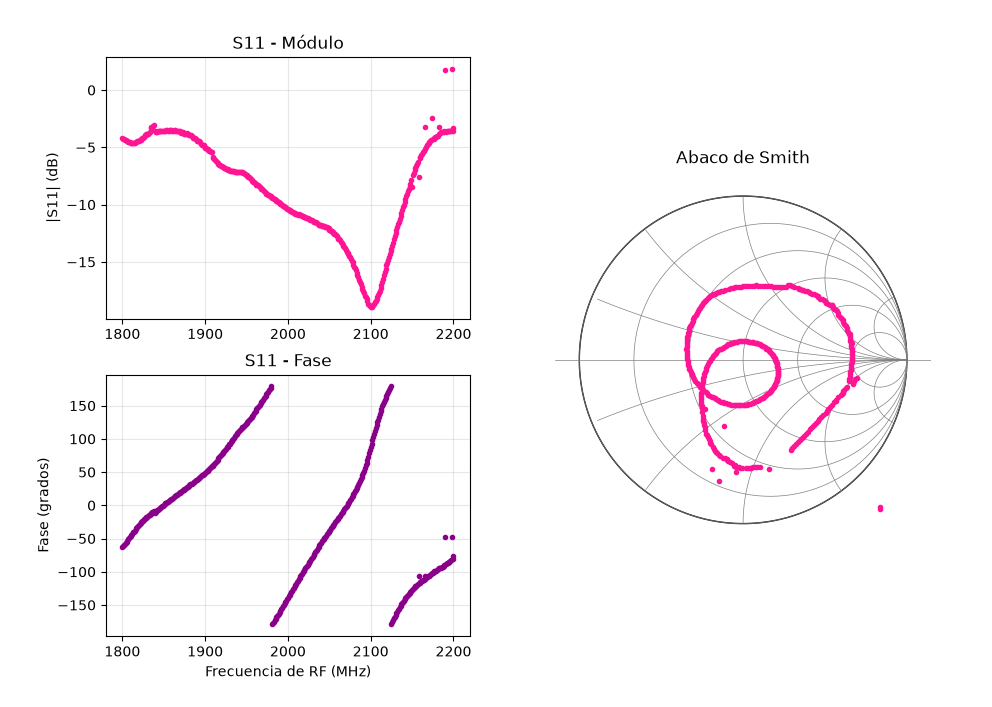
Codigos/Yo/Imagenes/sensorconmidedo.png
