VictoriacTorres/euVNA/Codigos/Yo/Mediciones modulos/1650a1670sinfiltrar.png

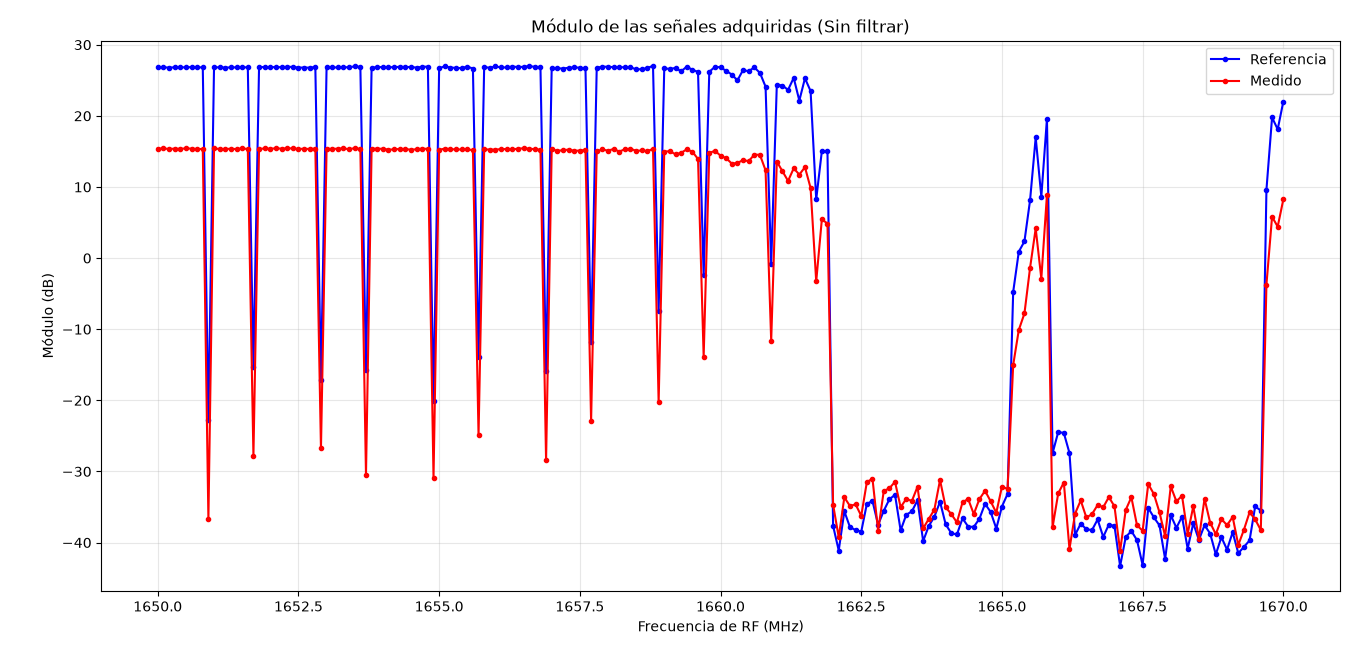
Codigos/Yo/Mediciones modulos/1650a1670sinfiltrar.png
