VictoriacTorres/euVNA/Codigos/Yo/Mediciones modulos/1700a2300sinfiltrar.png

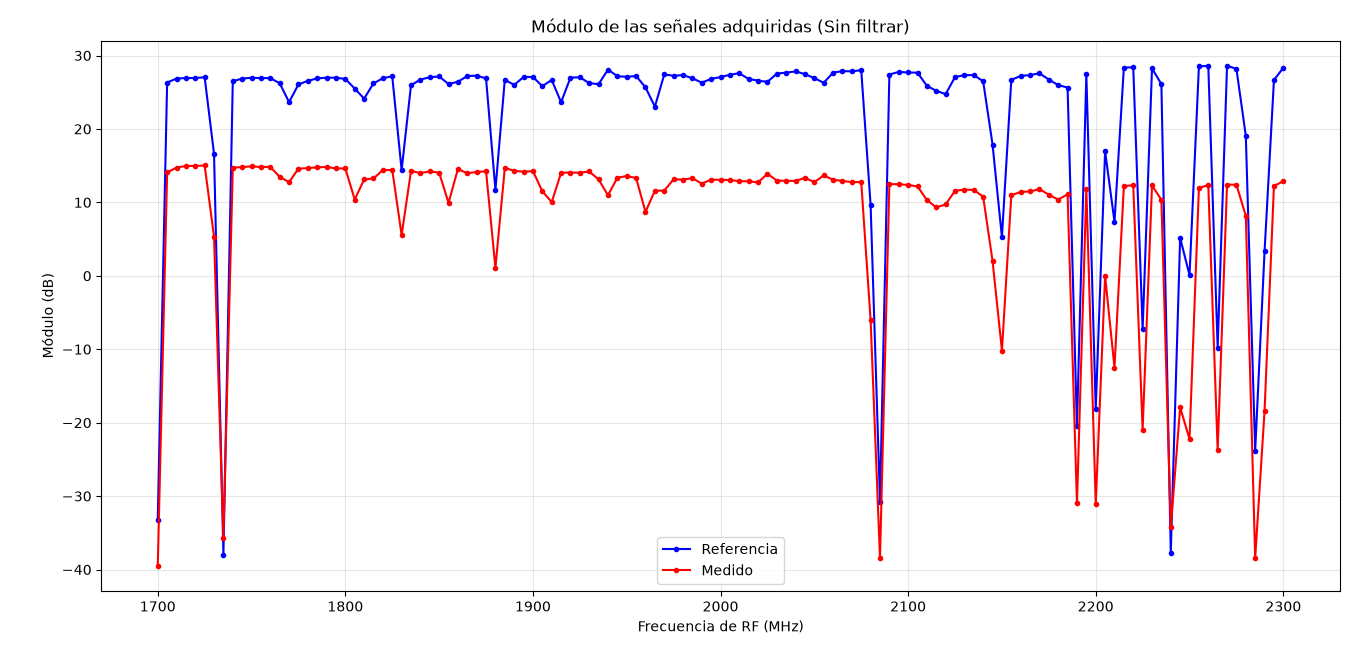
Codigos/Yo/Mediciones modulos/1700a2300sinfiltrar.png
