VictoriacTorres/euVNA/Tesis/Imagenes/banco_gen1frec.webp

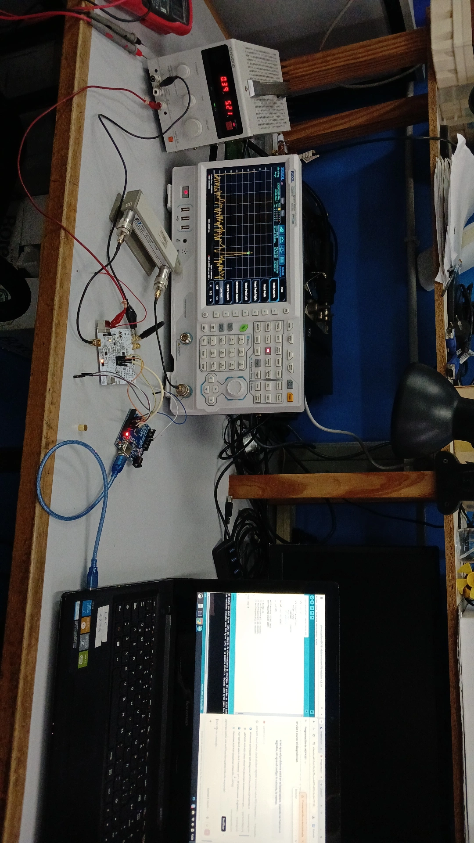
Tesis/Imagenes/banco_gen1frec.webp
