VictoriacTorres/euVNA/Tesis/Imagenes/bancosoldado.jpg

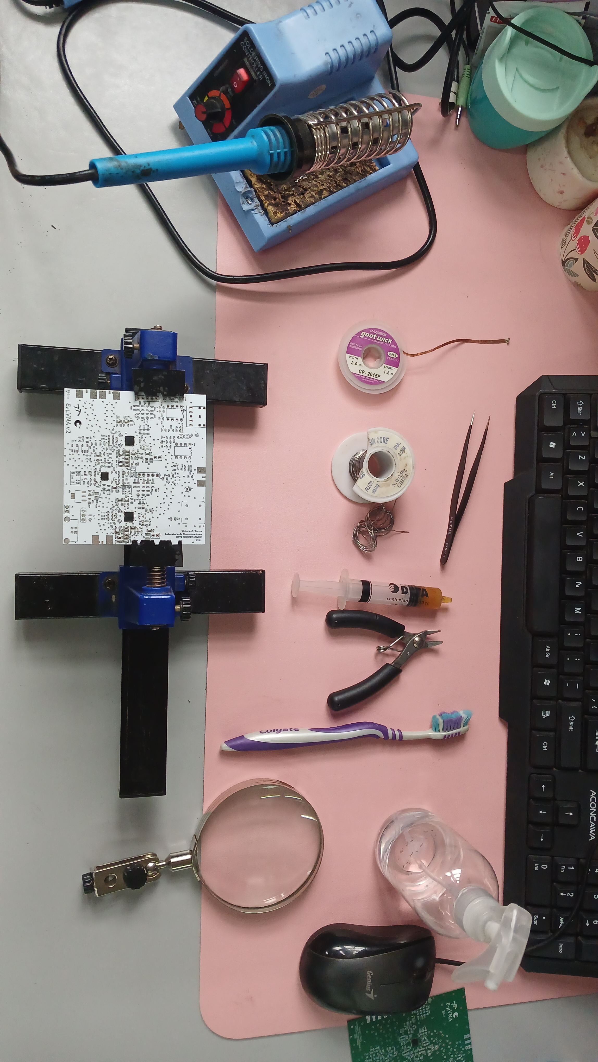
Tesis/Imagenes/bancosoldado.jpg
