VictoriacTorres/euVNA/Tesis/Imagenes/carga68_8oct_1000a2800.png

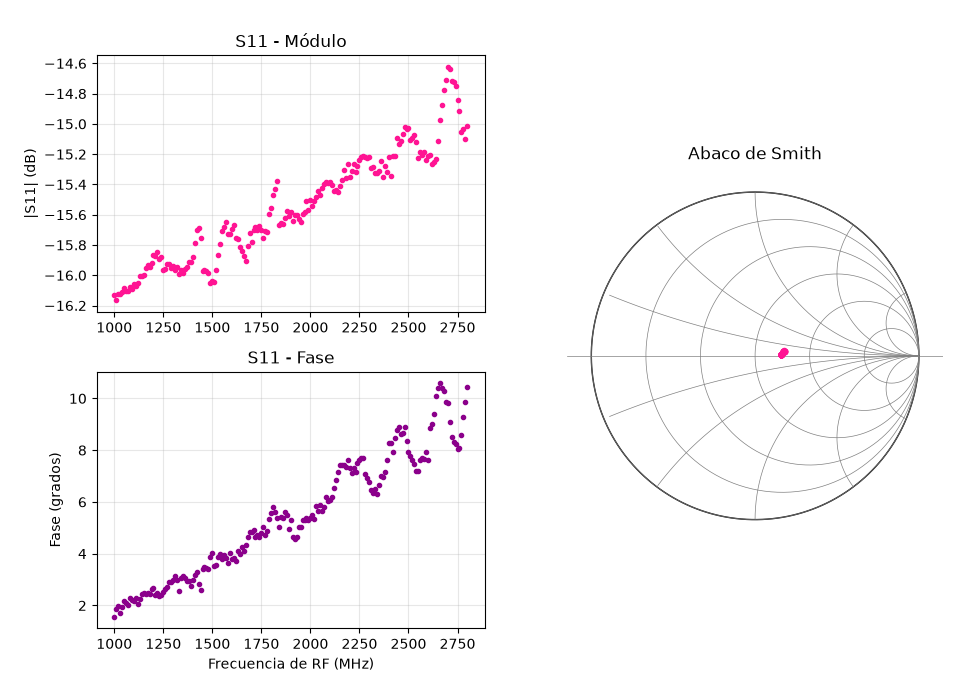
Tesis/Imagenes/carga68_8oct_1000a2800.png
