VictoriacTorres/euVNA/Tesis/Imagenes/d_flujo_interfaz.png

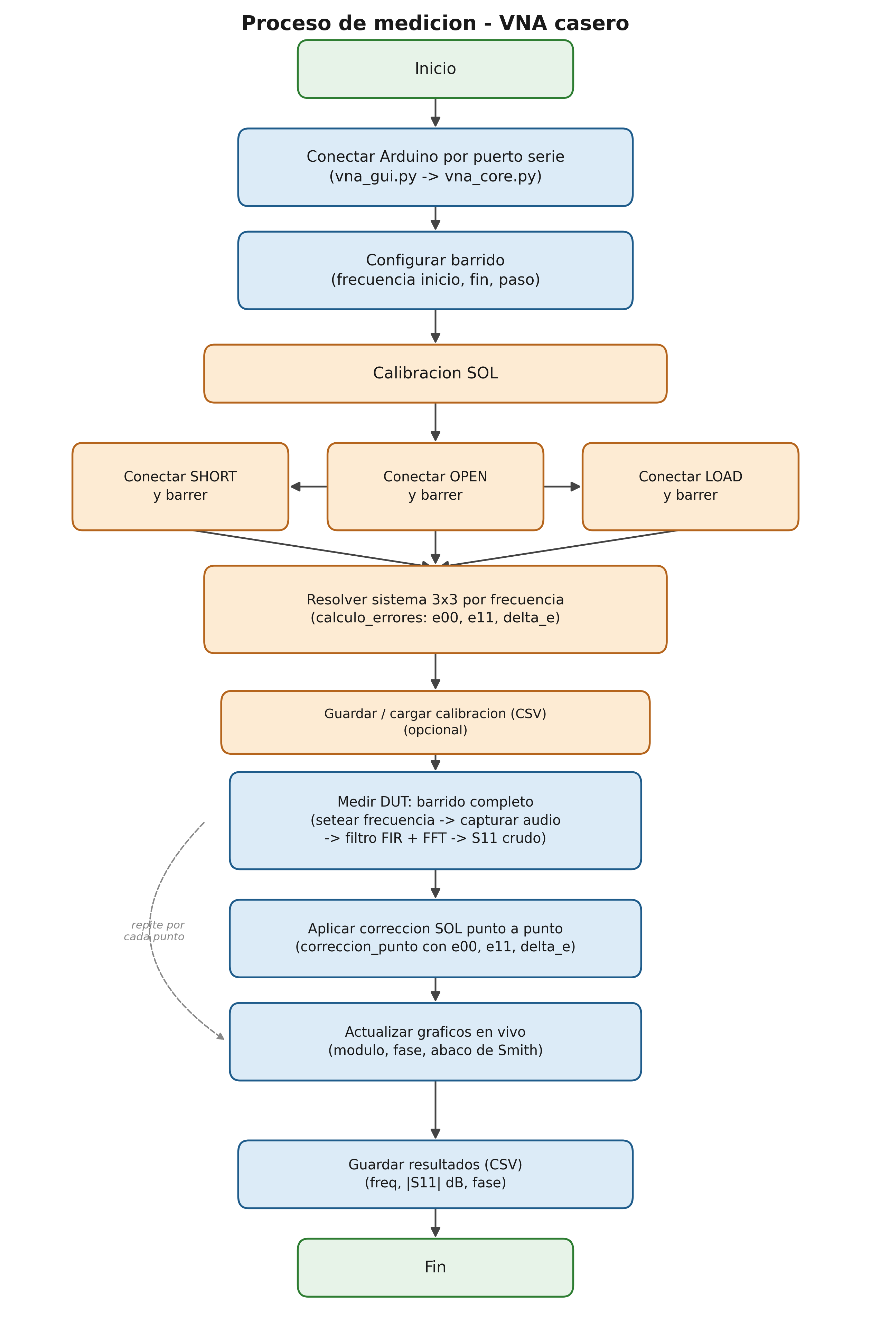
Tesis/Imagenes/d_flujo_interfaz.png
