VictoriacTorres/euVNA/Tesis/Imagenes/fotoplacafinal.jpg

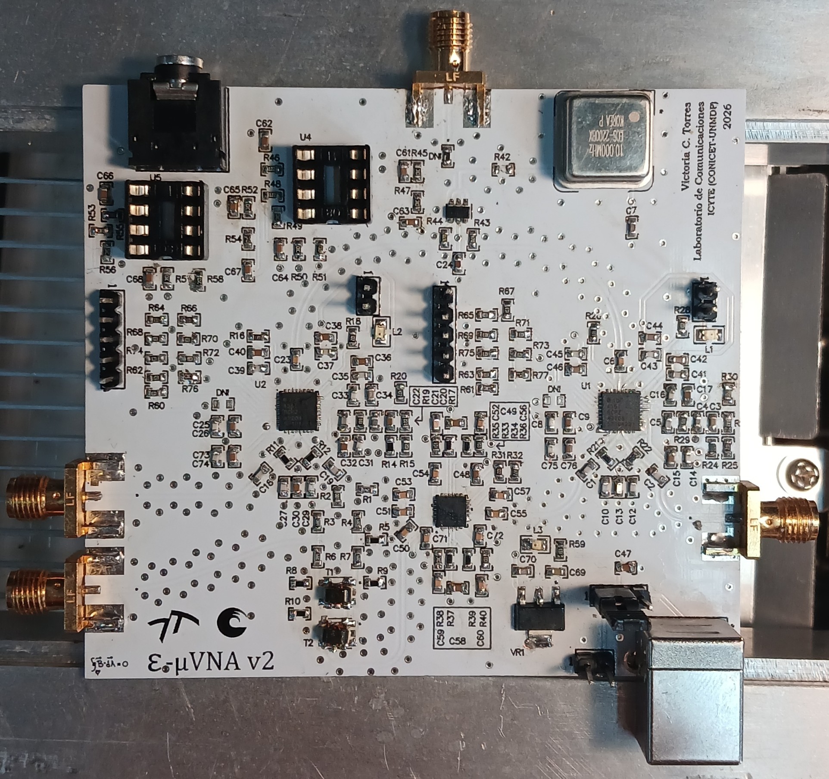
Tesis/Imagenes/fotoplacafinal.jpg
