VictoriacTorres/euVNA/Tesis/Imagenes/medcableabierto.png

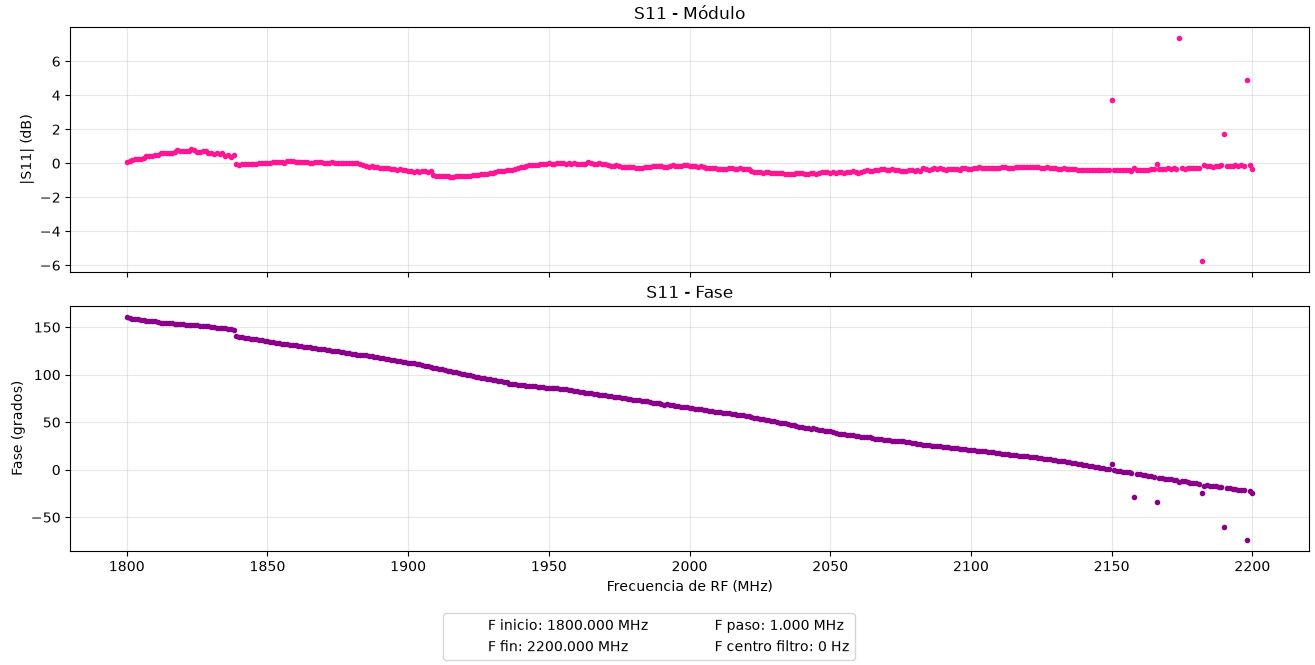
Tesis/Imagenes/medcableabierto.png
