VictoriacTorres/euVNA/Tesis/Capitulos/Resultados.tex

\section{Ensamblado de la placa final}
    Al terminar el diseño del PCB, se consultaron con proveedores nacionales para la impresión de la placa. Ante la falta de respuesta de uno, y la imposibilidad de fabricar en otro (se consultó pero no trabajaba con las especificaciones que requeríamos) se optó por un proveedor internacional, PCBWay \cite{pcbway}. Todo el proceso, desde el envío de los archivos gerber, revisión y cambios, hasta recibir el paquete, llevó aproximadamente 15 días. Las placas recibidas son las que muestra la figura \ref{fig:placassolas}. Dado el bajo costo de la placa de 2 capas y la flexibilidad que brinda debido al acceso a todas las pistas, se optó por fabricar ambas versiones.

\begin{figure}
    \centering
    
    \caption{Placas sin soldar}
    \label{fig:placassolas}
\end{figure}

    Los componentes se soldaron a mano, siendo los primeros  los tipo QFN (encapsulados planos cuádruples sin terminales - \textit{Quad Flat No-Lead}). Se puede observar en la figura \ref{fig:qfn} que para hacerlo se utilizó una estación de precalentamiento y un soldador de aire.
    
    Luego se soldaron el resto de componentes, en orden de menor a mayor altura, empezando por los tipo SMD. La figura \ref{fig:bancosoladado} exhibe el banco de soldado. La placa final se muestra en la figura \ref{fig:fotoplacafinal}. Es interesante destacar que debido al plano de masa continuo en la segunda capa, la placa posee muy buenos niveles de disipación, lo que dificultó considerablemente el proceso de soldado. Este inconveniente se resolvió mediante la combinación del uso de precalentadora, pistola de aire, soldador de lápiz y generosas cantidades de flux, como ilustra la figura \ref{fig:soldando}.

\begin{figure}
    \centering
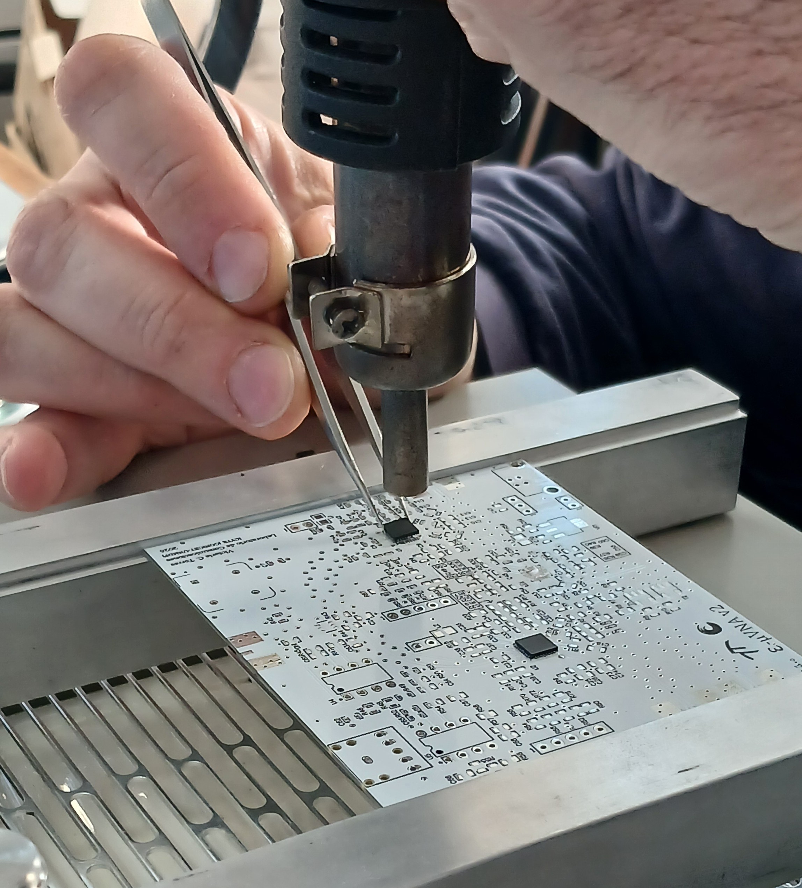
[picture p129: Tesis/Imagenes/soldadoqfn.jpg]
    
    \caption{Soldado de componentes QFN}
    \label{fig:qfn}
\end{figure}

\begin{figure}
    \centering
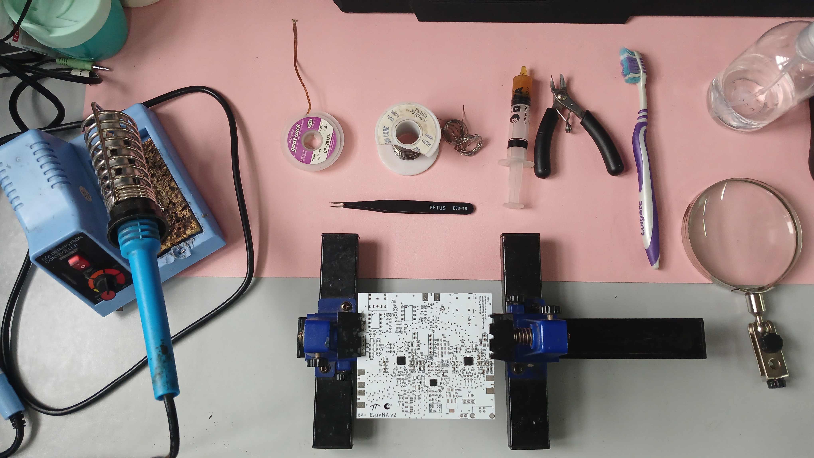
[picture p130: Tesis/Imagenes/bancosoldado2.jpg]
    
    \caption{Banco de soldado}
    \label{fig:bancosoladado}
\end{figure}

\begin{figure}[htbp]
    \centering
    \begin{minipage}[b]{0.48\textwidth}
        \centering
        
        \caption{Proceso de soldado.}
        \label{fig:soldando}
    \end{minipage}
    \hfill
    \begin{minipage}[b]{0.48\textwidth}
        \centering
        
        \caption{$\epsilon\text{-}\mu\text{VNA}$ v2 final.}
        \label{fig:fotoplacafinal}
    \end{minipage}
\end{figure}

\section{Ficha técnica}
\begin{center}
\begin{tabularx}{\textwidth}{|X|c|X|}
\arrayrulecolor{Thistle}
\hline
\rowcolor{Thistle!20} 
\textbf{Parámetro}  & \textbf{Valor} & \textbf{Comentarios}  \\
\hline
Rango de frecuencia de trabajo & 1,8 a 2,2 GHz & Ampliable por software\\
\hline
Resolución en frecuencia & 250 Hz & Según la hoja de datos del ADF4351, la mínima con este hardware puede llegar hasta 31,25 Hz.\\
\hline
Impedancia característica & $50 \Omega$ & -\\
\hline
Directividad del acoplador resistivo & >36,5 dB & Para el rango de frecuencia de trabajo \\
\hline
Voltaje de alimentación & 5V & Vía USB-B o fuente externa\\
\hline
Corriente de alimentación & 350 mA & - \\
\hline
Frecuencia de muestreo & 44,1 kHz & Configurable por software \\
\hline
Resolución del ADC (placa de sonido) & 16 bits & Entrada Line-In de la PC \\
\hline
Baud rate (microcontrolador) & 115200 baudios & Configurable \\ 
\hline

\end{tabularx}
\end{center}

\section{Pruebas de integración}
Para verificar el correcto funcionamiento de la placa, la primera prueba unitaria realizada fue medir la entrada y salida del regulador de tensión. Se verificó que hubieran 5 V y 3,3 V respectivamente.

Se midió la frecuencia del cristal con un frecuencímetro Optoelectronics Handi-Counter 2810 \cite{optoelectronics_2810_manual}, alimentando el oscilador con fuente de alimentación regulable Kenwood PA36-3A \cite{kenwood_pa36_3a}. Como evidencia la figura \ref{fig:med_cristal}, el cristal es de 10 MHz.
\begin{figure}
    \centering
    
    \caption{Banco de medición de la frecuencia del oscilador a cristal.}
    \label{fig:med_cristal}
\end{figure}

Luego se programó la generación de una única señal para cada generador de RF y así comprobar el enganche y el nivel de potencia de salida. Para esta medición se utilizaron las salidas auxiliares con conectores SMA. El banco de medición (véase la figura \ref{fig:bancomed_1frec}) consistió en la fuente regulable para alimentar la placa, una PC para programar el Arduino, un analizador de espectros Rigol RSA3030N \cite{rigol_rsa3030n}, y un atenuador HP 8496B \cite{hp8496b_manual}, que se utilizó para proteger la entrada del analizador.

\begin{figure}
    \centering
    
    \caption{Banco de medición para generación de una única frecuencia.}
    \label{fig:bancomed_1frec}
\end{figure}

Con el mismo banco de medición, pero ajustando el firmware se generaron varios barridos de diferente frecuencia inicial, final y paso para verificar el enganche en toda la banda de interés, para ambos ADF4351.

Luego de comprobar con éxito el funcionamiento de estos subsistemas, se soldó la etapa de FI para avanzar hacia la adquisición. Para probar la placa de sonido, se generaron dos frecuencias separadas en 1, 5 y 10 kHz. Se adquirieron con el software Audacity \cite{audacity376} en modo estéreo, como muestran las figuras \ref{fig:audacity}. Se eligió como FI de trabajo 10 kHz (figura \ref{fig:audacity} \subref{fig:grab10k}) porque una mayor FI reduce el ruido de fase y está alejada de las zonas de ruido de baja frecuencia (ruido de red y 1/f), pero la frecuencia de corte de los pasa bajos a la salida del mezclador, que es 16 kHz aproximadamente, limitan la frecuencia máxima que se puede elegir. 

\begin{figure}[H]
    \centering
    \begin{subfigure}[b]{\textwidth}
        \centering
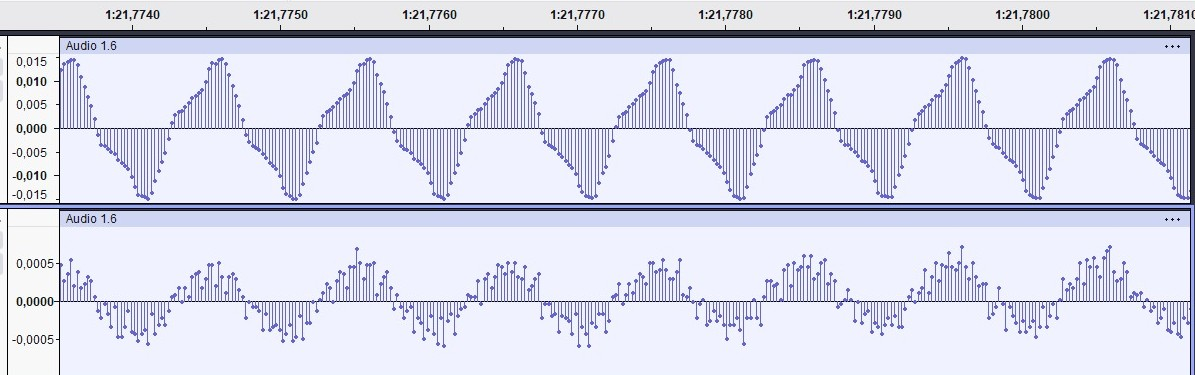
[picture p131: Tesis/Imagenes/grabación 1 k.jpg]
        
        \caption{Grabación con FI = 1 kHz.}
        \label{fig:grab1k}
    \end{subfigure}

    \vspace{1em}   % espacio entre subfiguras (opcional)

    \begin{subfigure}[b]{\textwidth}
        \centering
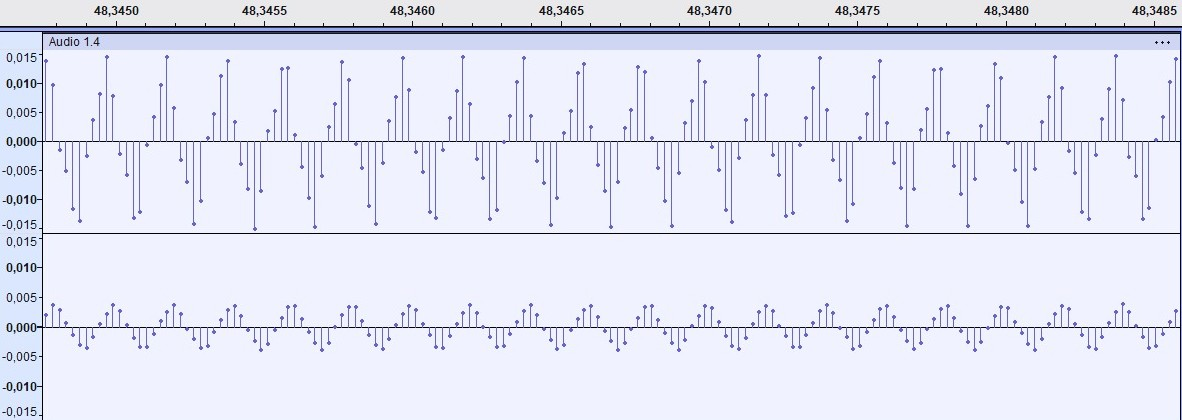
[picture p132: Tesis/Imagenes/Grabación 5k.jpg]
        
        \caption{Grabación con FI = 5 kHz.}
        \label{fig:grab5k}
    \end{subfigure}

    \begin{subfigure}[b]{\textwidth}
        \centering
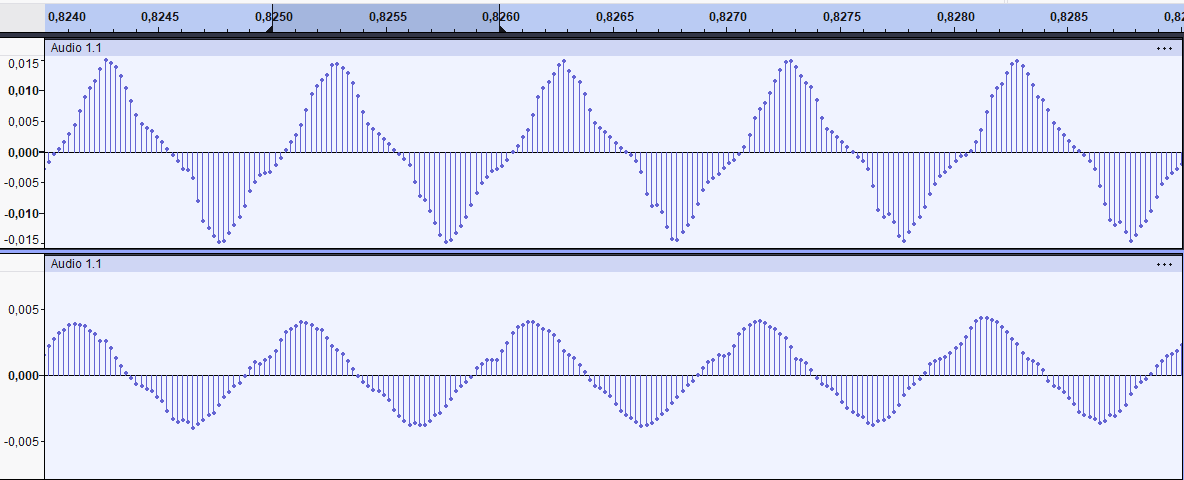
[picture p133: Tesis/Imagenes/grabación 10k.png]
        
        \caption{Grabación con FI = 10 kHz.}
        \label{fig:grab10k}
    \end{subfigure}

    \caption{Grabaciones de prueba en Audacity.}
    \label{fig:audacity}
\end{figure}

El mismo software tiene una herramienta para graficar el espectro de la señal, en el que se pudo comprobar la frecuencia de mayor amplitud y comprobar que el tercer armónico queda aproximadamente 13 dB por debajo del primero, como indica la hoja de datos de los ADF4351 y se evidencia en la figura \ref{fig:espectro1k}.

\begin{figure}
    \centering
    
    \caption{Espectro de la señal de referencia en una grabación con FI = 1 kHz.}
    \label{fig:espectro1k}
\end{figure}

Se procedió a probar la parte del software que aplica el algoritmo de barrido y extracción del S11 sin calibrar, haciendo solo la comparación de la señal de referencia con la medida en magnitud y fase para estimar el S11 tal como se describe en la sección \ref{sec:estS11}. Las figuras \ref{fig:precalibracion} muestran la medición de una carga de 50 $\Omega$ y un cortocircuito. 

\begin{figure}[htbp]
    \centering
    \begin{subfigure}{\linewidth}
        \centering
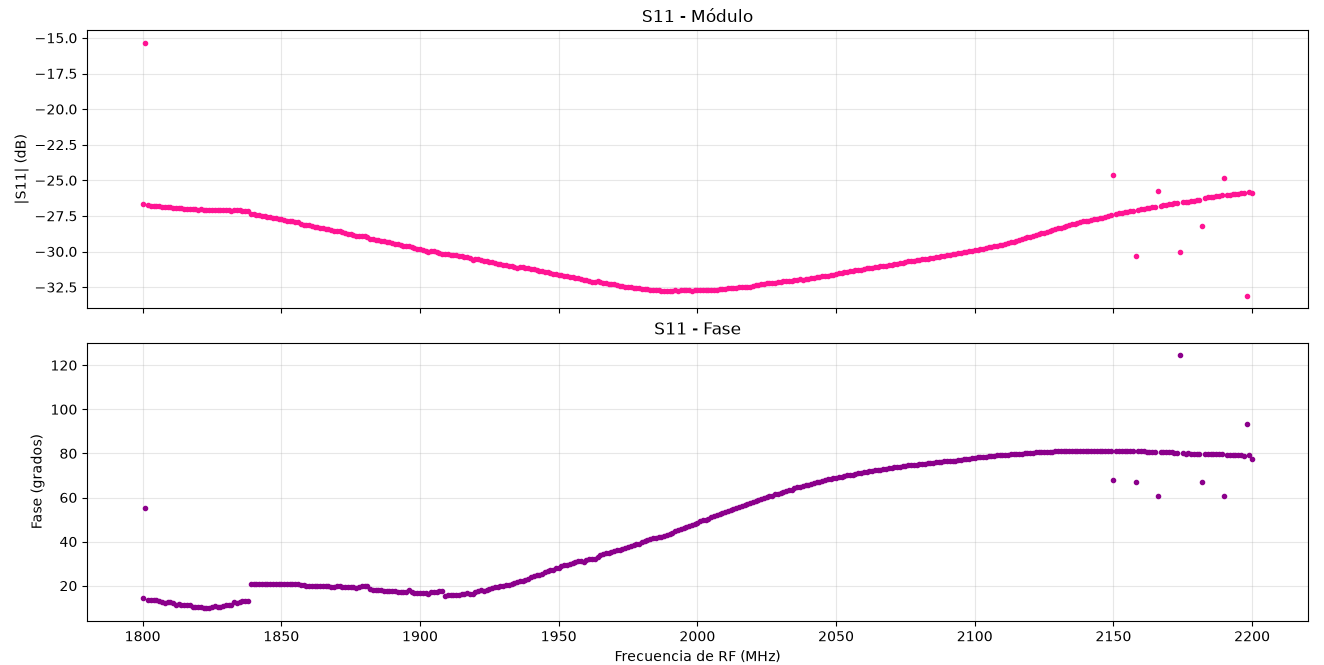
[picture p134: Tesis/Imagenes/carga 50 sin calibrar.png]
        
        \caption{Medición de carga adaptada.}
        \label{fig:50precalib}
    \end{subfigure}
    \caption{Mediciones pre calibración.}
    \label{fig:precalibracion}
\end{figure}

\begin{figure}[htbp]
    \ContinuedFloat
    \centering
    \begin{subfigure}{\linewidth}
        \centering
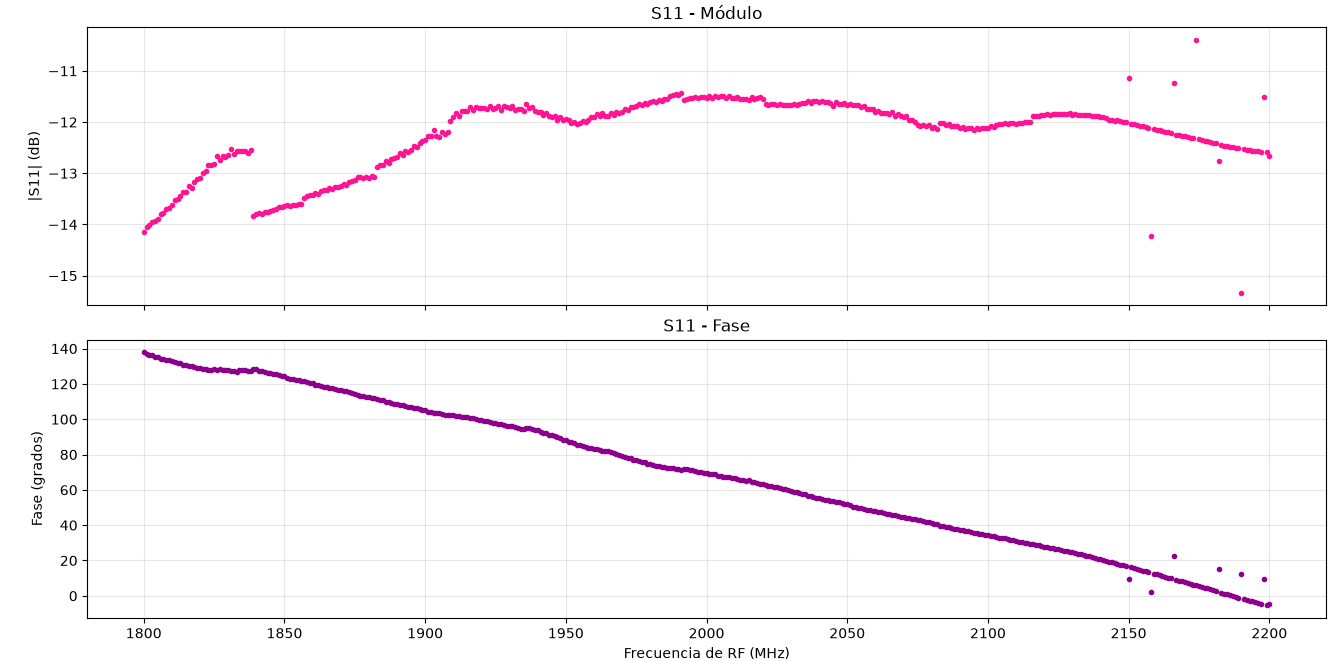
[picture p135: Tesis/Imagenes/cortoprecalib.png]
        
        \caption{Medición de cortocircuito.}
        \label{fig:cortoprecalib}
    \end{subfigure}
    \caption{Mediciones pre calibración (continuación).}
\end{figure}

Se puede observar que aunque las mediciones tienen coherencia en cuanto a la forma (exceptuando algunas regiones, de las cuales se hablará luego), los valores de amplitud y fase medidos no son los correctos. Esto se debe a los errores que se mencionaron en la sección \ref{sec:errores}, que se compensan mediante la calibración. 

\section{Mediciones de sistemas bajo prueba}

Se probó el software completo, incluyendo la calibración SOL, para varios DUT:

\subsection{Cortocircuitos}
Se midieron dos cortocircuitos. El de la figura \ref{fig:medcortocal} corresponde a una de las cargas de calibración, por lo que debería no tener ningún error que sea sistemático. Que la fase haga un salto de -180° a +180° se debe a pequeños errores de ruido en la medición, pero en la práctica no hay diferencia entre ambos valores, porque representan el mismo punto en el plano complejo. 
\begin{figure}
    \centering
    
    \caption{Medición de cortocircuito de calibración.}
    \label{fig:medcortocal}
\end{figure}

El otro cortocircuito que se usó para medir consiste en un conector SMA con su contacto central y exterior soldados mediante un pequeño tramo de alambre. Dado que la soldadura se realiza en el exterior del conector, existe un pequeño tramo de línea de transmisión entre el cortocircuito efectivo y el punto donde se soldó el cortocircuito de calibración. Para una frecuencia promedio de 2 GHz, este tramo de línea incorpora un desfasaje de aproximadamente 15 grados, por lo que la señal reflejada se mide efectivamente 30 grados retrasada (respecto a la incidente) en comparación con el cortocircuito ideal. Esto se evidencia en un desfasaje medido de 150° tanto con el $\epsilon-\mu VNA$ tanto como con dispositivos comerciales. 

\begin{figure}
    \centering
    
    \caption{Medición de cortocircuito de 150°.}
    \label{fig:medcorto150}
\end{figure}

\subsection{Circuito abierto}
El circuito abierto de la figura \ref{fig:medCA} se implementó dejando simplemente sin conectar la entrada del DUT. Como se observa, la medición se corresponde con la esperable para un circuito abierto teórico (un coeficiente de reflexión de 1). Se ven algunos puntos atípicos ocasionados por errores semi-sistemáticos que se detallan en la sección de análisis. Aún así, no afectan la exactitud de la medición en los puntos adyacentes.

\begin{figure}
    \centering
    
    \caption{Medición de circuito abierto.}
    \label{fig:medCA}
\end{figure}

\subsection{Carga resistiva (68 $\Omega$)}
Se midió una carga resistiva de 68 $\Omega$, cuyo resultado se observa en la figura \ref{fig:med68}. Que el VNA pueda diferenciar esta carga de una de 50 $\Omega$ da cuenta de que la ROE mínima distinguible que posee es al menos 1,36.

\begin{figure}
    \centering
    
    \caption{Medición de carga de 68 $\Omega$.}
    \label{fig:med68}
\end{figure}

\subsection{Adaptación (50 $\Omega$)}

Una medición con una carga de 50 $\Omega$ equivale al puerto adaptado, por lo que la reflexión debería ser nula. Esto en escala logarítmica equivale a un módulo de - $\infty$ dB y una fase caracterizada por ruido. En la práctica, la magnitud reflejada medida corresponde a la sensibilidad del dispositivo, entre -30 y -35 dB (menor en módulo a 0,03 veces) lo cuál se corresponde con la directividad esperable del dispositivo, según lo visto en simulaciones.

\begin{figure}
    \centering
    
    \caption{Medición de 50 $\Omega$.}
    \label{fig:med50R}
\end{figure}

\subsection{Medición de banda ancha}
Se realizó una calibración y medición de un circuito abierto en un rango más ancho, de 500 MHz a 3 GHz, de pasos de a 10 MHz para verificar el correcto comportamiento del sistema. Como se observa en la figura \ref{fig:bandaancha}, esta medición dio valores esperados con pocos valores anómalos.

\begin{figure}
    \centering
    
    \caption{Medición de banda ancha.}
    \label{fig:bandaancha}
\end{figure}

\section{Análisis de resultados}
La siguiente tabla muestra una comparación entre los coeficientes de reflexión teóricos o "reales" y el promedio (aproximado) de los medidos, en módulo [dB] y ángulo [°]:
\begin{table}[htbp]
    \centering
    \arrayrulecolor{Thistle}
    \begin{tabularx}{\textwidth}{|X|c|X|X|}
        \hline
        \rowcolor{Thistle!20} 
        Carga & \textbf{$S11_{REAL}$} & \textbf{$S11_{MEDIDO}$} & Error máximo (excluyendo puntos anómalos)\\
        \hline
        50 $\Omega$ & -$\infty$ & -32,7 dB $\angle$ 70° & -\\
        \hline
        68 $\Omega$ & -16,33 dB $\angle$ 0° & -15,8 dB $\angle$ 6° & 0,9 dB, 8,8° \\
        \hline
        Corto circuto & 0 dB $\angle$ 180° & 0 dB $\angle$ 180° & 0,13 dB, 0,96°\\
        \hline
        Circuito abierto & 0 dB $\angle$ 0° & 0 dB $\angle$ 0° & 0,24 dB, 1,35° \\
        \hline
        Cortocircuito desfasado & 0 dB $\angle$ 150° & 0 dB $\angle$ 150° & 0,59 dB, 6°\\
        \hline
    \end{tabularx}
    \caption*{Tabla de comparación de coeficientes teóricos y medidos}
\end{table}

Que el dispositivo pueda medir una carga de 50 $\Omega$ con al menos -30 dB de magnitud, da cuenta de que puede diferenciar una ROE de al menos 1,06  superando el requerimiento RP-05 (ver apéndice   ``Especificación de Requerimientos'' - \cite{ER}) que exigía una ROE mínima distinguible de 1,5.

Sobre los puntos en la región de 2150 a 2200 MHz y en la región cercana a 1850 MHz que no siguen la misma tendencia que el resto, se puede notar que ocurren siempre en las mismas frecuencias. Aunque aún no se hicieron mediciones para comprobarlo, lo más probable es que el filtro FIR tenga un ancho de banda muy angosto para las mediciones en alta frecuencia. A veces el enganche de los ADF4351 no ocurre exactamente en la frecuencia deseada sino en una cercana, lo que provoca que la mezcla no caiga en la frecuencia de FI y por lo tanto el pico de máxima amplitud caiga fuera de la banda de paso. Esta teoría se basa en mediciones anteriores donde agrandando el ancho de banda ha disminuido la cantidad de puntos anómalos.

\subsection{Sensor resonante}
Finalmente, para verificar que el sistema está adaptado para operar en conjunto con un sensor de glucemia no invasivo, se utiliza el sensor que resuena alrededor de los 2 GHz. Se mide en principio en vacío, como muestra la figura \ref{fig:sensorvacio}.  

\begin{figure}
    \centering
    
    \caption{Medición del sensor de glucemia en vacío.}
    \label{fig:sensorvacio}
\end{figure}

Si se introduce en el sensor un dedo, se espera que se mueva la frecuencia de resonancia por lo explicado en el capítulo 1. Este comportamiento es confirmado en la figura \ref{fig:sensorlleno}, donde se observa un desplazamiento de la frecuencia de mínima reflexión (resonancia) de 2150 MHz a 1990 MHz acompañado de un incremento del factor de calidad. Estos resultados permiten el estudio no invasivo de la glucemia del usuario a partir del monitoreo de nuevos desplazamientos.

\begin{figure}
    \centering
    
    \caption{Medición del sensor de glucemia con un dedo.}
    \label{fig:sensorlleno}
\end{figure}

\section{Interfaz de usuario}

Al incluir la interfaz de usuario, se hicieron algunas mediciones para comprobar su funcionamiento, como 50 y 68 $\Omega$ y el cable terminado en circuito abierto, que se pueden ver en las figuras \ref{fig:medinterfaz}. Es relevante aclarar que la medición \ref{fig:interfaz50} fue hecha desde 1 hasta 2,8 GHz. La interfaz agregó el gráfico en un ábaco de Smith que permite la visualización simultánea del parámetro S11 medido y la impedancia de entrada al DUT.

\begin{figure}[H]
    \centering
    \begin{subfigure}[t]{0.8\textwidth}
        \centering
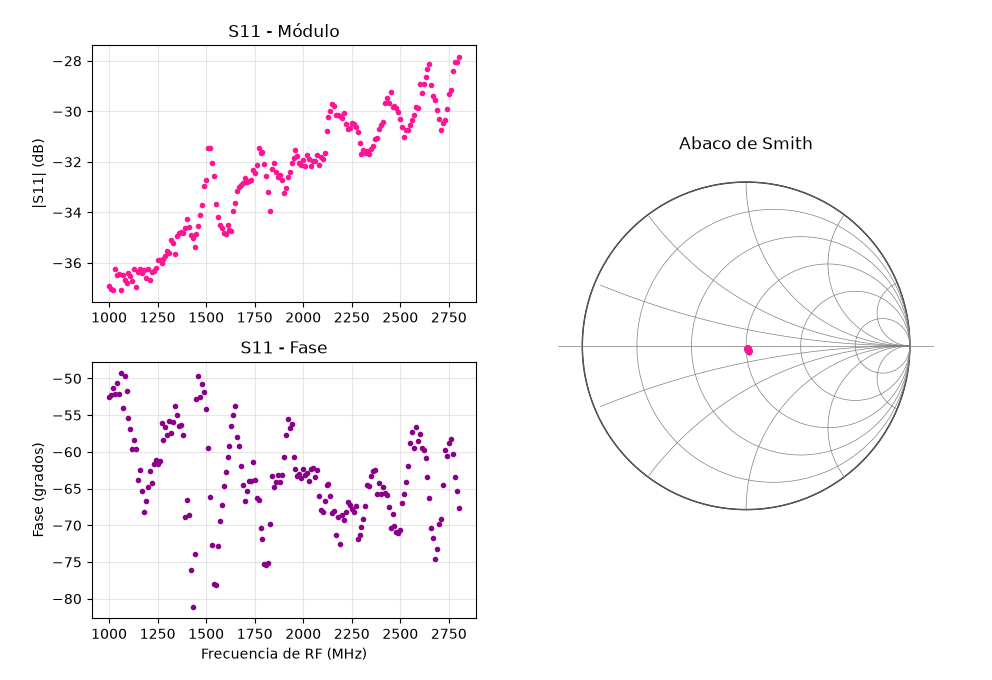
[picture p136: Tesis/Imagenes/50R_1000a2800_8oct.png]
        
        \caption{50 $\Omega$}
        \label{fig:interfaz50}
    \end{subfigure}
    \begin{subfigure}[t]{0.8\textwidth}
        \centering
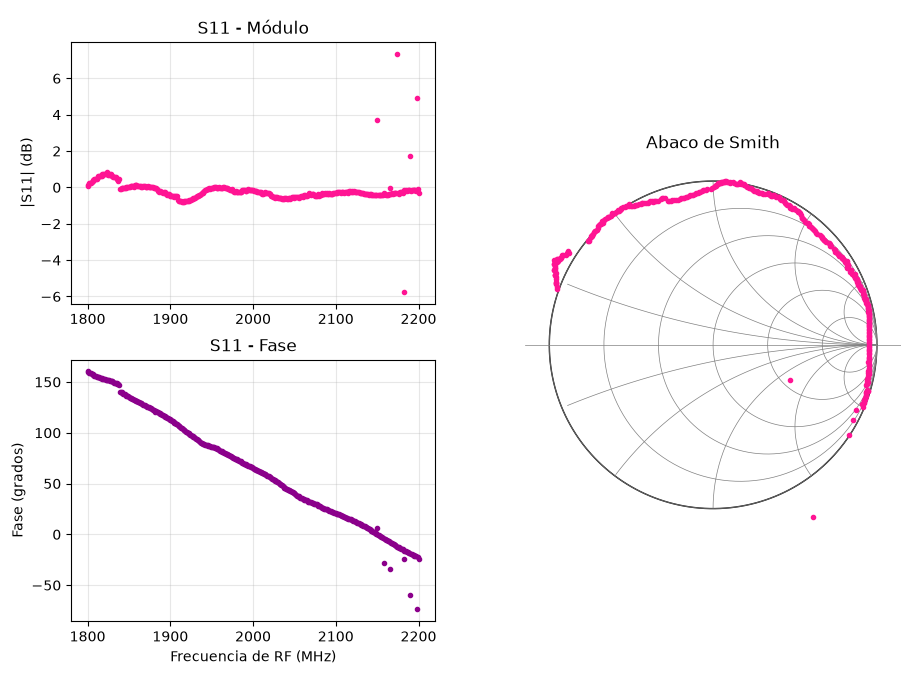
[picture p137: Tesis/Imagenes/interfaz_cableabierto.png]
        
        \caption{Cable terminado en circuito abierto}
        \label{fig:interfazcable}
    \end{subfigure}
    \caption{Mediciones realizadas desde la interfaz de usuario}
    \label{fig:medinterfaz}
\end{figure}
\clearpage

\section{Comparación con dispositivo comercial}

Para finalizar, se midieron algunas cargas con el Analizador Vectorial de Redes incorporado en el analizador de espectros Rigol Series RSA3000 \cite{rigol_rsa3030n}, las cuales se pueden observar en las figuras \ref{fig:comparaciones1} y \ref{fig:comparaciones2}. Es importante aclarar que ambas mediciones se hicieron con el mismo kit de calibración para descartar errores en la comparación entre ambas técnicas. En el caso de la medición de 50 $\Omega$ se puede observar que la realizada con el $\epsilon-\mu VNA$ sería "mejor". Esto se puede deber a la velocidad con la que se realizó el barrido en el dispositivo comercial, ya que logra una medición más rápida en detrimento de la sensibilidad. El mismo fenómeno se puede observar en la figura de la medición del sensor vacío (es decir, sin un dedo) \ref{fig:comparacionsensor}, donde las curvas de magnitud no están totalmente superpuestas. Se desestima la teoría de que son mediciones incorrectas porque si se hubiesen confundido las cargas de calibración, las fases no coincidirían.

\begin{figure}
    \centering
     \begin{subfigure}[b]{\textwidth}
        
        \caption{Sensor vacío}
        \label{fig:comparacionsensor}
    \end{subfigure}
    \hfill
    \begin{subfigure}[b]{\textwidth}
        \centering
        
        \caption{Circuito abierto}
        \label{fig:comparacionCA}
    \end{subfigure}
    \caption{Comparaciones $\epsilon-\mu$ VNA (rosa) vs dispositivo comercial (azul)}
    \label{fig:comparaciones1}    
\end{figure}

\begin{figure}[H]
    \centering
    \begin{subfigure}[b]{\textwidth}
        \centering
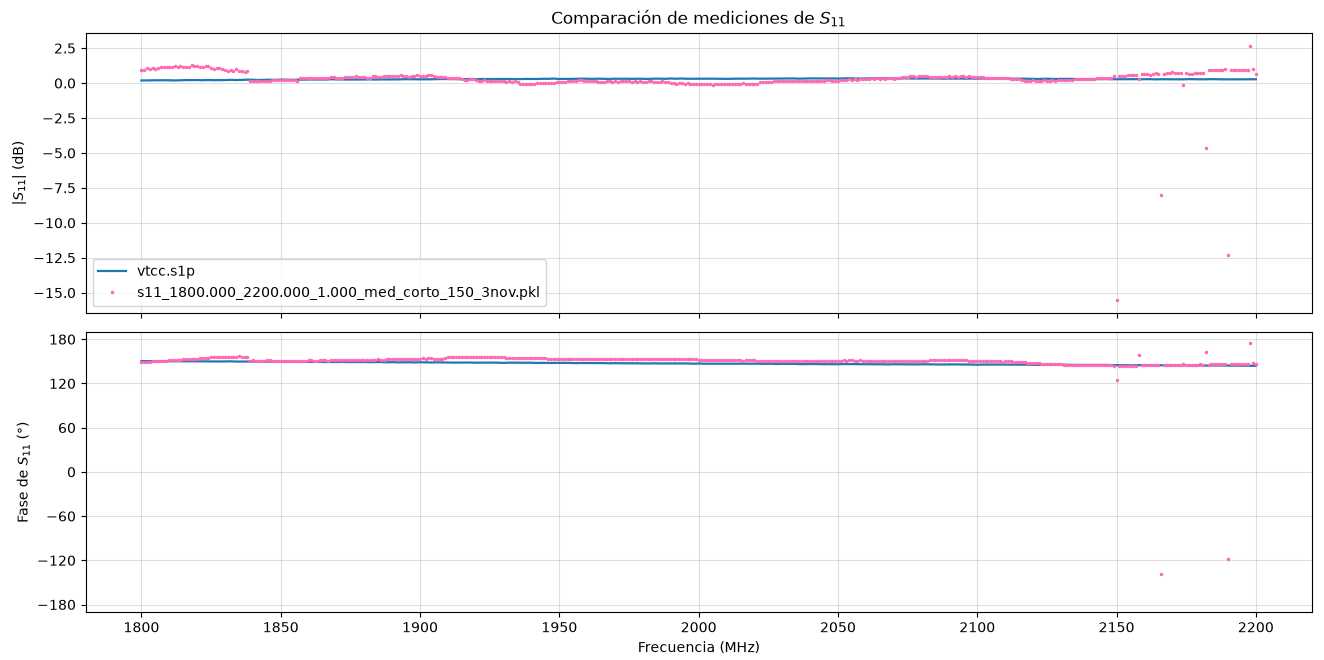
[picture p138: Tesis/Imagenes/comparacion corto 150.png]
        
        \caption{Cortocircuito desfasado}
        \label{fig:compcorto}
    \end{subfigure}
    \hfill
    \begin{subfigure}[b]{\textwidth}
        \centering
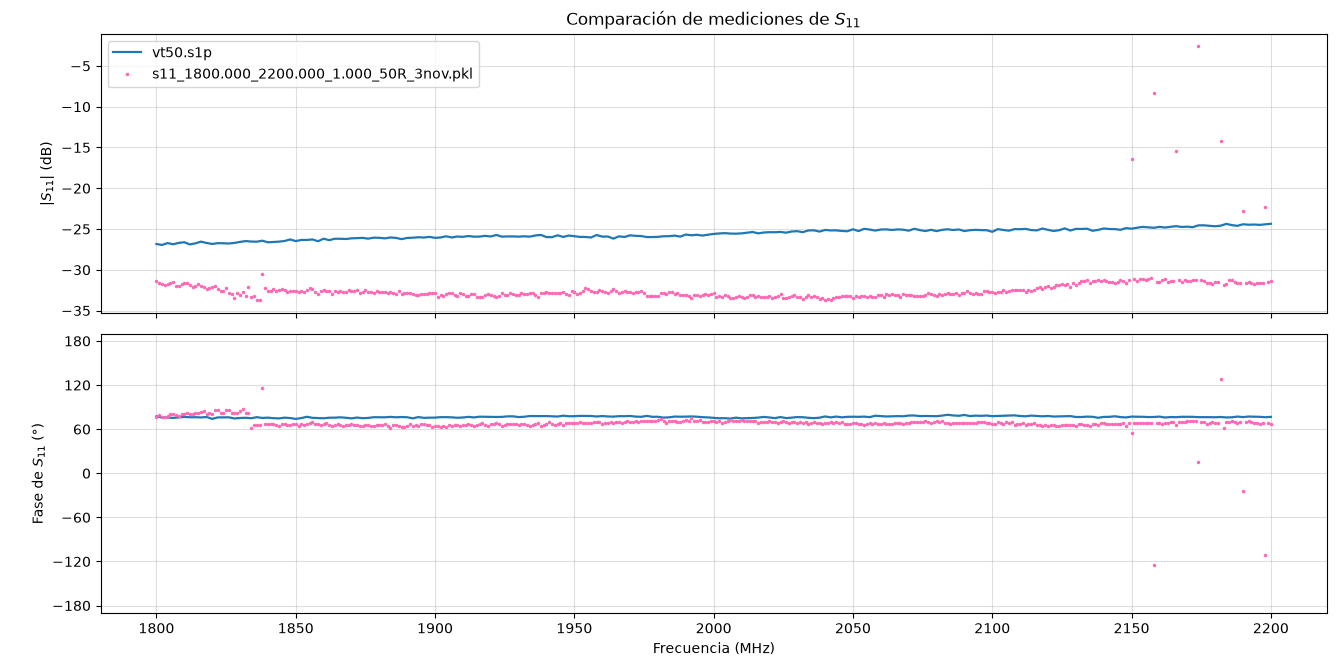
[picture p139: Tesis/Imagenes/comparacion 50.png]
        
        \caption{50 $\Omega$}
        \label{fig:comp50}
    \end{subfigure}

    \caption{Comparaciones $\epsilon-\mu$ VNA (rosa) vs dispositivo comercial (azul)}
    \label{fig:comparaciones2}
\end{figure}
