VictoriacTorres/euVNA/SW_euVNA FINAL/calibracion_1000a2800dea10_8oct.csv

freq_MHz | e_00_real | e_00_imag | e_11_real | e_11_imag | delta_e_real | delta_e_imag
1000.000000 | 3.7846517897e-02 | -2.9069298972e-02 | -9.5095599540e-01 | -6.0035086186e-01 | -2.1853040667e-01 | -5.3008261808e-01
1010.000000 | 3.6366597277e-02 | -2.8810704261e-02 | -2.4729943050e-01 | 1.0358148170e+00 | -3.9621515591e-01 | -1.0915744929e-01
1020.000000 | 3.5157019852e-02 | -2.8431651827e-02 | 9.5883575725e-03 | -3.3215341648e-02 | -1.1083797894e-01 | -2.5027363152e-01
1030.000000 | 3.3908767318e-02 | -2.8553150898e-02 | 1.0990663442e-02 | -3.2599559925e-02 | -9.2539059197e-02 | -2.5714961422e-01
1040.000000 | 3.2473195278e-02 | -2.8490086346e-02 | -5.2190406770e-02 | -7.9273465091e-02 | -8.4889040776e-02 | -2.4311991833e-01
1050.000000 | 3.1056027062e-02 | -2.8406688208e-02 | 1.1392046283e-02 | -3.2588478815e-02 | -5.2987415496e-02 | -2.6717426041e-01
1060.000000 | 2.9831988008e-02 | -2.8398858439e-02 | -3.6633324731e+00 | 7.2783334811e-01 | 1.6762090856e-01 | 8.1601714886e-01
1070.000000 | 2.8302277220e-02 | -2.8684451978e-02 | 1.4180256589e-02 | -3.0420170383e-02 | -1.2299677668e-02 | -2.7045581748e-01
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
