VictoriacTorres/euVNA/Codigos/Yo/calibracion_1800.0_2200.0_1.0.csv

freq_MHz | e_00_real | e_00_imag | e_11_real | e_11_imag | delta_e_real | delta_e_imag
1800.000000 | 4.8791013726e-02 | 3.8541317949e-02 | -6.5951339123e-02 | 1.0736380895e-01 | -1.8664037262e-01 | -1.1960182109e-01
1801.000000 | 4.7147199251e-02 | 3.9636472363e-02 | -6.2527903294e-02 | 9.6075448539e-02 | -1.8423531024e-01 | -1.2068090411e-01
1802.000000 | 4.6726019218e-02 | 4.0391840657e-02 | -5.7438874614e-02 | 1.0792907199e-01 | -1.8087171344e-01 | -1.1881210430e-01
1804.000000 | 4.7239683433e-02 | 3.8260583213e-02 | -5.5861453648e-02 | 1.2284815975e-01 | -1.7603900090e-01 | -1.2008685844e-01
1805.000000 | 3.9701166538e-02 | 4.4644678177e-02 | -1.0847359153e-02 | 7.1644539222e-02 | -1.7306632919e-01 | -1.2502524311e-01
1806.000000 | 4.5908675604e-02 | 4.2217061778e-02 | -6.4723907820e-02 | 1.1129519011e-01 | -1.7495760235e-01 | -1.2401992361e-01
1807.000000 | 4.9860210158e-02 | 4.1213034314e-02 | -6.9427397841e-02 | 1.2839310507e-01 | -1.7241687260e-01 | -1.2748679889e-01
1808.000000 | 5.7463999717e-01 | 2.7383690676e-02 | 5.3663143436e-01 | 7.6028294983e-01 | 3.4606504600e-01 | 8.5044257392e-02
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
