VictoriacTorres/euVNA/Codigos/Yo/Archivos csv resultados-calibracion/calibracion_1800.0_2200.0_1.0 - signo corregido.xlsx

freq_MHz | e_00_real | e_00_imag | e_11_real | e_11_imag | delta_e_real | delta_e_imag
1800 | 0.04879101373 | -0.03854131795 | -0.06595133912 | -0.107363809 | -0.1866403726 | 0.1196018211
1801 | 0.04714719925 | -0.03963647236 | -0.06252790329 | -0.09607544854 | -0.1842353102 | 0.1206809041
1802 | 0.04672601922 | -0.04039184066 | -0.05743887461 | -0.107929072 | -0.1808717134 | 0.1188121043
1804 | 0.04723968343 | -0.03826058321 | -0.05586145365 | -0.1228481598 | -0.1760390009 | 0.1200868584
1805 | 0.03970116654 | -0.04464467818 | -0.01084735915 | -0.07164453922 | -0.1730663292 | 0.1250252431
1806 | 0.0459086756 | -0.04221706178 | -0.06472390782 | -0.1112951901 | -0.1749576023 | 0.1240199236
1807 | 0.04986021016 | -0.04121303431 | -0.06942739784 | -0.1283931051 | -0.1724168726 | 0.1274867989
1808 | 0.5746399972 | -0.02738369068 | 0.5366314344 | -0.7602829498 | 0.346065046 | -0.08504425739
1809 | 0.449307344 | 1.531554903 | -6.159469735 | -1.494051209 | -3.601105114 | -2.684150262
1810 | 0.0496238873 | -0.04084379397 | -0.05113788014 | -0.1116896467 | -0.1724416263 | 0.1327083474
1811 | 0.04939335126 | -0.04385729763 | -0.06033605645 | -0.1020990372 | -0.1711591475 | 0.1336386315
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
