VictoriacTorres/euVNA/Codigos/Yo/Archivos csv resultados-calibracion/50R_1700a2300_1M_calibrado.csv

freq_rf_MHz | modulo_S11_dB | fase_S11_deg
1703.000000 | -35.8394 | 3.2470
1704.000000 | -37.8763 | 67.9991
1705.000000 | -37.6017 | 71.3830
1706.000000 | -34.6638 | 111.5380
1707.000000 | -33.0548 | 101.2668
1708.000000 | -36.2591 | 116.9270
1709.000000 | -33.1710 | 107.9672
1710.000000 | -32.9763 | 126.9743
1711.000000 | 16.5101 | -17.3424
1712.000000 | 13.6029 | -63.3957
1713.000000 | 16.0300 | -56.5179
1714.000000 | -35.3207 | 117.9617
1715.000000 | -34.1869 | 120.7954
1716.000000 | -33.7997 | 128.2616
1717.000000 | -35.8755 | 130.9249
1718.000000 | -34.6177 | 127.9325
1719.000000 | -36.7695 | 132.2244
1720.000000 | -33.4135 | 137.1495
1721.000000 | -32.8433 | 118.2057
1722.000000 | -33.1881 | 125.4209
1723.000000 | -33.5629 | 109.9974
1724.000000 | -35.5589 | 136.3356
1725.000000 | -34.6144 | 133.2883
1726.000000 | -34.7188 | 122.4614
1727.000000 | -32.7665 | 117.3289
1728.000000 | -34.8936 | 130.9730
1729.000000 | -38.5369 | 122.1090
1733.000000 | -31.9388 | 156.0894
1737.000000 | -1.5792 | -103.2540
1738.000000 | -25.9477 | 103.0941
1739.000000 | -37.3162 | 112.4792
1740.000000 | -38.6666 | 139.1138
1741.000000 | -36.4605 | 118.6085
1742.000000 | -33.1767 | 110.8260
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
