VictoriacTorres/euVNA/Codigos/Yo/Archivos csv resultados-calibracion/S11_sincalibracion_50_2_2nov.csv

freq_rf_MHz | modulo_S11_dB | fase_S11_deg
1800.000000 | -26.6645 | 14.6068
1801.000000 | -15.3546 | 55.4483
1802.000000 | -26.7362 | 13.6399
1803.000000 | -26.7841 | 13.4437
1804.000000 | -26.7894 | 13.5412
1805.000000 | -26.8045 | 13.4169
1806.000000 | -26.8298 | 13.1159
1807.000000 | -26.8581 | 12.4654
1808.000000 | -26.8700 | 12.1765
1809.000000 | -26.8677 | 12.4980
1810.000000 | -26.8769 | 12.4190
1811.000000 | -26.9159 | 12.1178
1812.000000 | -26.9382 | 11.4368
1813.000000 | -26.9580 | 11.6928
1814.000000 | -26.9608 | 11.2891
1815.000000 | -26.9832 | 11.3321
1816.000000 | -27.0076 | 11.1995
1817.000000 | -27.0195 | 11.1124
1818.000000 | -27.0384 | 10.2981
1819.000000 | -27.0399 | 10.4831
1820.000000 | -27.0482 | 10.3330
1821.000000 | -27.0467 | 10.5117
1822.000000 | -27.0662 | 10.0062
1823.000000 | -27.0543 | 9.7729
1824.000000 | -27.0492 | 9.9053
1825.000000 | -27.0700 | 10.5809
1826.000000 | -27.0522 | 10.6939
1827.000000 | -27.0524 | 10.5568
1828.000000 | -27.0537 | 10.3566
1829.000000 | -27.0738 | 10.9826
1830.000000 | -27.0728 | 11.0553
1831.000000 | -27.1004 | 11.1249
1832.000000 | -27.1272 | 11.0410
1833.000000 | -27.0781 | 12.6140
1834.000000 | -27.0666 | 12.1576
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
