VictoriacTorres/euVNA/Codigos/Yo/Archivos csv resultados-calibracion/S11_sincalibracion_corto_2_2nov.csv

freq_rf_MHz | modulo_S11_dB | fase_S11_deg
1800.000000 | -14.0070 | 136.9988
1801.000000 | -13.9589 | 136.5792
1802.000000 | -13.8549 | 135.5611
1803.000000 | -13.8408 | 134.9875
1804.000000 | -13.7983 | 134.8578
1805.000000 | -13.7653 | 134.5741
1806.000000 | -13.7191 | 134.0427
1807.000000 | -13.6227 | 133.2955
1808.000000 | -13.5497 | 132.8627
1809.000000 | -13.5296 | 132.8027
1810.000000 | -13.5007 | 132.6378
1811.000000 | -13.4653 | 132.1940
1812.000000 | -13.3758 | 131.5119
1813.000000 | -13.3362 | 131.2577
1814.000000 | -13.2776 | 130.9916
1815.000000 | -13.2530 | 130.6742
1816.000000 | -13.2268 | 130.2380
1817.000000 | -13.1700 | 129.8938
1818.000000 | -13.0628 | 129.2932
1819.000000 | -13.0354 | 129.3193
1820.000000 | -12.9657 | 129.0519
1821.000000 | -12.9604 | 129.0220
1822.000000 | -12.8842 | 128.5172
1823.000000 | -12.7866 | 128.2406
1824.000000 | -12.7502 | 128.2091
1825.000000 | -12.7784 | 128.3872
1826.000000 | -12.7622 | 128.5872
1827.000000 | -12.6956 | 128.2645
1828.000000 | -12.6230 | 128.0788
1829.000000 | -12.6529 | 128.0798
1830.000000 | -12.6569 | 127.9548
1831.000000 | -12.6770 | 127.6295
1832.000000 | -12.6448 | 127.2931
1833.000000 | -12.3558 | 127.8496
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
