VictoriacTorres/euVNA/Codigos/Yo/Archivos csv resultados-calibracion/S11_sincalibracion_corto_2nov.csv

freq_rf_MHz | modulo_S11_dB | fase_S11_deg
1800.000000 | -13.9879 | 136.3035
1801.000000 | -13.9388 | 135.8785
1802.000000 | -13.8318 | 134.8989
1803.000000 | -13.8173 | 134.2797
1804.000000 | -13.7748 | 134.1667
1805.000000 | -13.7531 | 133.9919
1806.000000 | -13.6967 | 133.3344
1807.000000 | -13.6023 | 132.5558
1808.000000 | -13.5304 | 132.1601
1809.000000 | -13.5210 | 132.2409
1810.000000 | -13.4866 | 131.9163
1811.000000 | -13.4511 | 131.4882
1812.000000 | -13.3535 | 130.7823
1813.000000 | -13.3177 | 130.5795
1814.000000 | -13.2662 | 130.3057
1815.000000 | -13.2334 | 129.9035
1816.000000 | -13.2088 | 129.4957
1817.000000 | -13.1371 | 129.0551
1818.000000 | -13.0185 | 128.3966
1819.000000 | -12.9911 | 128.3981
1820.000000 | -12.9214 | 128.1261
1821.000000 | -12.9247 | 128.0896
1822.000000 | -12.8497 | 127.6333
1823.000000 | -12.7425 | 127.3732
1824.000000 | -12.7181 | 127.4115
1825.000000 | -12.7395 | 127.4680
1826.000000 | -12.7196 | 127.7324
1827.000000 | -12.6574 | 127.3982
1828.000000 | -12.5825 | 127.1952
1829.000000 | -12.6335 | 127.3172
1830.000000 | -12.6205 | 127.0745
1831.000000 | -12.6258 | 126.7163
1832.000000 | -12.6043 | 126.4219
1833.000000 | -12.4939 | 127.3189
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
