VictoriacTorres/euVNA/Codigos/Yo/Archivos csv resultados-calibracion/S11_sincalibracion_corto_3_2nov.csv

freq_rf_MHz | modulo_S11_dB | fase_S11_deg
1800.000000 | -14.1421 | 137.8564
1801.000000 | -14.0576 | 137.1291
1802.000000 | -14.0192 | 136.5384
1803.000000 | -13.9545 | 136.2895
1804.000000 | -13.9245 | 135.2005
1805.000000 | -13.8997 | 135.2306
1806.000000 | -13.7972 | 134.2877
1807.000000 | -13.7843 | 134.0842
1808.000000 | -13.6953 | 133.6382
1809.000000 | -13.6824 | 133.3621
1810.000000 | -13.6140 | 132.9165
1811.000000 | -13.5171 | 132.1870
1812.000000 | -13.5106 | 131.9819
1813.000000 | -13.4361 | 131.5980
1814.000000 | -13.3708 | 130.8780
1815.000000 | -13.3716 | 130.9862
1816.000000 | -13.2524 | 130.0147
1817.000000 | -13.2876 | 130.2741
1818.000000 | -13.1793 | 129.6123
1819.000000 | -13.1038 | 128.9391
1820.000000 | -13.0930 | 129.0858
1821.000000 | -13.0029 | 128.6814
1822.000000 | -12.9496 | 128.4104
1823.000000 | -12.8379 | 128.1369
1824.000000 | -12.8398 | 127.9734
1825.000000 | -12.8267 | 128.1975
1826.000000 | -12.6706 | 128.0050
1827.000000 | -12.7340 | 128.1801
1828.000000 | -12.6598 | 128.0242
1829.000000 | -12.6792 | 127.7952
1830.000000 | -12.6467 | 127.6763
1831.000000 | -12.5343 | 127.1168
1832.000000 | -12.6151 | 127.1148
1833.000000 | -12.5676 | 127.0347
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
