VictoriacTorres/euVNA/Codigos/Yo/Archivos csv resultados-calibracion/S11_sincalibracion_nueva_2nov.csv

freq_rf_MHz | modulo_S11_dB | fase_S11_deg
1800.000000 | -0.5081 | -9.9370
1801.000000 | -2.7031 | 19.3190
1802.000000 | -4.6420 | 44.3571
1803.000000 | -6.9782 | -10.1595
1804.000000 | -25.6214 | 53.3265
1805.000000 | -12.3142 | 16.0255
1806.000000 | -12.8356 | -40.7206
1807.000000 | -4.7326 | -34.9832
1808.000000 | -9.1519 | 51.2037
1809.000000 | -5.1238 | 12.8394
1810.000000 | -3.0828 | 49.1315
1811.000000 | -5.8236 | 55.0728
1812.000000 | -13.3629 | -138.9544
1813.000000 | -1.1513 | -18.1757
1814.000000 | -3.4700 | 49.8086
1815.000000 | -9.6014 | -27.1737
1816.000000 | -3.9909 | -35.5533
1817.000000 | -1.2308 | -50.7487
1818.000000 | -12.3828 | -173.5185
1819.000000 | -1.4582 | -131.2009
1820.000000 | -10.2919 | -3.3743
1821.000000 | -15.7369 | 110.6468
1822.000000 | 1.0264 | -134.1990
1823.000000 | -12.2680 | -56.9188
1824.000000 | -1.7660 | 23.9745
1825.000000 | 1.1589 | 31.9418
1826.000000 | -7.7645 | -1.5955
1827.000000 | -4.6899 | 8.1512
1828.000000 | -10.8354 | 66.9397
1829.000000 | -12.4338 | -113.8366
1830.000000 | -7.6105 | 5.7200
1831.000000 | -7.0557 | -8.0955
1832.000000 | -13.1939 | -51.5019
1833.000000 | -8.2112 | 22.0753
1834.000000 | -7.1139 | -70.8007
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
