VictoriacTorres/euVNA/Codigos/Yo/Imagenes codigos/50R_1700a2300_1M_calibrado.png

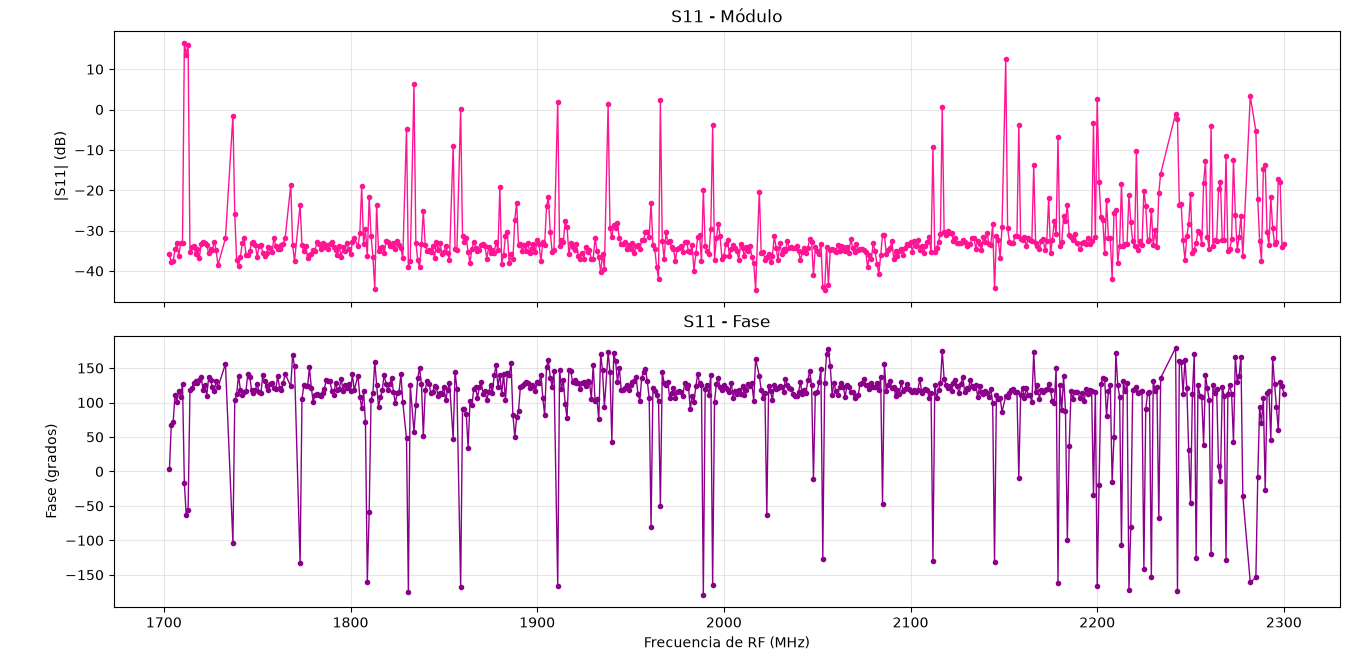
Codigos/Yo/Imagenes codigos/50R_1700a2300_1M_calibrado.png
