VictoriacTorres/euVNA/Codigos/Yo/Imagenes codigos/1700a2300_calibrado_FI10k_abierto2.png

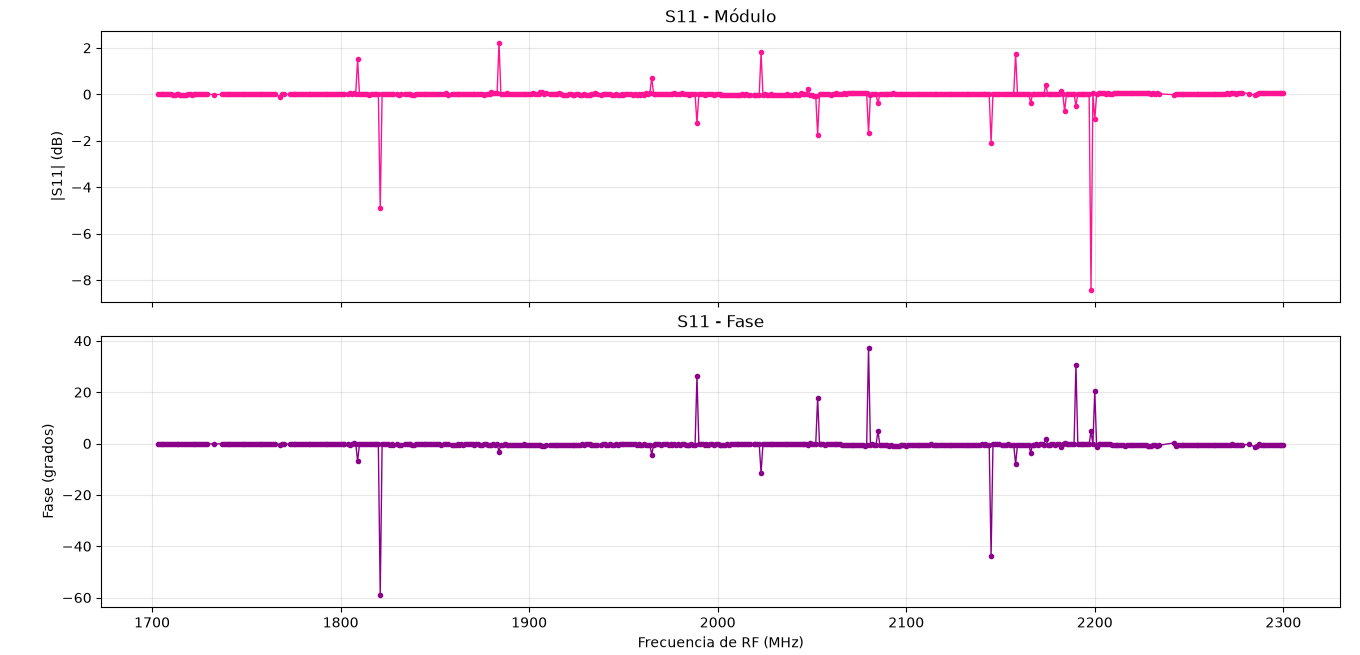
Codigos/Yo/Imagenes codigos/1700a2300_calibrado_FI10k_abierto2.png
