VictoriacTorres/euVNA/Codigos/Yo/Imagenes codigos/1700a2300_sincalibrar_abierto.png

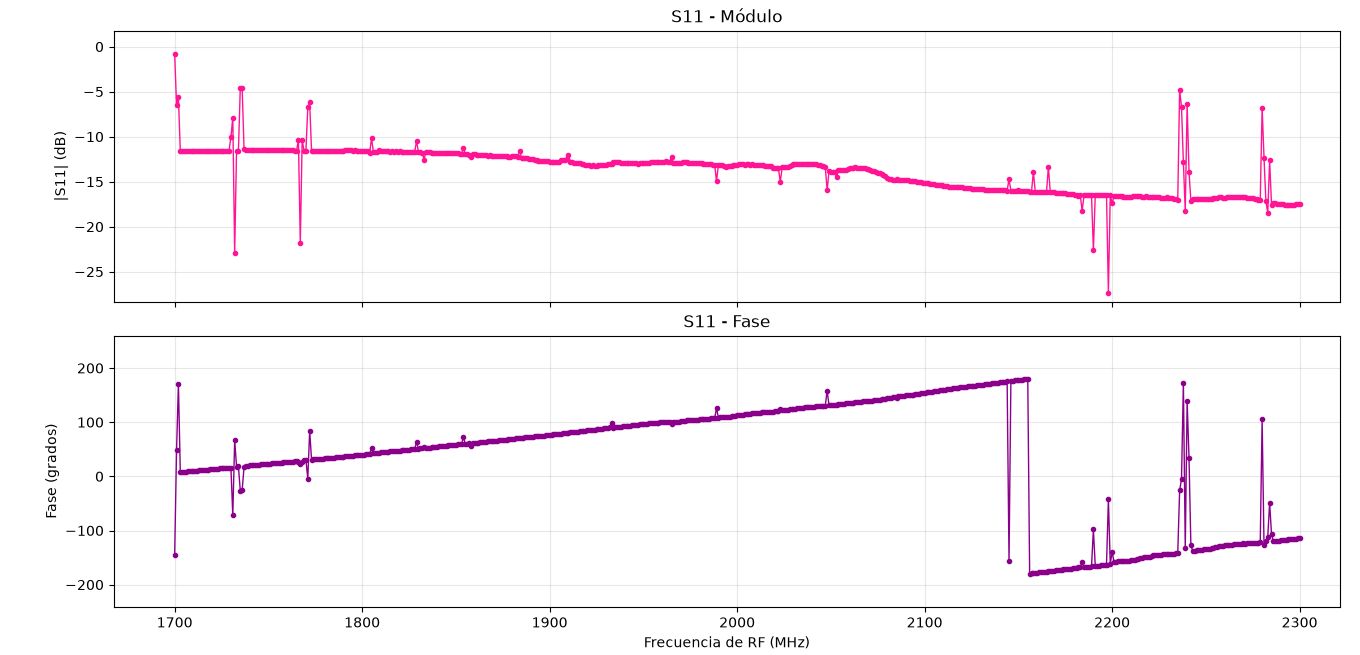
Codigos/Yo/Imagenes codigos/1700a2300_sincalibrar_abierto.png
