VictoriacTorres/euVNA/Codigos/Yo/Imagenes/1700a2300_calibrado_FI10k_abierto.png

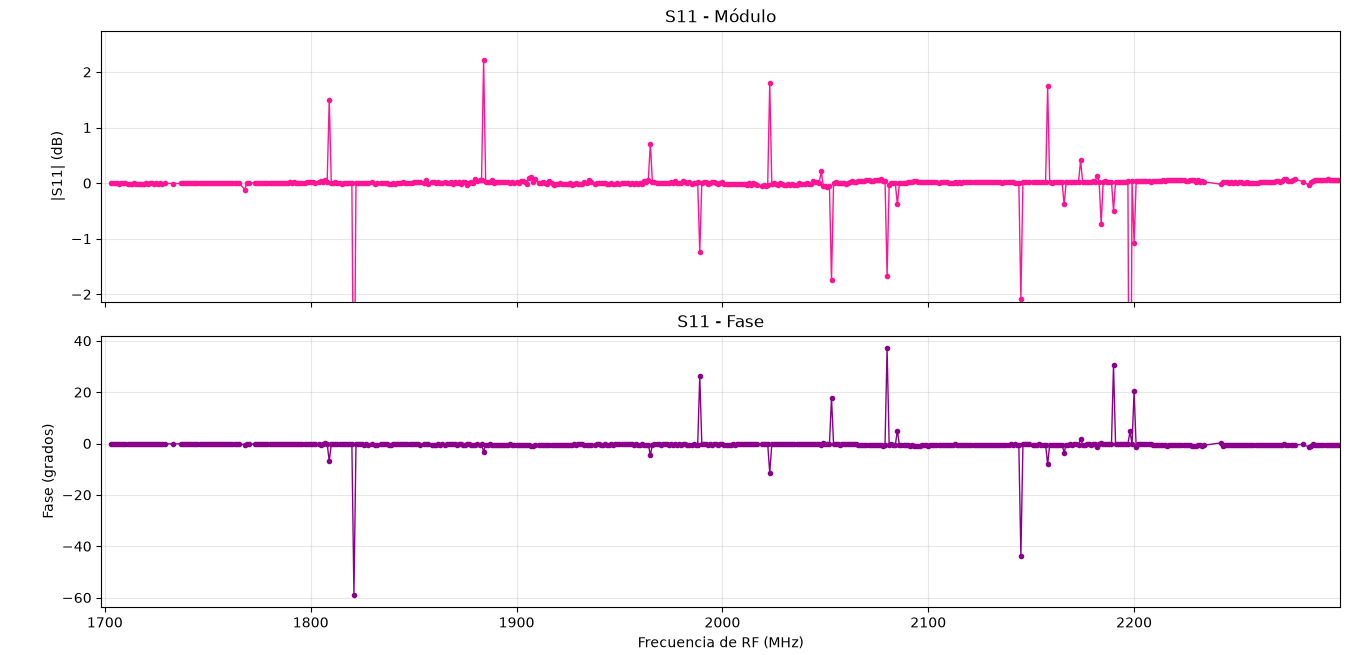
Codigos/Yo/Imagenes/1700a2300_calibrado_FI10k_abierto.png
