VictoriacTorres/euVNA/Codigos/Yo/Imagenes/corto_1700a2300_1M_calibrado.png

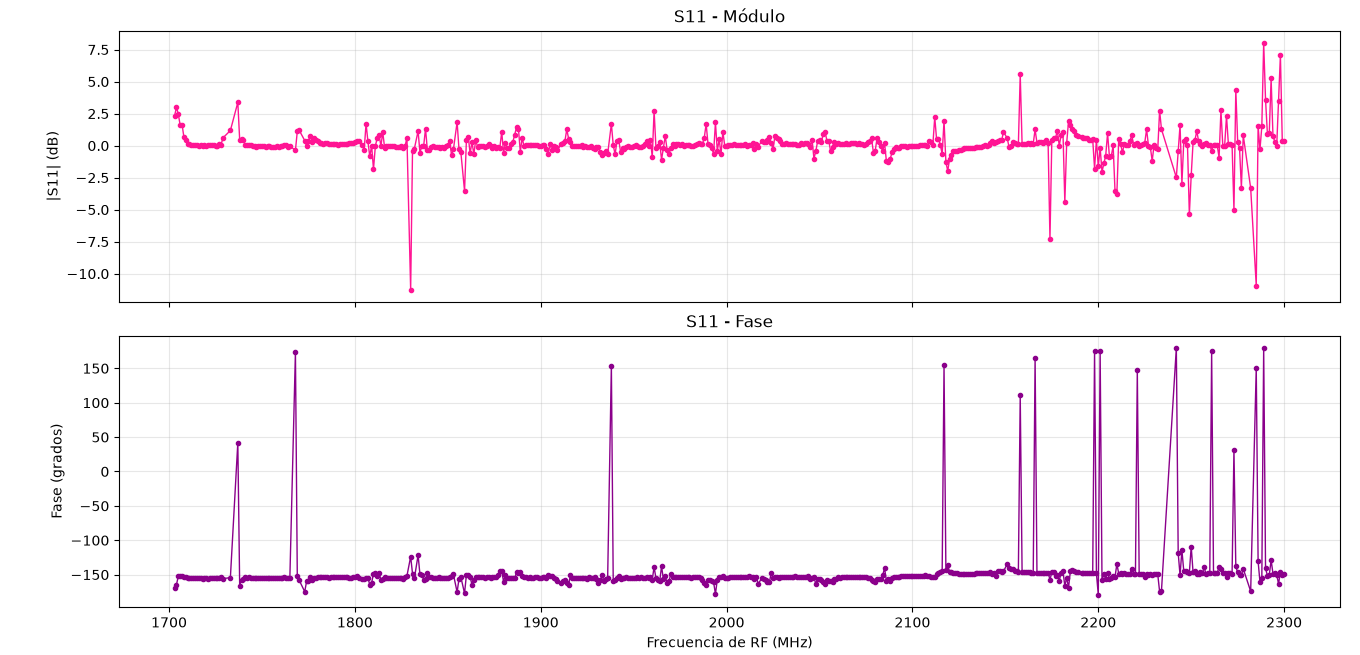
Codigos/Yo/Imagenes/corto_1700a2300_1M_calibrado.png
