VictoriacTorres/euVNA/Tesis/Esquematicos.pdf

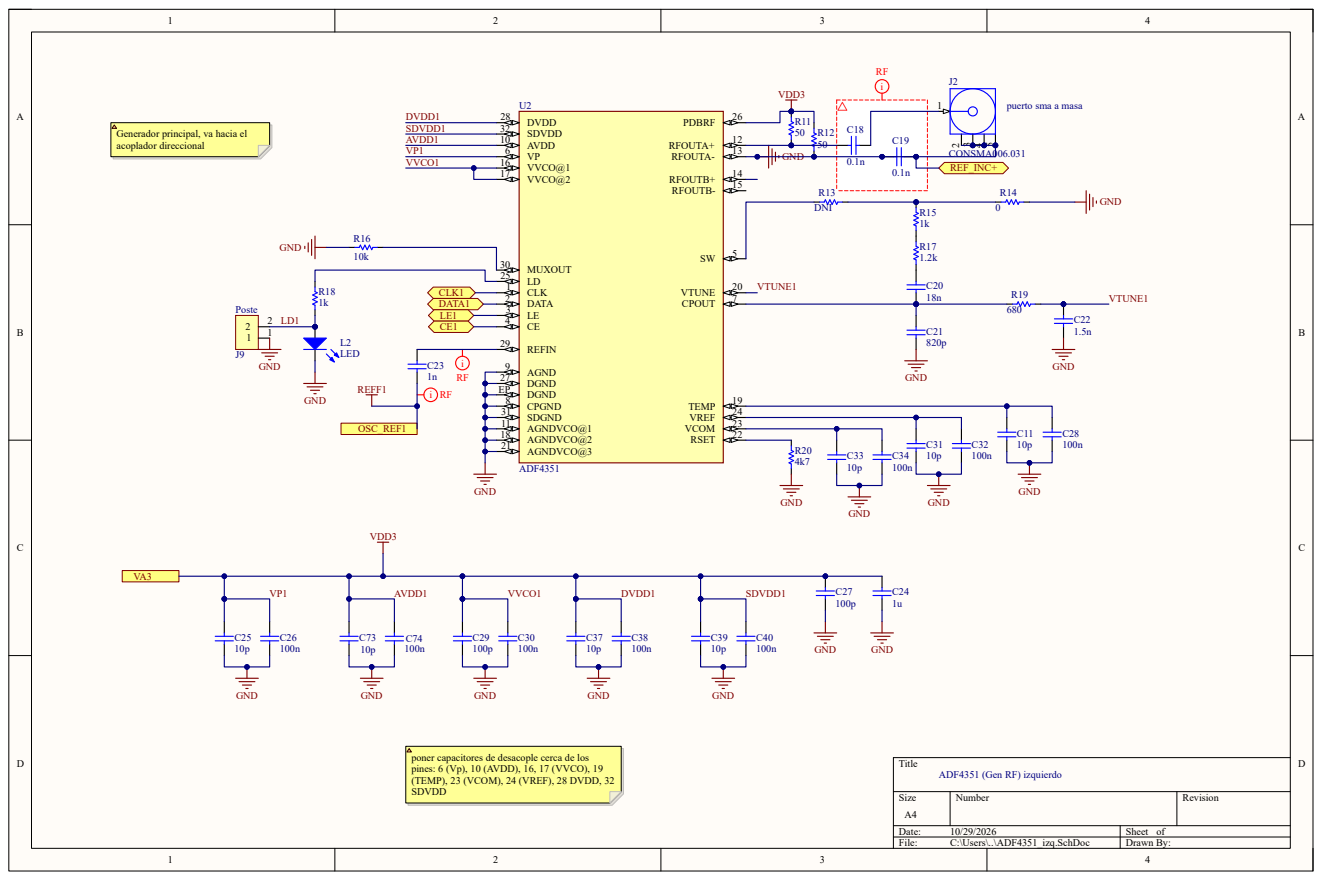
[picture p145: page 1]

Generador principal, va hacia el
acoplador direccional

poner capacitores de desacople cerca de los
pines: 6 (Vp), 10 (AVDD), 16, 17 (VVCO), 19
(TEMP), 23 (VCOM), 24 (VREF), 28 DVDD, 32
SDVDD

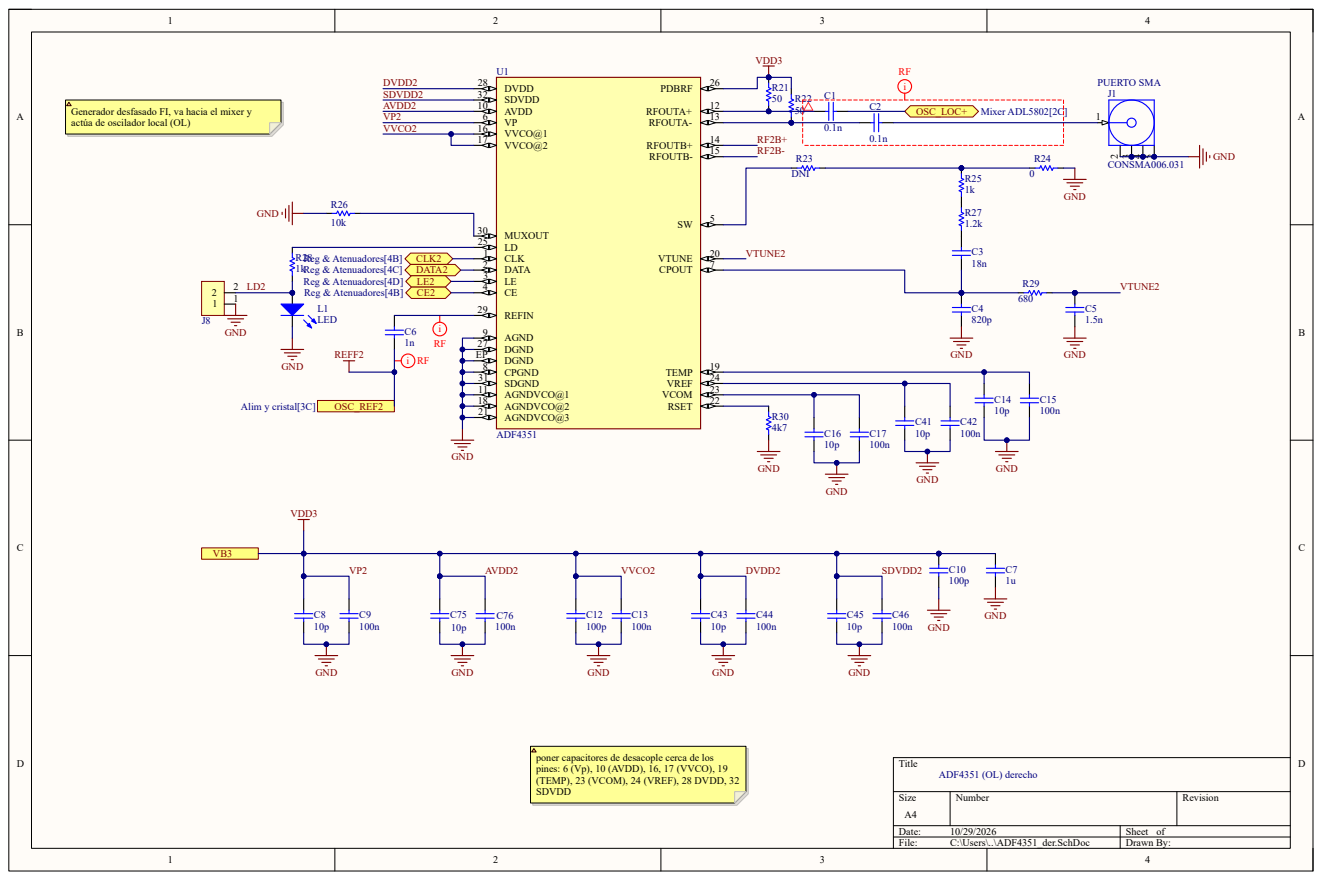
[picture p146: page 2]

Generador desfasado FI, va hacia el mixer y
actúa de oscilador local (OL)

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

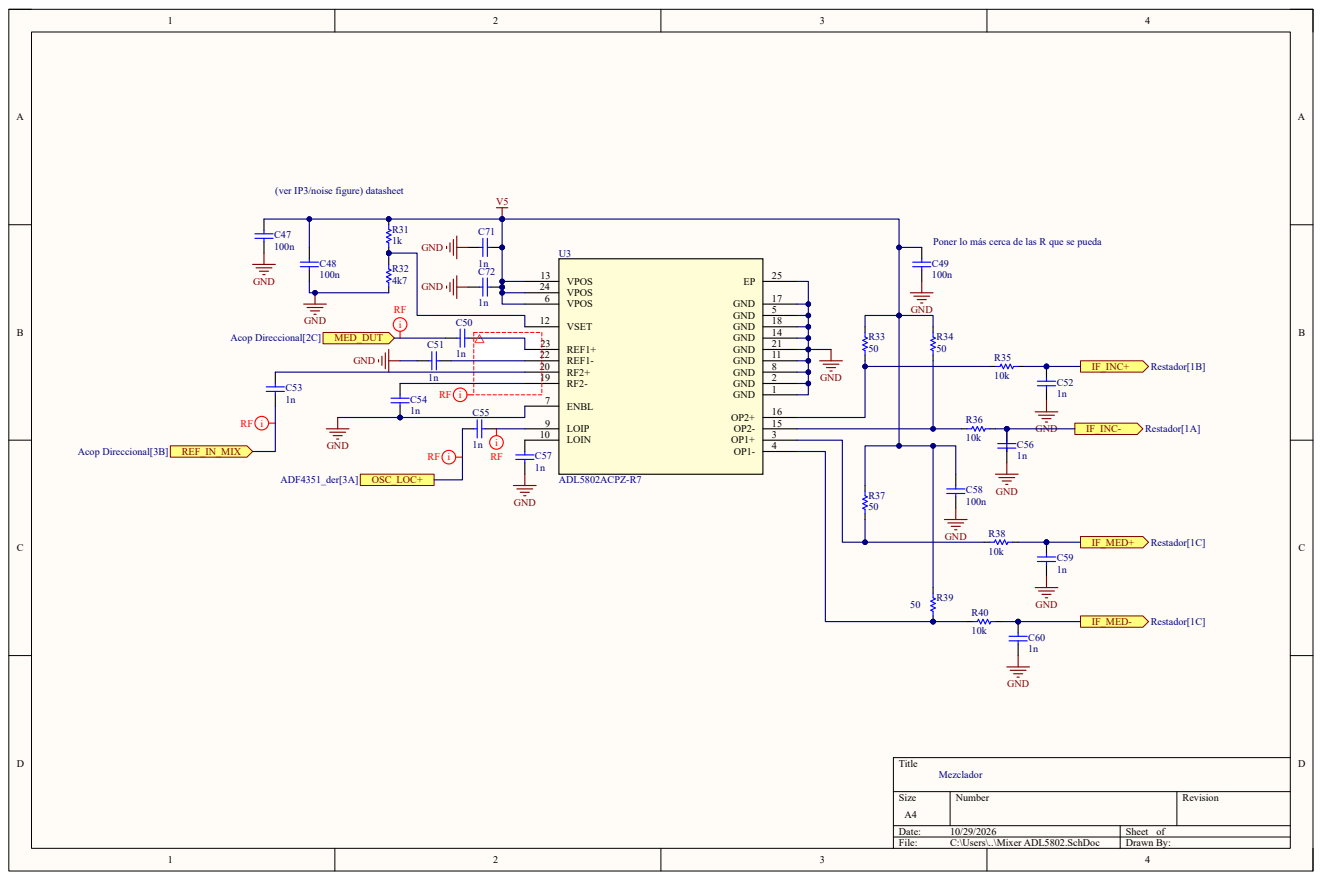
[picture p147: page 3]

(ver IP3/noise figure) datasheet

Poner lo más cerca de las R que se pueda

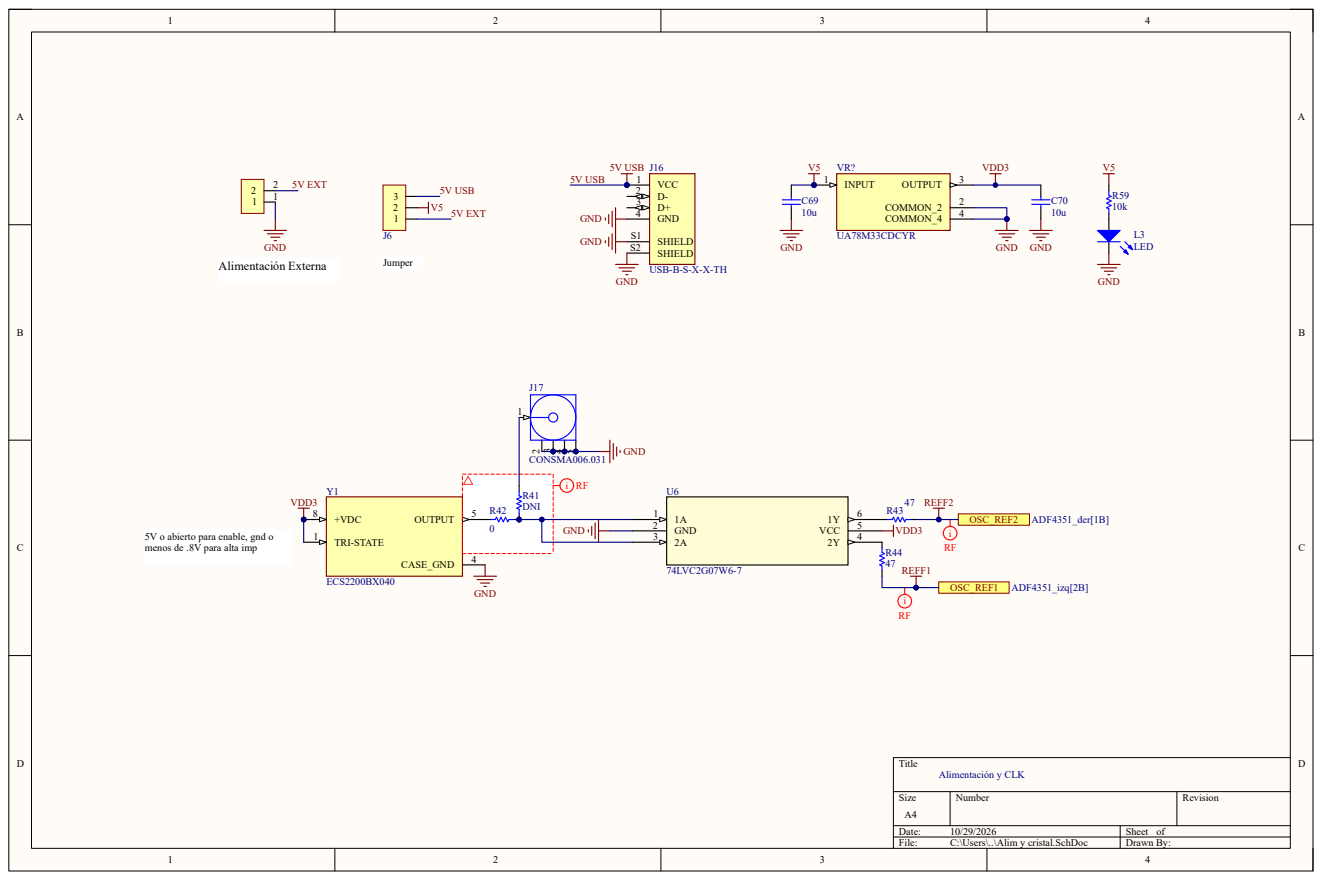
[picture p148: page 4]

5V o abierto para enable, gnd o
menos de .8V para alta imp

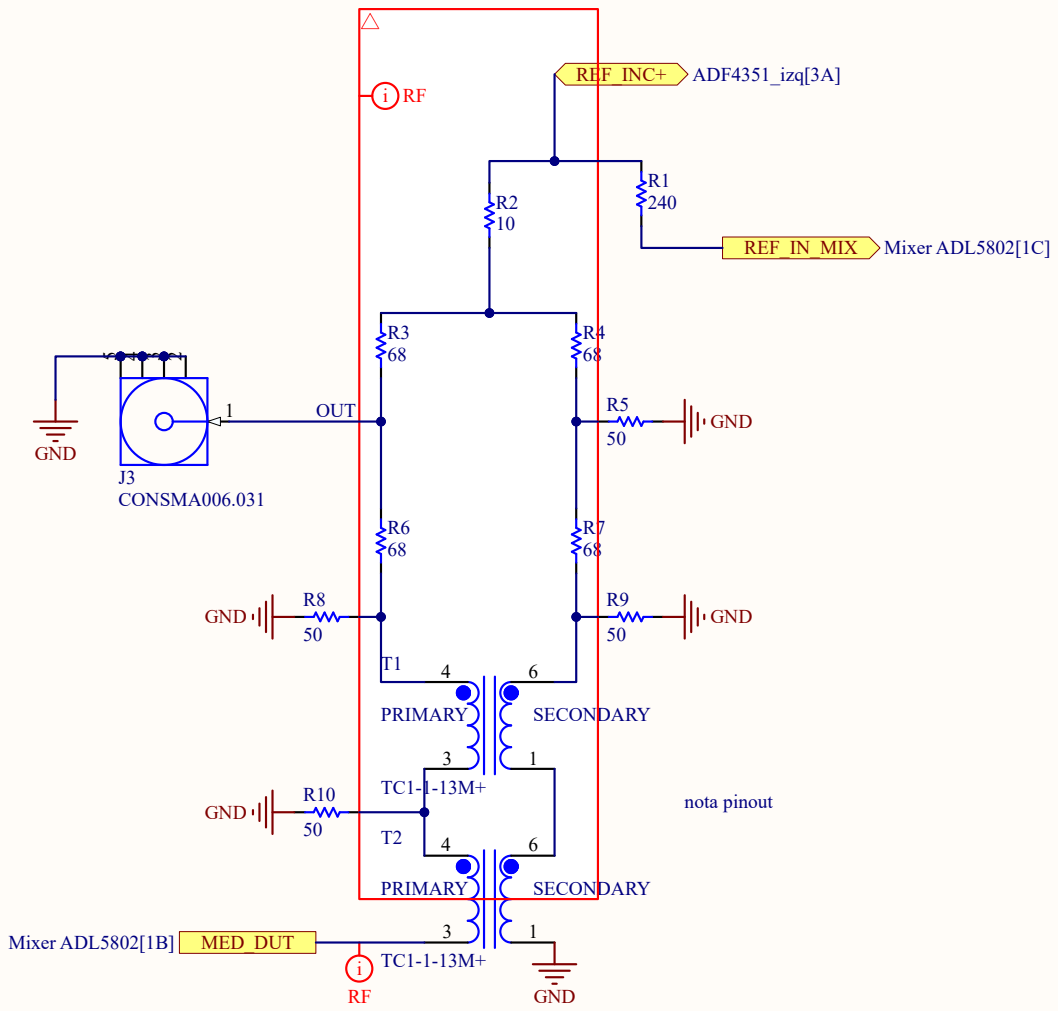
[picture p149: page 5]

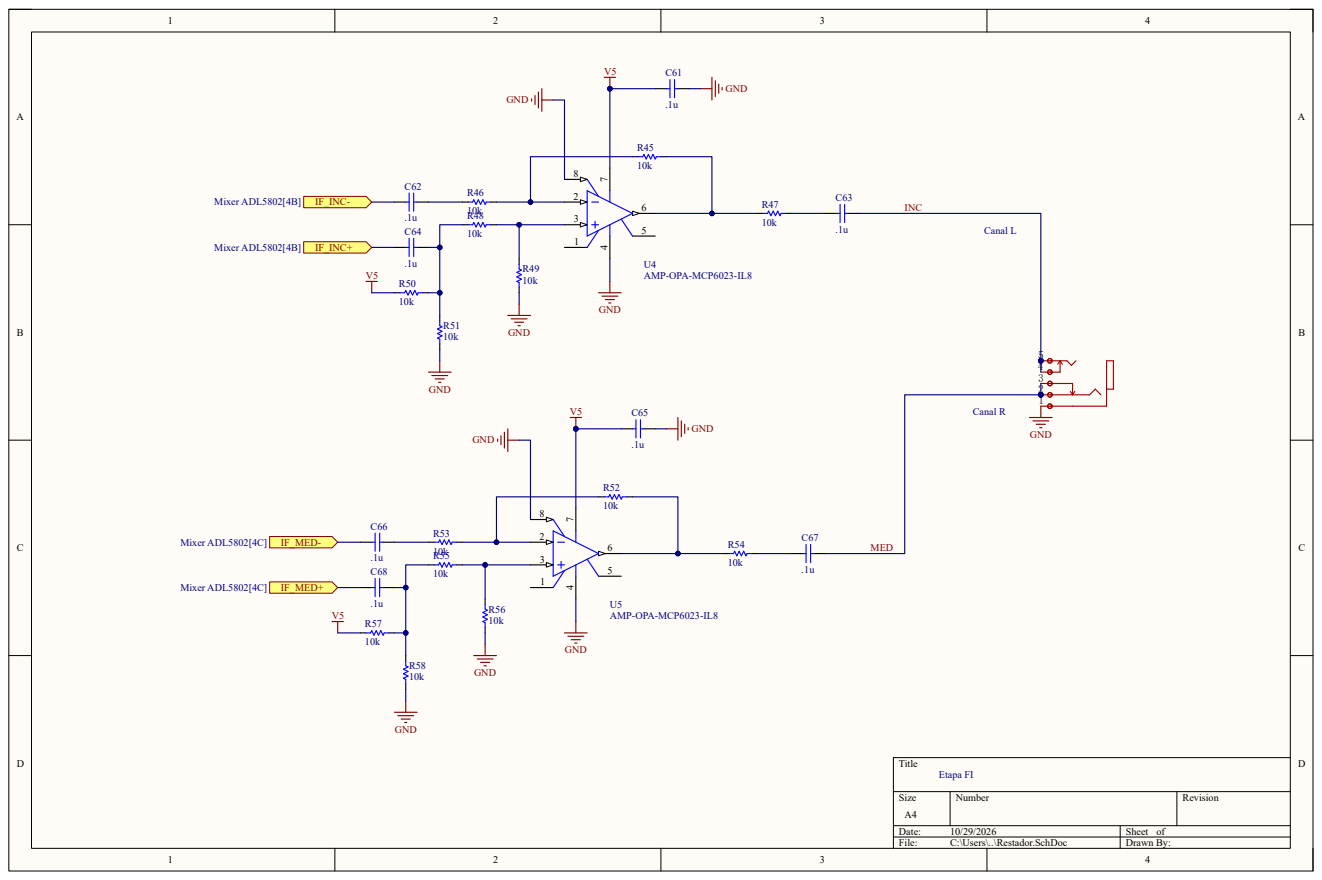
[picture p150: page 6]

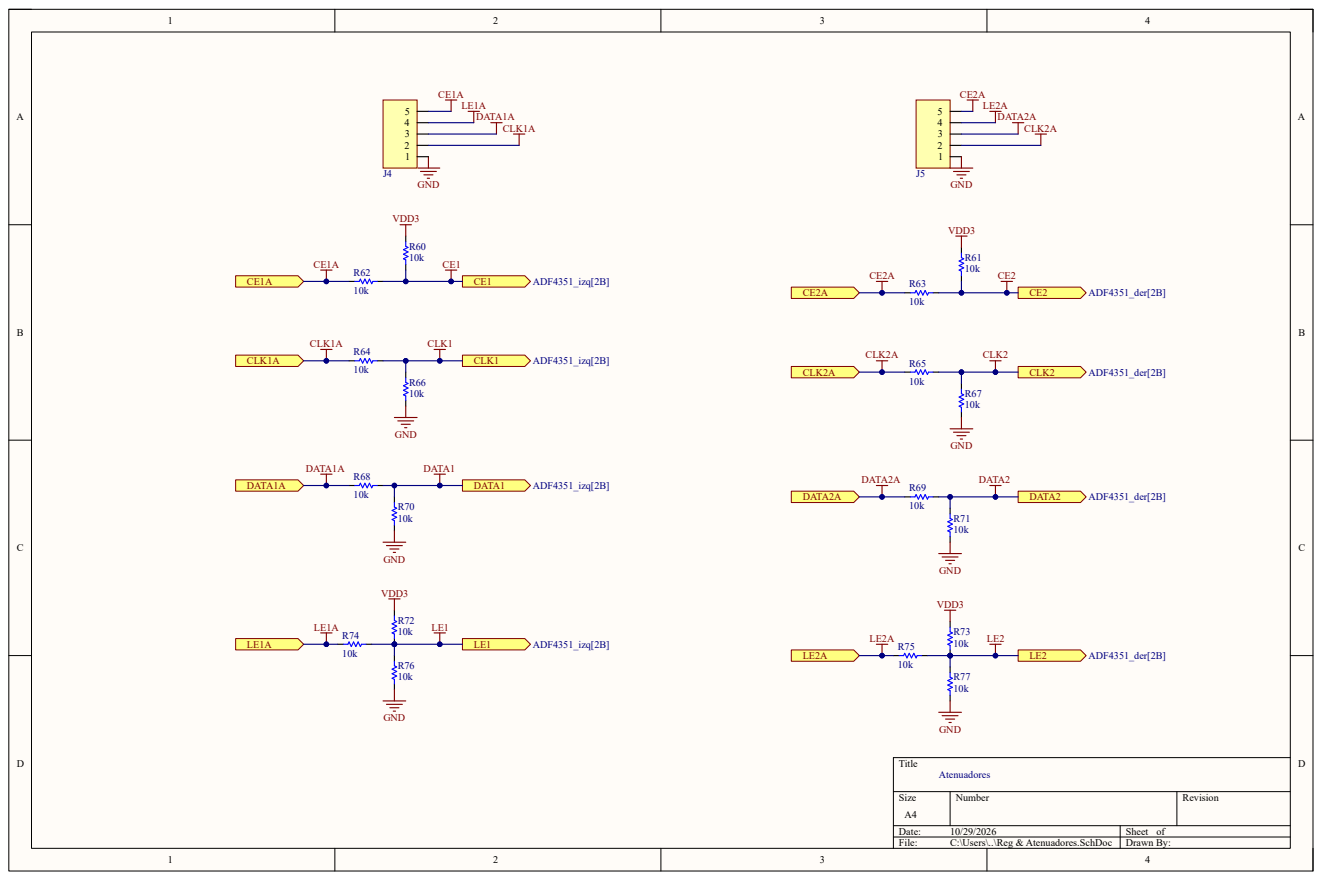
[picture p151: page 7]
