VictoriacTorres/euVNA/Tesis/Imagenes/Screens euVNA v2.pdf

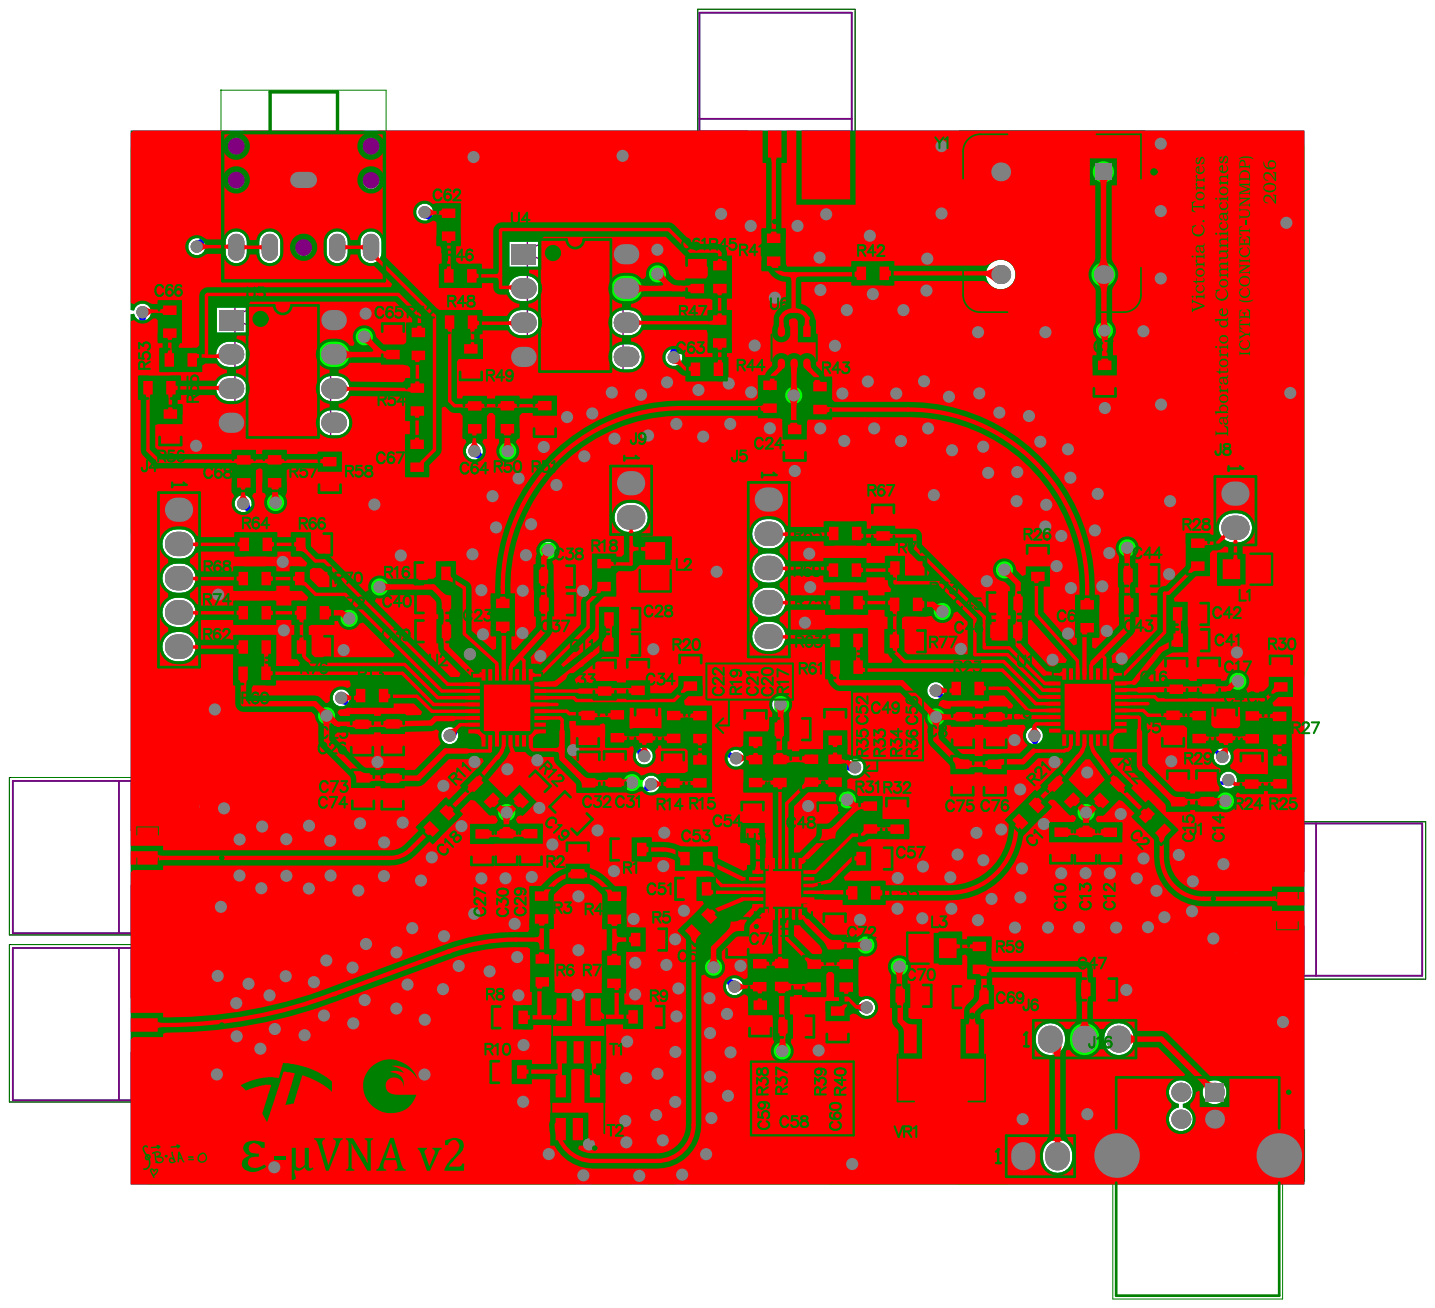
[picture p152: page 1]

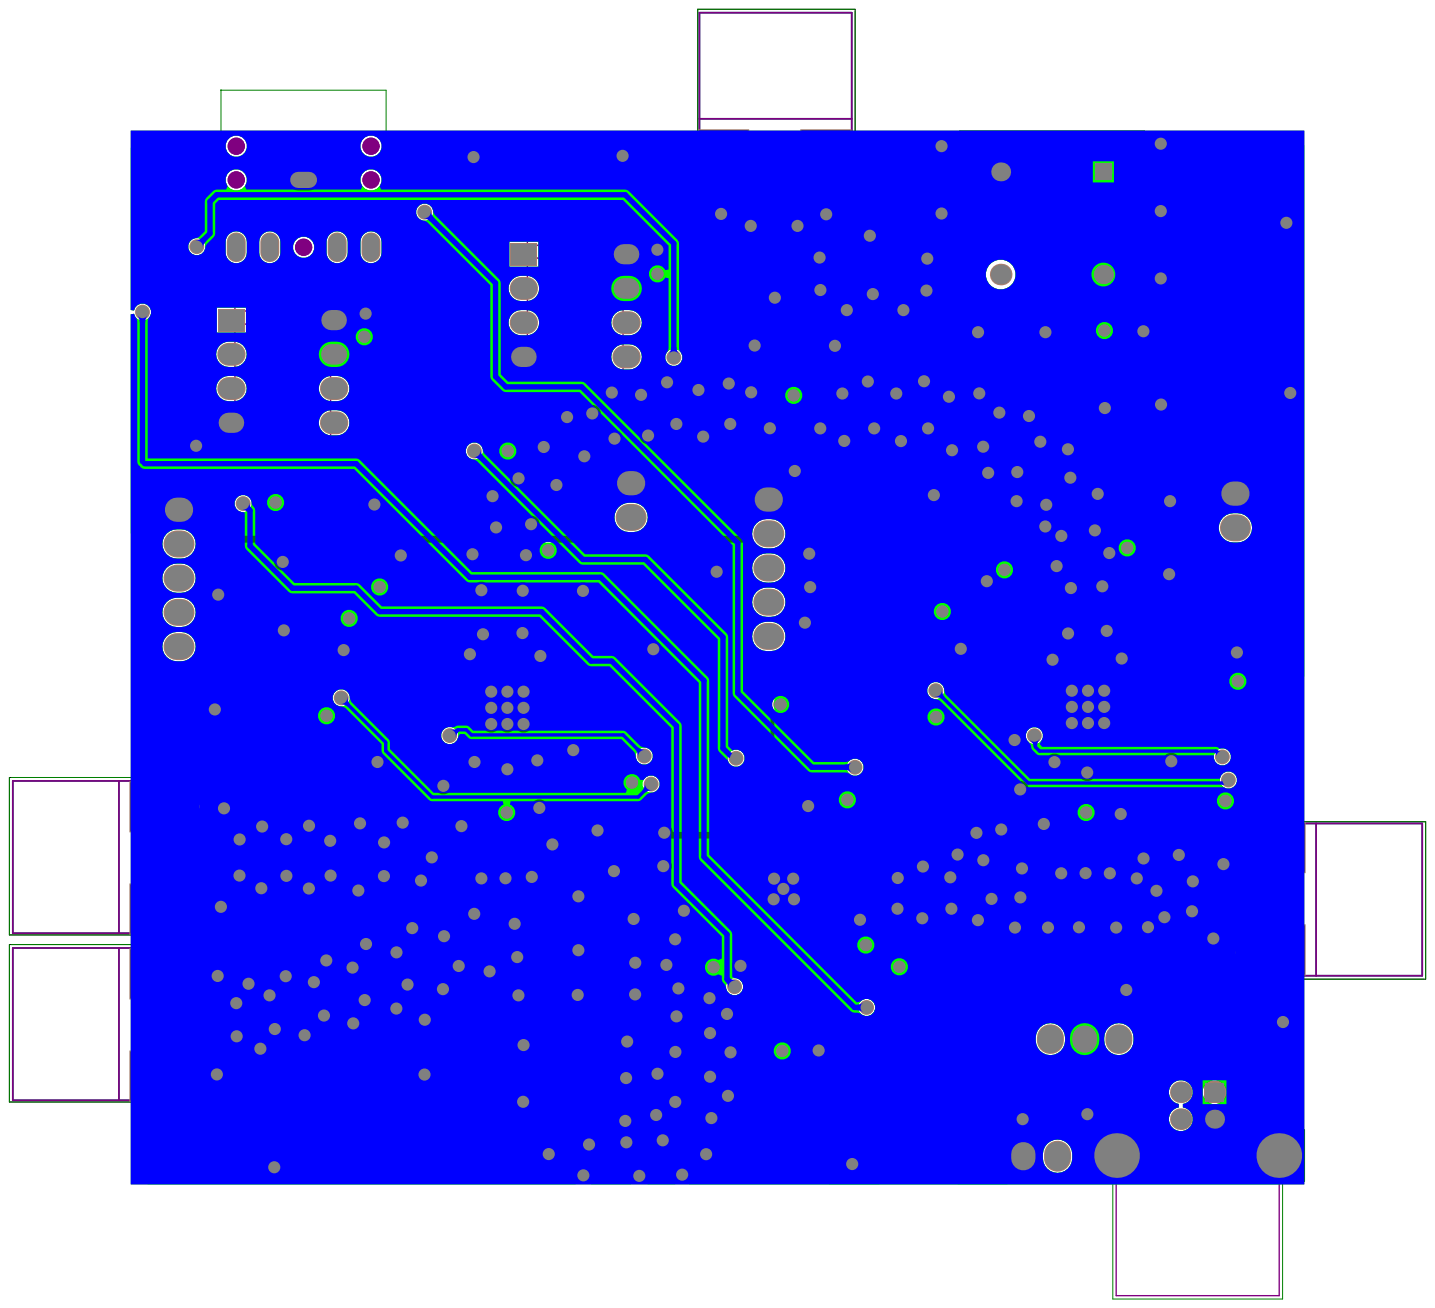
[picture p153: page 2]
