VictoriacTorres/euVNA/Tesis/Imagenes/Screens euVNA v1.pdf

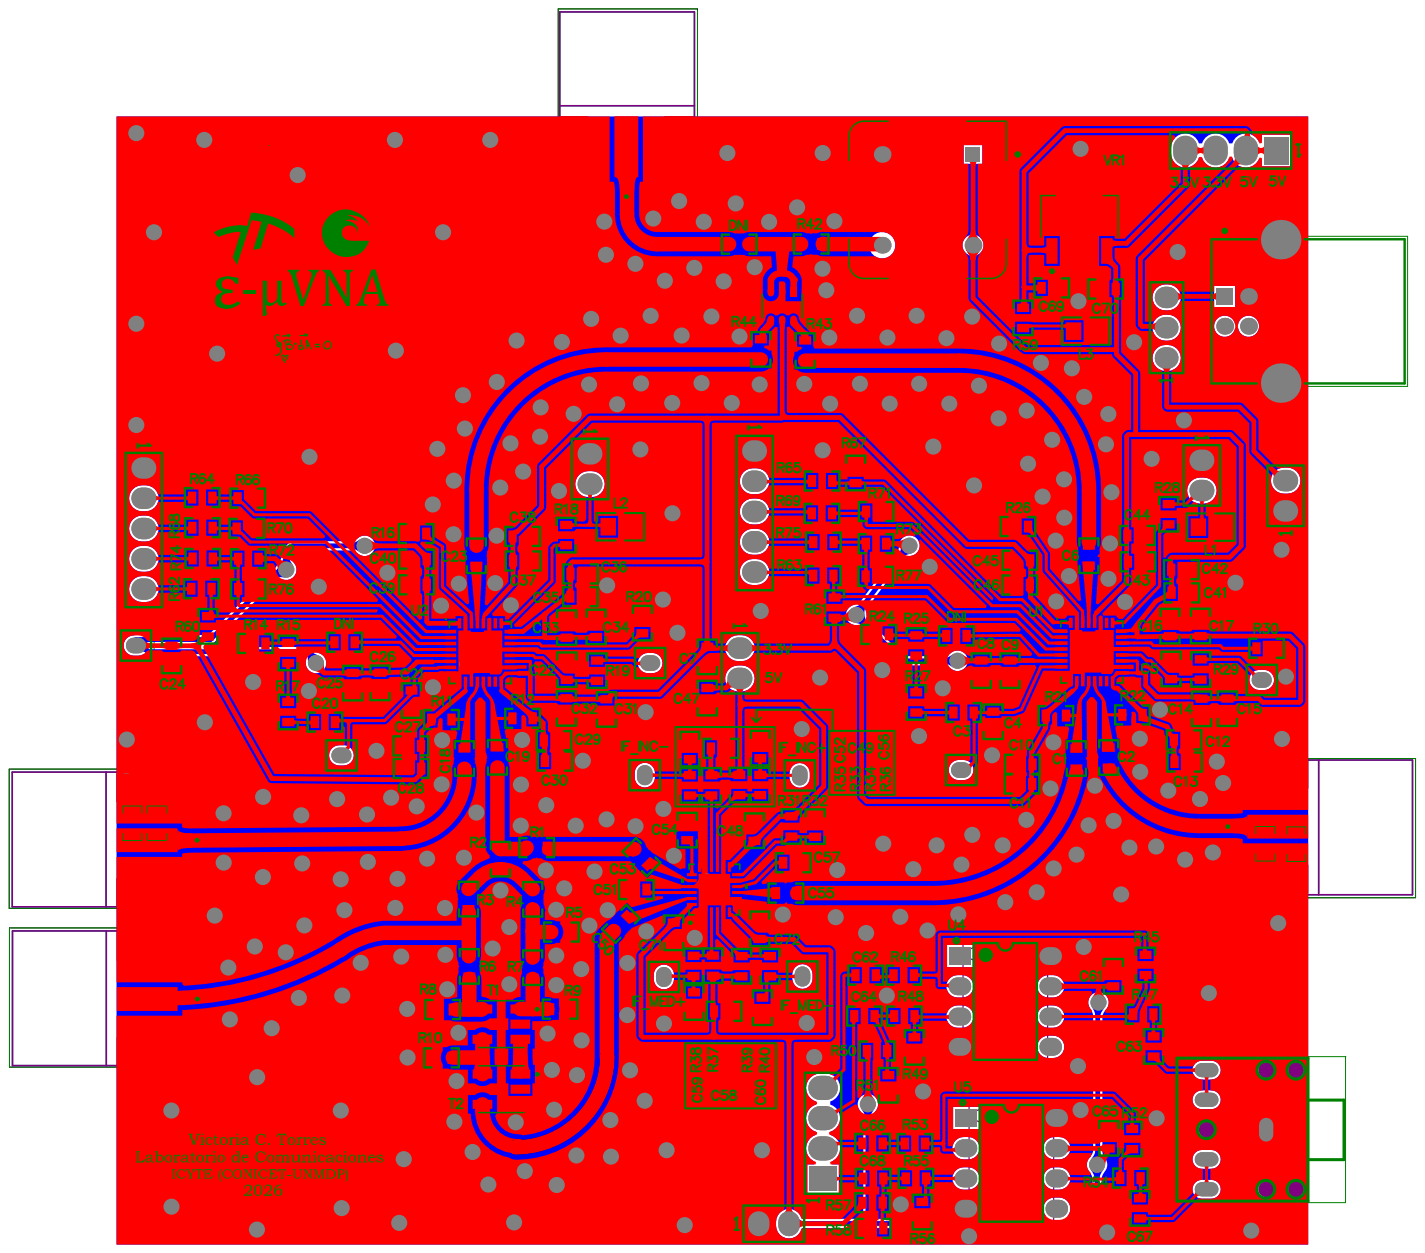
[picture p154: page 1]

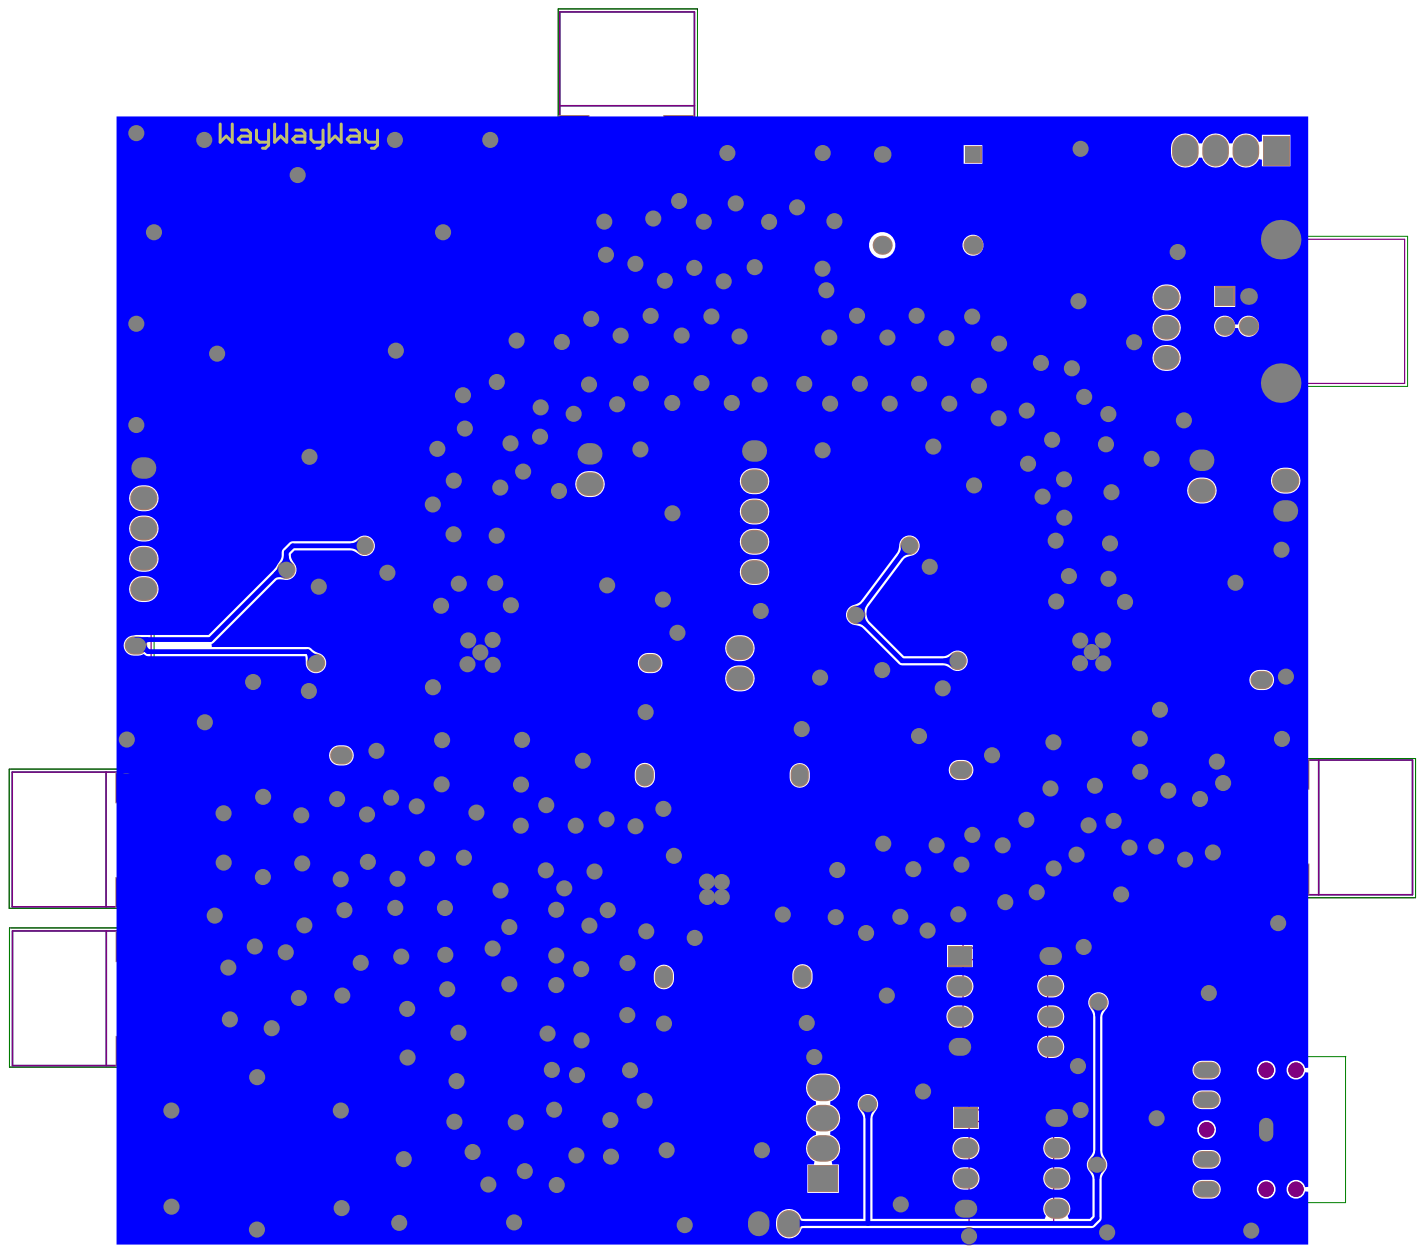
[picture p155: page 2]
