VictoriacTorres/euVNA/(commit log)

2026-08-27 Primer commit del proyecto euVNA
    [50R_1700a2300_1M_calibrado.csv, S11_sincalibracion_sinsaltear_10k.csv, barrido.xlsx, calibracion_1700.0_2300.0_1.0.csv, calibracion_1700.0_2300.0_5.0.csv, calibracion_1800.0_2200.0_10.0.csv, frecuencias_desenganchadas.csv, frecuencias_desenganchadas_ADFderecho.csv]
2026-08-28 Orden + borre el que hacia la calibración y lo guardaba en un .npz
    [50R_1700a2300_1M_calibrado.csv, S11_sincalibracion_sinsaltear_10k.csv, calibracion_1700.0_2300.0_1.0.csv, calibracion_1700.0_2300.0_5.0.csv, calibracion_1800.0_2200.0_10.0.csv, resultados_s11.csv, resultados_s11_1M_abierto.csv, s11_1700.000_2300.000_5.000.csv]
2026-08-29 mediciones 28/7
    [calibracion_1800.0_2200.0_1.0.csv, resultado_1800.0_2200.0_1.0_calibrado.csv]
2026-09-05 mediciones sensor
    [resultado_1800.0_2200.0_1.0_calibrado_SENSOR.csv]
2026-09-09 sin lineas
    [calibracion_1800.0_2200.0_1.0 - signo corregido.csv, calibracion_1800.0_2200.0_1.0 - signo corregido.xlsx, datos_export_cal_1800a22001M.csv, resultado_1800.0_2200.0_1.0_calibrado_SENSOR.csv]
2026-09-15 pruebas fs audio
    [calibracion_1850.0_1950.0_1.0.csv, resultado_1850.0_1950.0_1.0_calibrado_SENSOR.csv]
2026-09-22 medicion nueva
    [calibracion_1800.0_2200.0_1.0.csv, resultado_1800.0_2200.0_1.0_calibrado_50R.csv, resultado_1800.0_2200.0_1.0_calibrado_SENSOR.csv]
2026-10-07 mediciones 7oct
    [resultado_1800.0_2200.0_1.0_50Rvieja_7oct.csv, resultado_1800.0_2200.0_1.0_cableabierto_7oct.csv]
2026-10-08 mediciones y ancho banda 500hz
    [calibracion_1000a2800dea10_8oct.csv]
2026-10-15 mediciones sensor y 15/10
